svpetry/Mini8086/VGA/amber.bmp

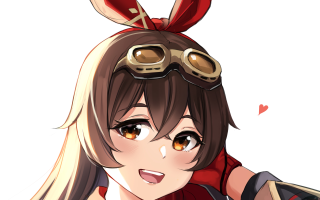
VGA/amber.bmp
