svpetry/Mini8086/VGA/kizuna-ai.bmp

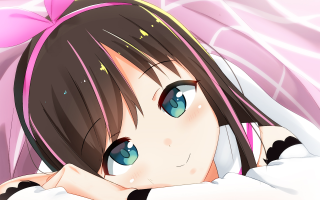
VGA/kizuna-ai.bmp
