svpetry/Mini8086/Documents/special_keys.md

# ASCII codes for special keys

| code | key |
| --- | --- |
| 0x01 | left |
| 0x02 | up |
| 0x03 | right |
| 0x04 | down |
| 0x05 | home |
| 0x06 | end |
| 0x07 | pause/break |
| 0x08 | backspace |
| 0x09 | tab |
| 0x0A | new line |
| 0x0B | page up |
| 0x0C | page down |
| 0x0D | carriage return |
| 0x0E | |
| 0x0F | F1 |
| 0x10 | F2 |
| 0x11 | F3 |
| 0x12 | F4 |
| 0x13 | F5 |
| 0x14 | F6 |
| 0x15 | F7 |
| 0x16 | F8 |
| 0x17 | F9 |
| 0x18 | F10 |
| 0x19 | F11 |
| 0x1A | F12 |
| 0x1B | escape |
| 0x1C | insert |
| 0x1D | |
| 0x1E | |
| 0x1F | |
