svpetry/Mini8086/Documents/I2C.md

| device | address |
| --- | --- |
| BME280 Sensor	| 0x77 |
| DS1307 RTC | 0x68 |
| M24C04 EEprom | 0x50 (1010_A2_A1_A0) |
