svpetry/Mini8086/Documents/memory map.md

# 64K / block

|||
|---|---|
| 00000-0FFFF | RAM (256 KB) |
| 10000-1FFFF | RAM (256 KB) |
| 20000-2FFFF | RAM (256 KB) |
| 30000-3FFFF | RAM (256 KB) |
| 40000-4FFFF | RAM (512 KB) |
| 50000-5FFFF | RAM (512 KB) |
| 60000-6FFFF | RAM (512 KB) |
| 70000-7FFFF | RAM (512 KB) |
| 80000-8FFFF | RAM bank switchable (768+ KB) |
| 90000-9FFFF | RAM bank switchable (768+ KB) |
| A0000-AFFFF | RAM bank switchable (768+ KB) |
| B0000-BFFFF | RAM bank switchable (768+ KB) |
| C0000-CFFFF | Video RAM |
| D0000-DFFFF | Video RAM |
| E0000-EFFFF | ROM |
| F0000-FFFFF | ROM |

---

|||
|---|---|
| 00000-003FF | 8086 interrupt vectors |
| 00400-03FFF | BIOS data area |
| 04000-05000 | BIOS screen buffer |
| 05000-0FFFF | OS kernel code + data |
| 10000-xxxxx | user code |
