svpetry/Mini8086/Documents/other/5160_speaker_circuit.jpg

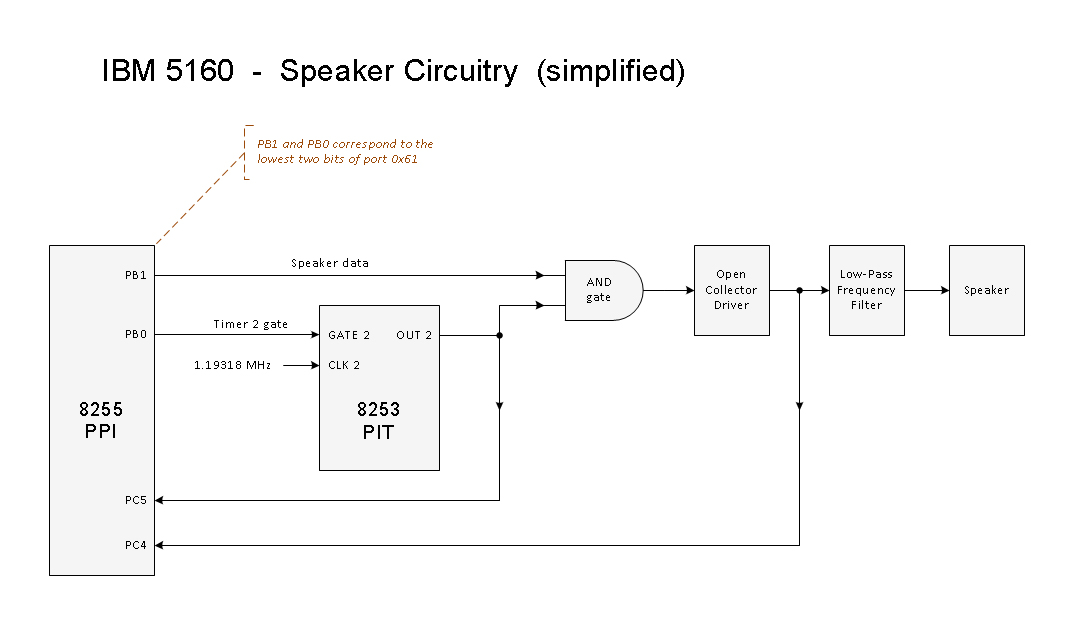
Documents/other/5160_speaker_circuit.jpg
