svpetry/Mini8086/Documents/other/8086sch.gif

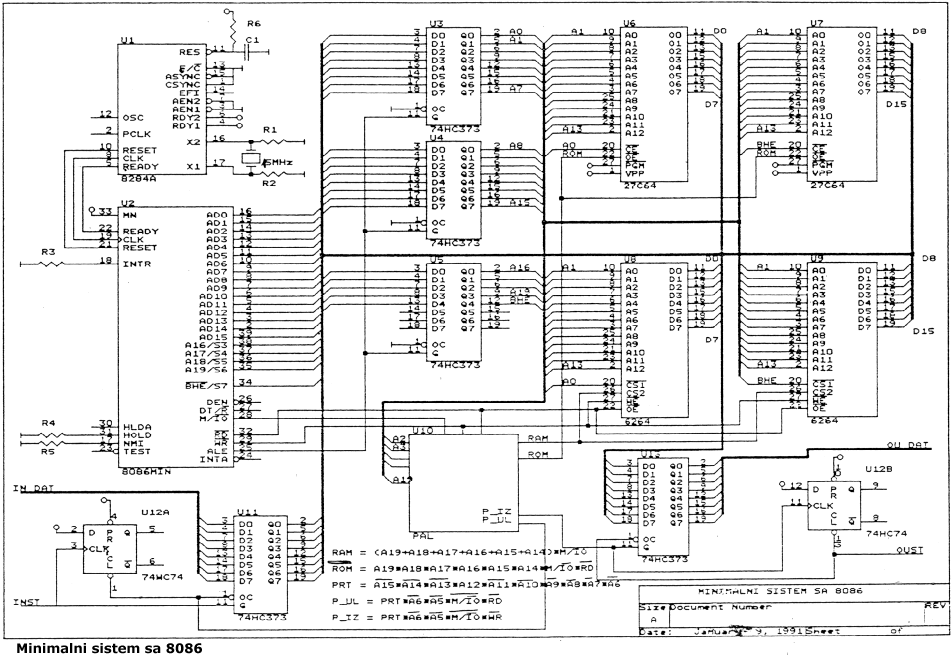
Documents/other/8086sch.gif
