svpetry/Mini8086/Documents/other/blockdiag_pc.png

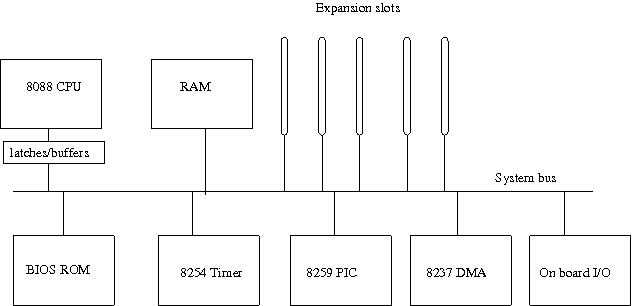
Documents/other/blockdiag_pc.png
