svpetry/Mini8086/Documents/other/EvenOdd.jpg

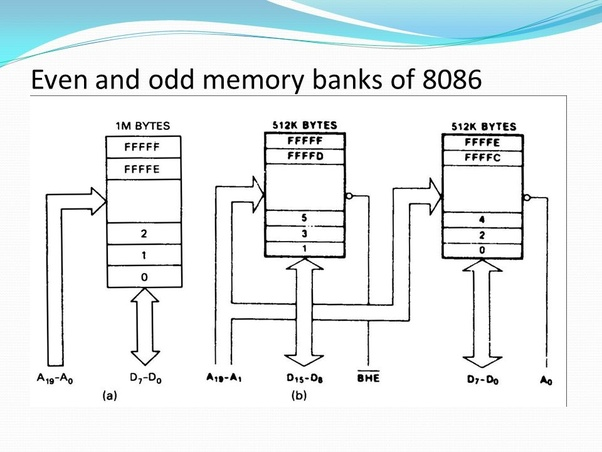
Documents/other/EvenOdd.jpg
