svpetry/Mini8086/Documents/other/freqdoubler.gif

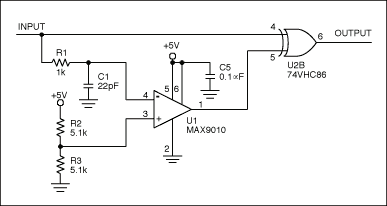
Documents/other/freqdoubler.gif
