svpetry/Mini8086/Documents/other/IBM 5170 - Keyboard interface - levels.png

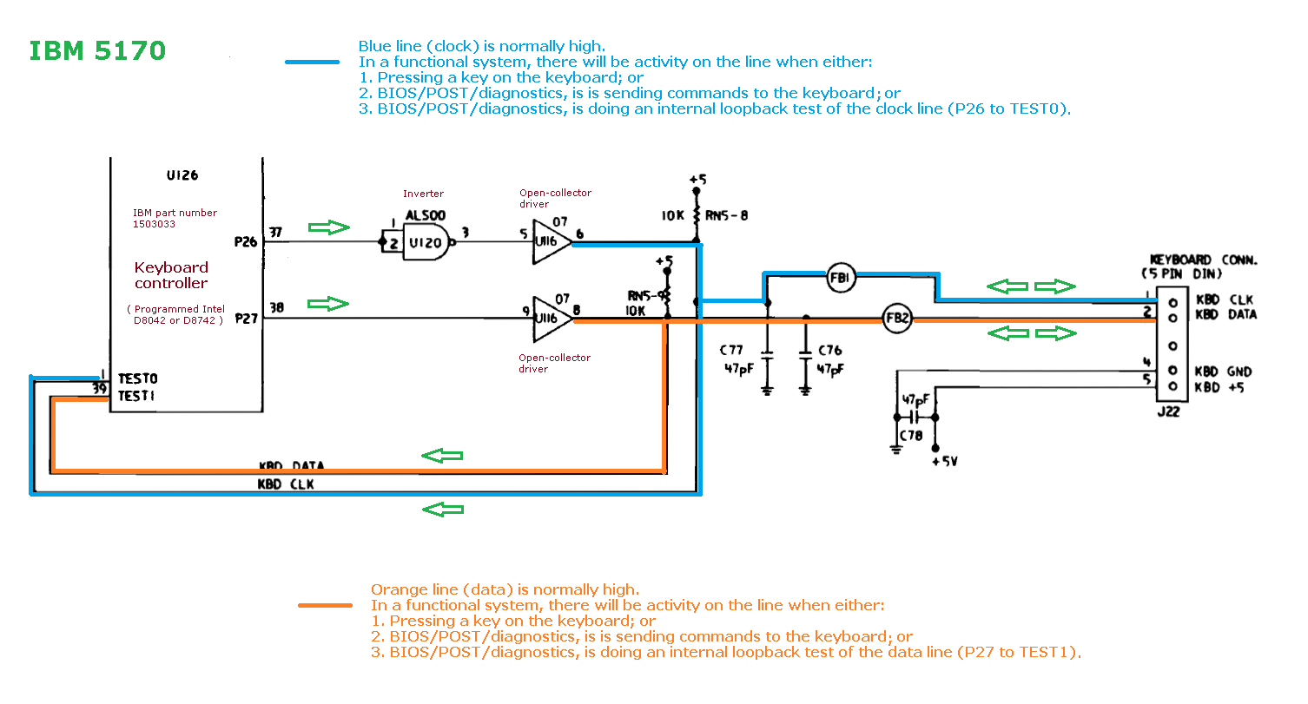
Documents/other/IBM 5170 - Keyboard interface - levels.png
