svpetry/Mini8086/Documents/other/ibm_pc_xt_block_diagram.png

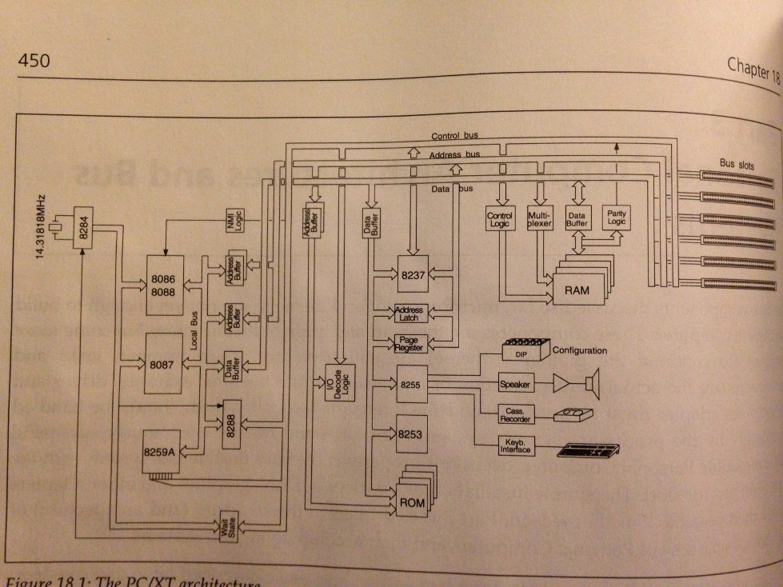
Documents/other/ibm_pc_xt_block_diagram.png
