svpetry/Mini8086/Documents/other/IMG_20171129_232521.jpg

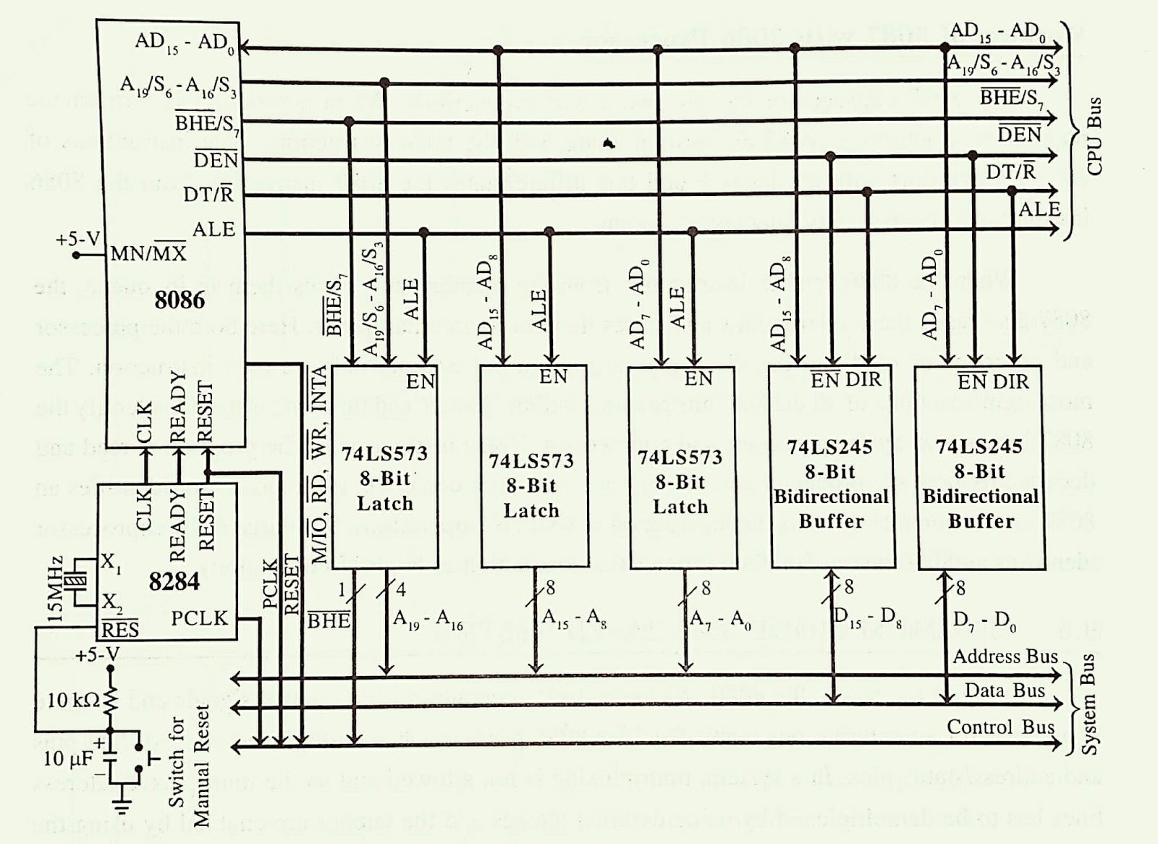
Documents/other/IMG_20171129_232521.jpg
