svpetry/Mini8086/Documents/other/maximum mode 8086 system.jpg

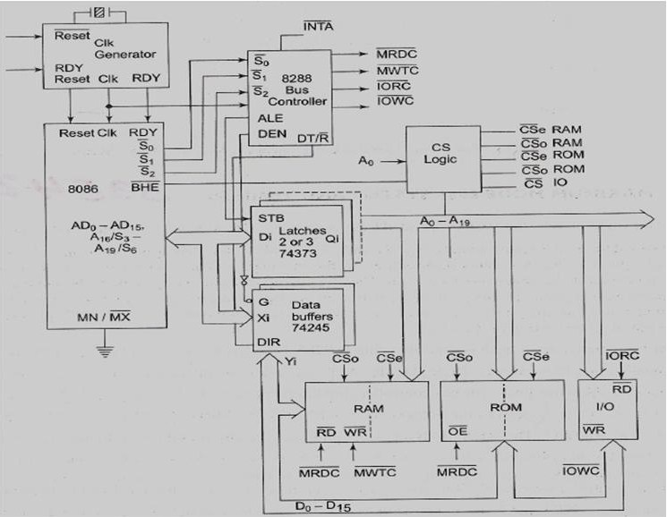
Documents/other/maximum mode 8086 system.jpg
