svpetry/Mini8086/Documents/other/MemoryBanks.jpg

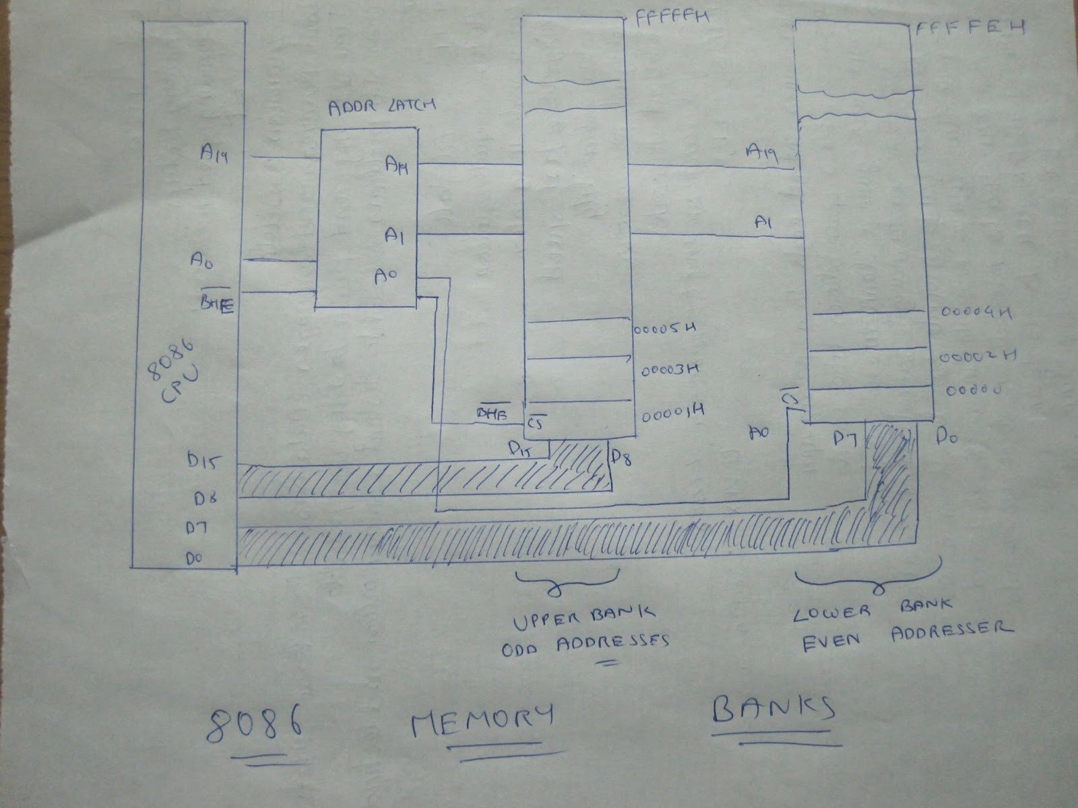
Documents/other/MemoryBanks.jpg
