svpetry/Mini8086/Documents/other/PS2+Keyboard+Scan+Codes.jpg

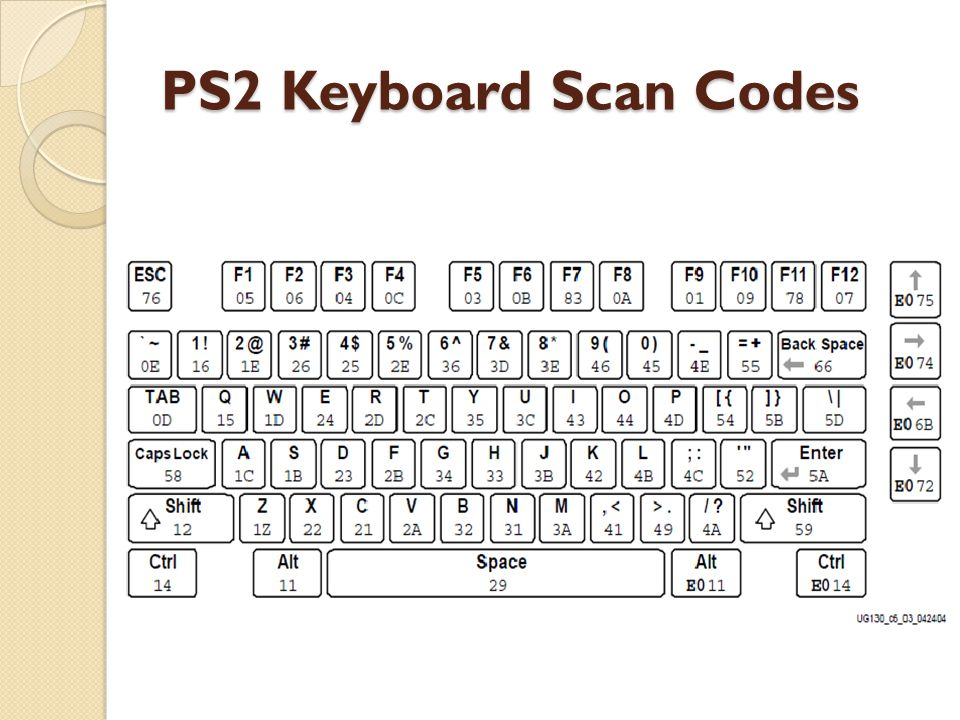
Documents/other/PS2+Keyboard+Scan+Codes.jpg
