svpetry/Mini8086/Documents/other/VGA pinout.jpg

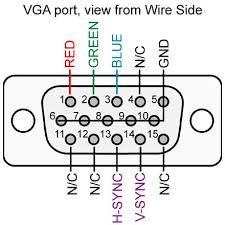
Documents/other/VGA pinout.jpg
