svpetry/Mini8086/VGA/Paimon.bmp

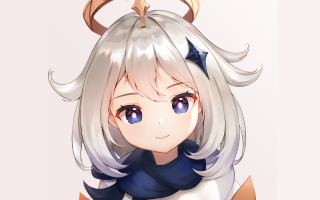
VGA/Paimon.bmp
