svpetry/Mini8086/KiCad/io_board_v2/io_board.kicad_pcb

## KiCad design KiCad/io_board_v2/io_board.kicad_pcb (2023-02-26)

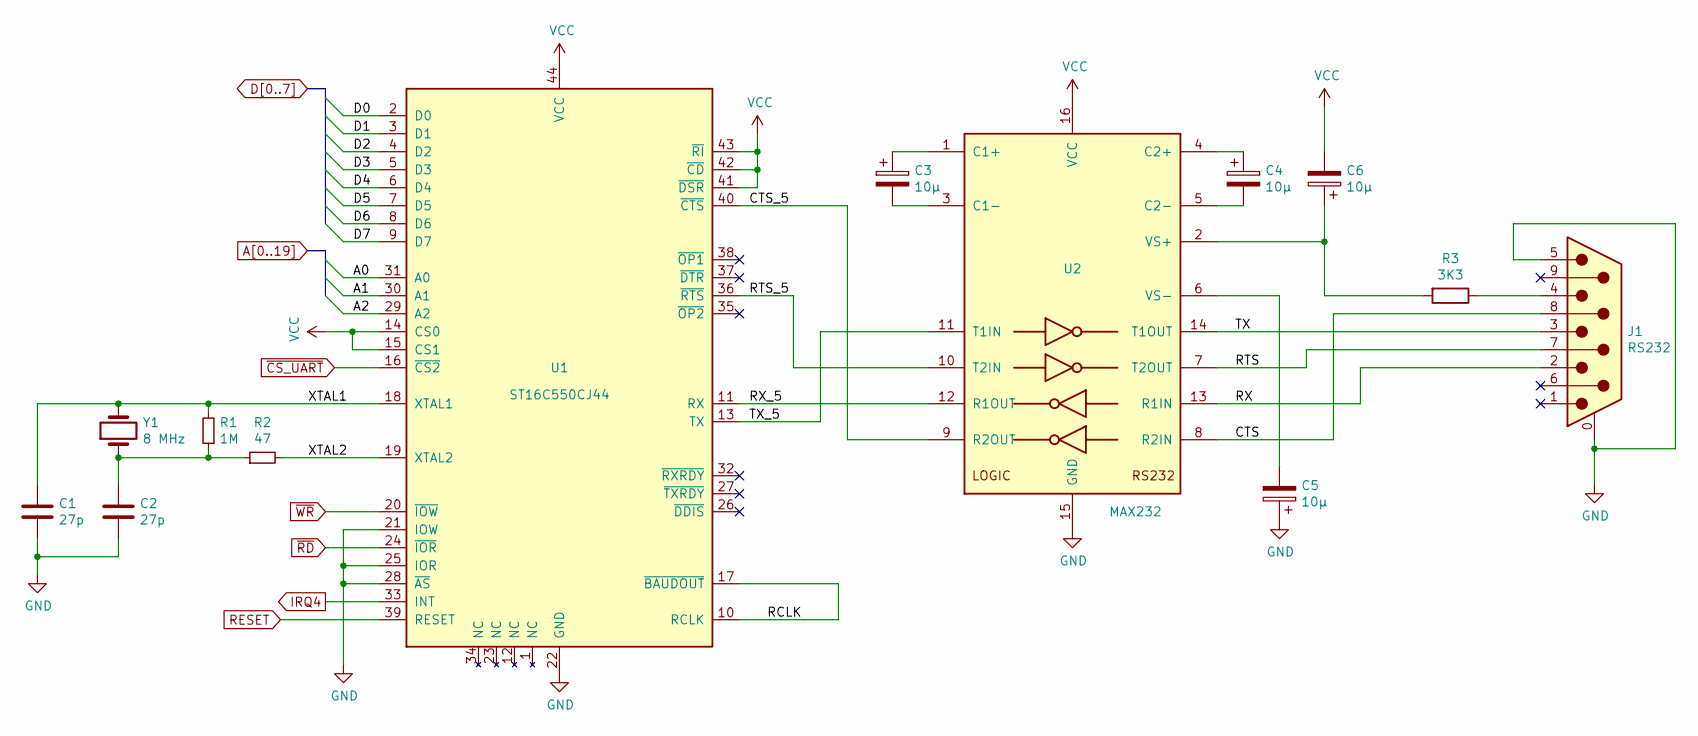
[picture p33: schematic serial.kicad_sch, Mini8086 I/O board]

Parts:
C1, C2: 27p; C_1206_3216Metric
C3, C4, C5, C6: 10µ; CP_Elec_4x3.9
J1: RS232; DSUB-9_Male_Horizontal_P2.77x2.84mm_EdgePinOffset4.94mm_Hou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
R1: 1M; R_1206_3216Metric
R2: 47; R_1206_3216Metric
R3: 3K3; R_1206_3216Metric
U1: ST16C550CJ44; PLCC-44_THT-Socket
U2: MAX232; SOIC-16_3.9x9.9mm_P1.27mm
Y1: 8 MHz; Crystal_HC49-U_Vertical

Connections:
/serial/CTS: J1.8, U2.8 (R2IN)
/serial/CTS_5: U1.40 (~CTS), U2.9 (R2OUT)
/serial/RCLK: U1.10 (RCLK), U1.17 (~BAUDOUT)
/serial/RTS: J1.7, U2.7 (T2OUT)
/serial/RTS_5: U1.36 (~RTS), U2.10 (T2IN)
/serial/RX: J1.2, U2.13 (R1IN)
/serial/RX_5: U1.11 (RX), U2.12 (R1OUT)
/serial/TX: J1.3, U2.14 (T1OUT)
/serial/TX_5: U1.13 (TX), U2.11 (T1IN)
/serial/XTAL1: C1.1, R1.2, U1.18 (XTAL1), Y1.2
/serial/XTAL2: R2.2, U1.19 (XTAL2)
A0: U1.31 (A0); also elsewhere on the board
A1: U1.30 (A1); also elsewhere on the board
A2: U1.29 (A2); also elsewhere on the board
D0: U1.2 (D0); also elsewhere on the board
D1: U1.3 (D1); also elsewhere on the board
D2: U1.4 (D2); also elsewhere on the board
D3: U1.5 (D3); also elsewhere on the board
D4: U1.6 (D4); also elsewhere on the board
D5: U1.7 (D5); also elsewhere on the board
D6: U1.8 (D6); also elsewhere on the board
D7: U1.9 (D7); also elsewhere on the board
GND: C1.2, C2.2, C5.1, J1.0 (PAD), J1.5, U1.21 (IOW), U1.22 (GND), U1.25 (IOR), U1.28 (~AS), U2.15 (GND); also elsewhere on the board
IRQ4: U1.33 (INT); also elsewhere on the board
unnamed: C2.1, R1.1, R2.1, Y1.1
unnamed: J1.4, R3.1
unnamed: C3.1, U2.1 (C1+)
unnamed: C3.2, U2.3 (C1-)
unnamed: C4.1, U2.4 (C2+)
unnamed: C4.2, U2.5 (C2-)
unnamed: C6.1, R3.2, U2.2 (VS+)
unnamed: C5.2, U2.6 (VS-)
RESET: U1.39 (RESET); also elsewhere on the board
VCC: C6.2, U1.14 (CS0), U1.15 (CS1), U1.41 (~DSR), U1.42 (~CD), U1.43 (~RI), U1.44 (VCC), U2.16 (VCC); also elsewhere on the board
~CS_UART: U1.16 (~CS2); also elsewhere on the board
~RD: U1.24 (~IOR); also elsewhere on the board
~WR: U1.20 (~IOW); also elsewhere on the board

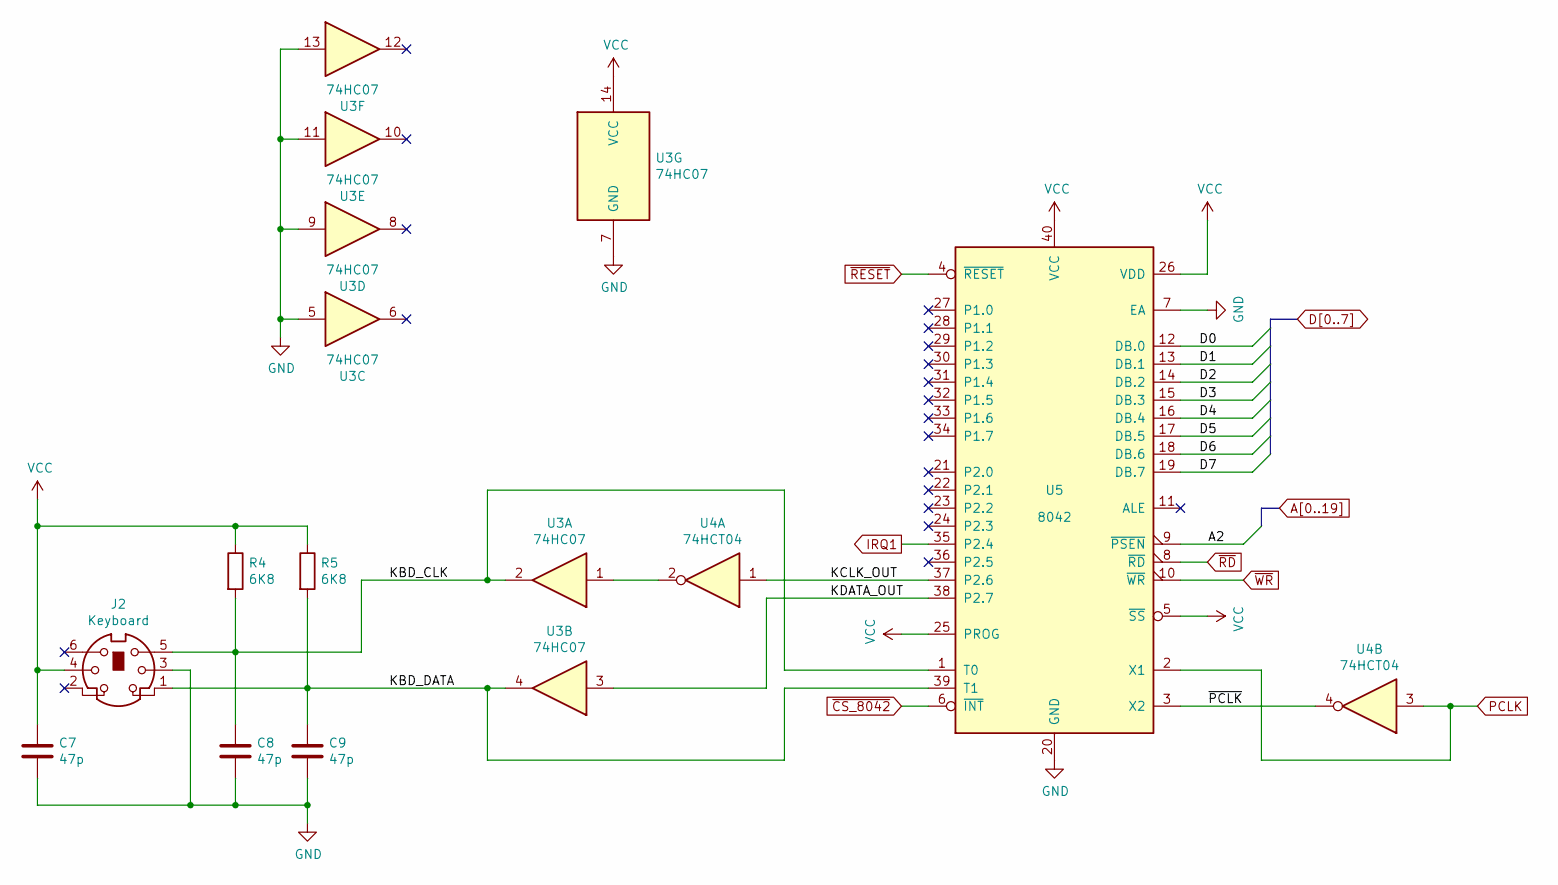
[picture p34: schematic PS2.kicad_sch, Mini8086 I/O board]

Parts:
C7, C8, C9: 47p; C_1206_3216Metric
J2: Keyboard; Mini_din6
R4, R5: 6K8; R_1206_3216Metric
U3: 74HC07; SOIC-14_3.9x8.7mm_P1.27mm
U4: 74HCT04; SOIC-14_3.9x8.7mm_P1.27mm
U5: 8042; DIP-40_W15.24mm_Socket_LongPads

Connections:
/PS2/KBD_CLK: C8.1, J2.5, R4.2, U3.2, U5.1 (T0)
/PS2/KBD_DATA: C9.1, J2.1, R5.2, U3.4, U5.39 (T1)
/PS2/KCLK_OUT: U4.1, U5.37 (P2.6)
/PS2/KDATA_OUT: U3.3, U5.38 (P2.7)
/PS2/~PCLK: U4.4, U5.3 (X2)
A2: U5.9 (~PSEN); also elsewhere on the board
D0: U5.12 (DB.0); also elsewhere on the board
D1: U5.13 (DB.1); also elsewhere on the board
D2: U5.14 (DB.2); also elsewhere on the board
D3: U5.15 (DB.3); also elsewhere on the board
D4: U5.16 (DB.4); also elsewhere on the board
D5: U5.17 (DB.5); also elsewhere on the board
D6: U5.18 (DB.6); also elsewhere on the board
D7: U5.19 (DB.7); also elsewhere on the board
GND: C7.2, C8.2, C9.2, J2.3, U3.5, U3.7 (GND), U3.9, U3.11, U3.13, U5.7 (EA), U5.20 (GND); also elsewhere on the board
IRQ1: U5.35 (P2.4); also elsewhere on the board
unnamed: U3.1, U4.2
PCLK: U4.3, U5.2 (X1); also elsewhere on the board
VCC: C7.1, J2.4, R4.1, R5.1, U3.14 (VCC), U5.5 (~SS), U5.25 (PROG), U5.26 (VDD), U5.40 (VCC); also elsewhere on the board
~CS_8042: U5.6 (~INT); also elsewhere on the board
~RD: U5.8 (~RD); also elsewhere on the board
~RESET: U5.4 (~RESET); also elsewhere on the board
~WR: U5.10 (~WR); also elsewhere on the board

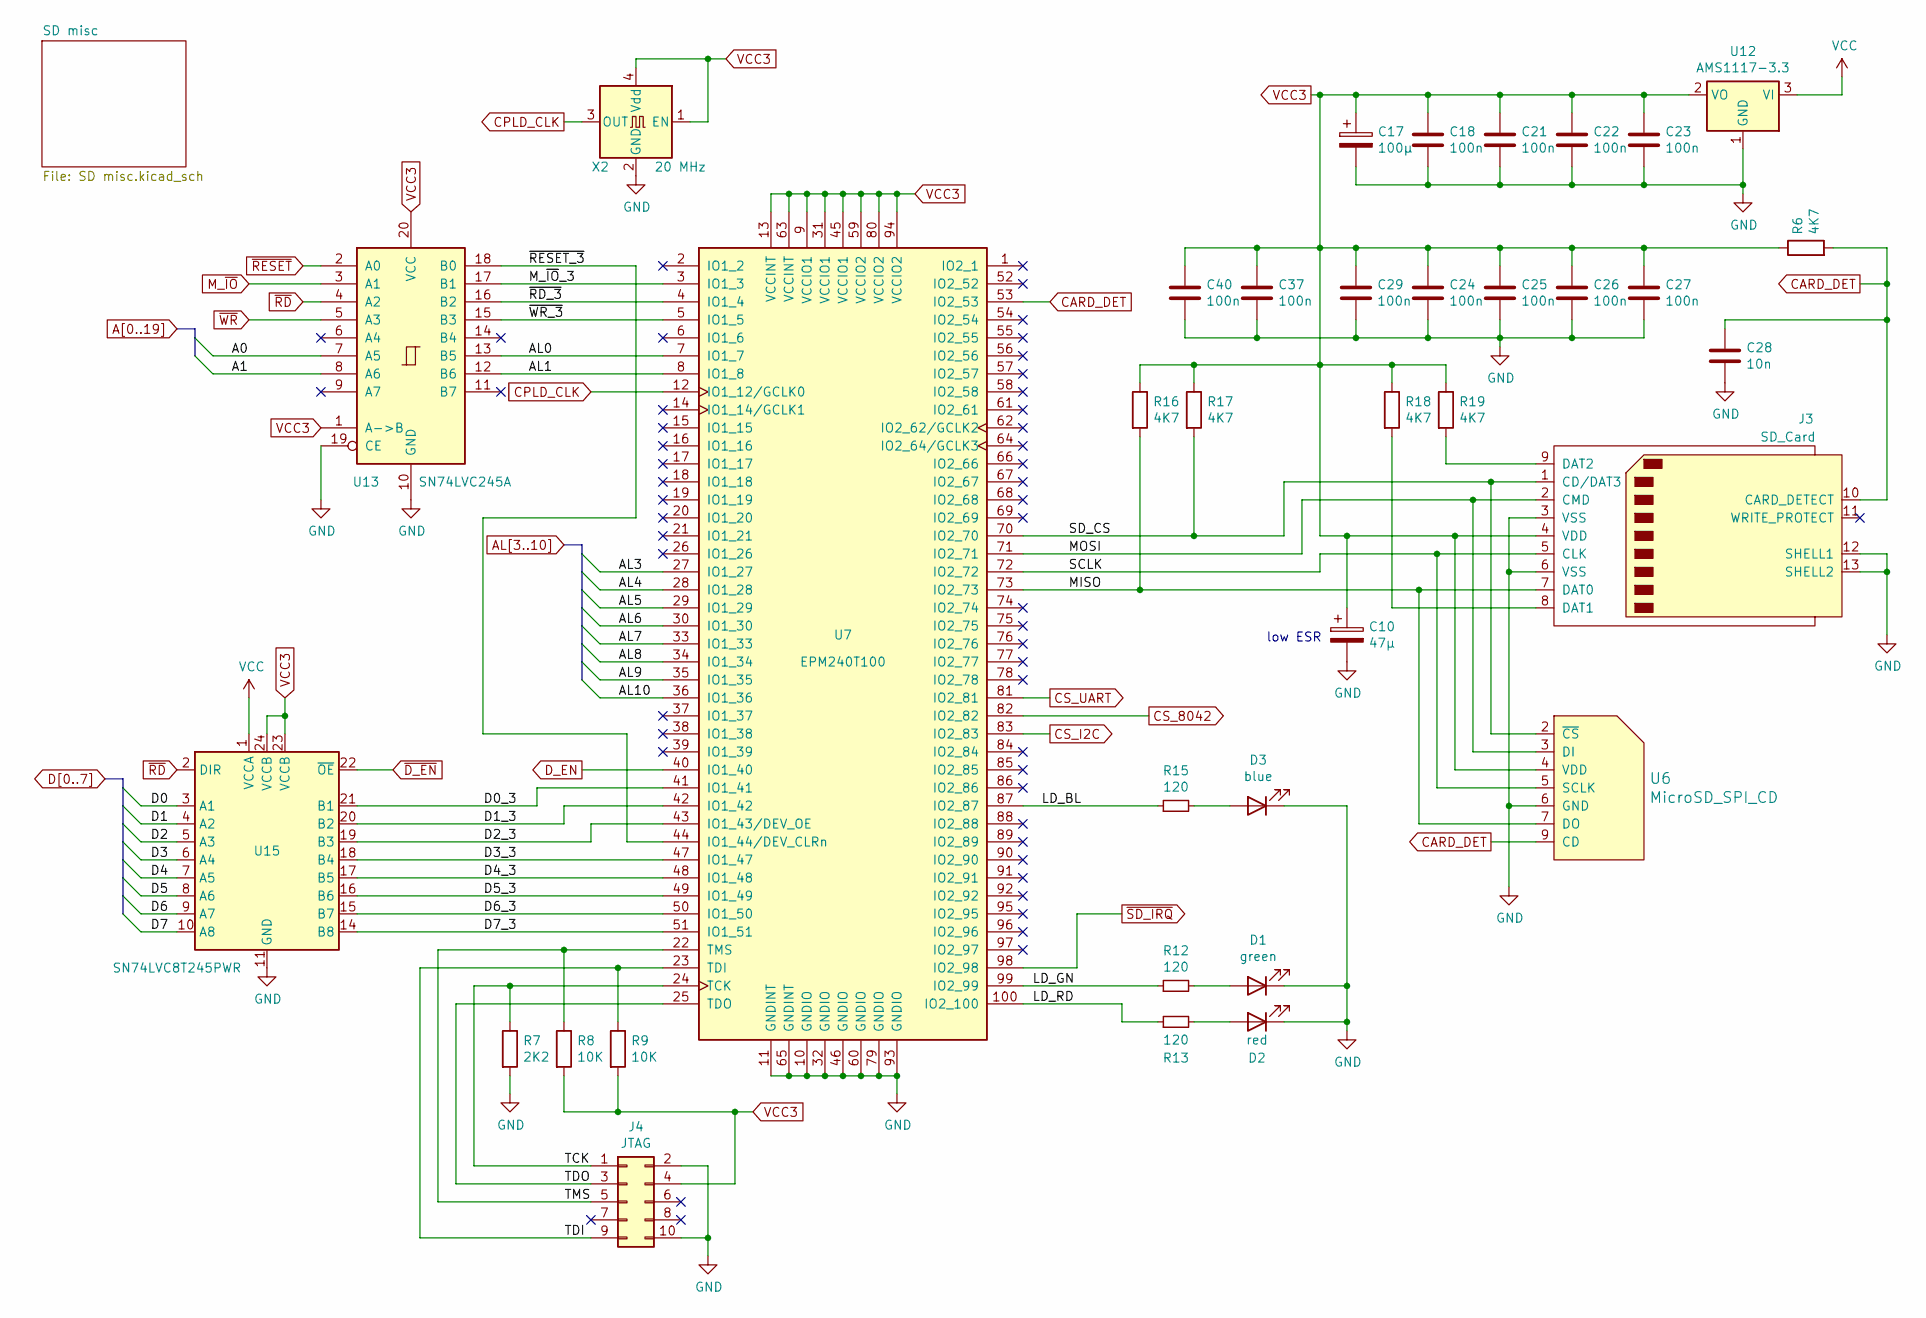
[picture p35: schematic SD drive.kicad_sch, Mini8086 I/O board]

Parts:
C10: 47µ; CP_Elec_5x5.4
C17: 100µ; CP_Elec_5x5.4
C18, C22, C24, C25, C26, C29, C37, C40: 100n; C_1206_3216Metric
C21, C23, C27: 100n; C_0805_2012Metric
C28: 10n; C_1206_3216Metric
D1: green; LED_1206_3216Metric
D2: red; LED_1206_3216Metric
D3: blue; LED_1206_3216Metric
J3: SD_Card; SD_TE_2041021
J4: JTAG; IDC-Header_2x05_P2.54mm_Vertical
R6, R16, R17, R18, R19: 4K7; R_1206_3216Metric
R7: 2K2; R_1206_3216Metric
R8, R9: 10K; R_1206_3216Metric
R12, R13, R15: 120; R_1206_3216Metric
U6: MicroSD_SPI_CD; GCT-MEM2055-00-190-01-A
U7: EPM240T100; LQFP-100_14x14mm_P0.5mm
U12: AMS1117-3.3; SOT-223-3_TabPin2
U13: SN74LVC245A; TSSOP-20_4.4x6.5mm_P0.65mm
U15: SN74LVC8T245PWR; TSSOP-24_4.4x7.8mm_P0.65mm
X2: 20 MHz; Oscillator_SMD_Abracon_ASV-4Pin_7.0x5.1mm

Connections:
/SD drive/AL0: U7.7 (IO1_7), U13.13 (B5)
/SD drive/AL1: U7.8 (IO1_8), U13.12 (B6)
/SD drive/D0_3: U7.41 (IO1_41), U15.21 (B1)
/SD drive/D1_3: U7.42 (IO1_42), U15.20 (B2)
/SD drive/D2_3: U7.43 (IO1_43/DEV_OE), U15.19 (B3)
/SD drive/D3_3: U7.47 (IO1_47), U15.18 (B4)
/SD drive/D4_3: U7.48 (IO1_48), U15.17 (B5)
/SD drive/D5_3: U7.49 (IO1_49), U15.16 (B6)
/SD drive/D6_3: U7.50 (IO1_50), U15.15 (B7)
/SD drive/D7_3: U7.51 (IO1_51), U15.14 (B8)
/SD drive/LD_BL: R15.1, U7.87 (IO2_87)
/SD drive/LD_GN: R12.1, U7.99 (IO2_99)
/SD drive/LD_RD: R13.1, U7.100 (IO2_100)
/SD drive/MISO: J3.7 (DAT0), R16.2, U6.7 (DO), U7.73 (IO2_73)
/SD drive/MOSI: J3.2 (CMD), U6.3 (DI), U7.71 (IO2_71)
/SD drive/M_~IO_3: U7.3 (IO1_3), U13.17 (B1)
/SD drive/SCLK: J3.5 (CLK), U6.5 (SCLK), U7.72 (IO2_72)
/SD drive/SD_CS: J3.1 (CD/DAT3), R17.2, U6.2 (~CS), U7.70 (IO2_70)
/SD drive/TCK: J4.1, R7.1, U7.24 (TCK)
/SD drive/TDI: J4.9, R9.1, U7.23 (TDI)
/SD drive/TDO: J4.3, U7.25 (TDO)
/SD drive/TMS: J4.5, R8.1, U7.22 (TMS)
/SD drive/~RD_3: U7.4 (IO1_4), U13.16 (B2)
/SD drive/~RESET_3: U7.44 (IO1_44/DEV_CLRn), U13.18 (B0)
/SD drive/~WR_3: U7.5 (IO1_5), U13.15 (B3)
A0: U13.7 (A5); also elsewhere on the board
A1: U13.8 (A6); also elsewhere on the board
AL3: U7.27 (IO1_27); also elsewhere on the board
AL4: U7.28 (IO1_28); also elsewhere on the board
AL5: U7.29 (IO1_29); also elsewhere on the board
AL6: U7.30 (IO1_30); also elsewhere on the board
AL7: U7.33 (IO1_33); also elsewhere on the board
AL8: U7.34 (IO1_34); also elsewhere on the board
AL9: U7.35 (IO1_35); also elsewhere on the board
AL10: U7.36 (IO1_36); also elsewhere on the board
CARD_DET: C28.1, J3.10 (CARD_DETECT), R6.2, U6.9 (CD), U7.53 (IO2_53)
CPLD_CLK: U7.12 (IO1_12/GCLK0), X2.3 (OUT)
CS_8042: U7.82 (IO2_82); also elsewhere on the board
CS_I2C: U7.83 (IO2_83); also elsewhere on the board
CS_UART: U7.81 (IO2_81); also elsewhere on the board
D0: U15.3 (A1); also elsewhere on the board
D1: U15.4 (A2); also elsewhere on the board
D2: U15.5 (A3); also elsewhere on the board
D3: U15.6 (A4); also elsewhere on the board
D4: U15.7 (A5); also elsewhere on the board
D5: U15.8 (A6); also elsewhere on the board
D6: U15.9 (A7); also elsewhere on the board
D7: U15.10 (A8); also elsewhere on the board
D_EN: U7.40 (IO1_40); also elsewhere on the board
GND: C10.2, C17.2, C18.2, C21.2, C22.2, C23.2, C24.2, C25.2, C26.2, C27.2, C28.2, C29.2, C37.2, C40.2, D1.1 (K), D2.1 (K), D3.1 (K), J3.3 (VSS), J3.6 (VSS), J3.12 (SHELL1), J3.13 (SHELL2), J4.2, J4.10, R7.2, U6.6 (GND), U7.10 (GNDIO), U7.11 (GNDINT), U7.32 (GNDIO), U7.46 (GNDIO), U7.60 (GNDIO), U7.65 (GNDINT), U7.79 (GNDIO), U7.93 (GNDIO), U12.1 (GND), U13.10 (GND), U13.19 (CE), U15.11 (GND), U15.12 (GND), U15.13 (GND), X2.2 (GND); also elsewhere on the board
M_~IO: U13.3 (A1); also elsewhere on the board
unnamed: D1.2 (A), R12.2
unnamed: D2.2 (A), R13.2
unnamed: D3.2 (A), R15.2
unnamed: J3.8 (DAT1), R18.2
unnamed: J3.9 (DAT2), R19.2
VCC: U12.3 (VI), U15.1 (VCCA); also elsewhere on the board
VCC3: C10.1, C17.1, C18.1, C21.1, C22.1, C23.1, C24.1, C25.1, C26.1, C27.1, C29.1, C37.1, C40.1, J3.4 (VDD), J4.4, R6.1, R8.2, R9.2, R16.1, R17.1, R18.1, R19.1, U6.4 (VDD), U7.9 (VCCIO1), U7.13 (VCCINT), U7.31 (VCCIO1), U7.45 (VCCIO1), U7.59 (VCCIO2), U7.63 (VCCINT), U7.80 (VCCIO2), U7.94 (VCCIO2), U12.2 (VO), U13.1 (A->B), U13.20 (VCC), U15.23 (VCCB), U15.24 (VCCB), X2.1 (EN), X2.4 (Vdd); also elsewhere on the board
~D_EN: U15.22 (~OE); also elsewhere on the board
~RD: U13.4 (A2), U15.2 (DIR); also elsewhere on the board
~RESET: U13.2 (A0); also elsewhere on the board
~SD_IRQ: U7.98 (IO2_98); also elsewhere on the board
~WR: U13.5 (A3); also elsewhere on the board

Notes on the sheet:
low ESR

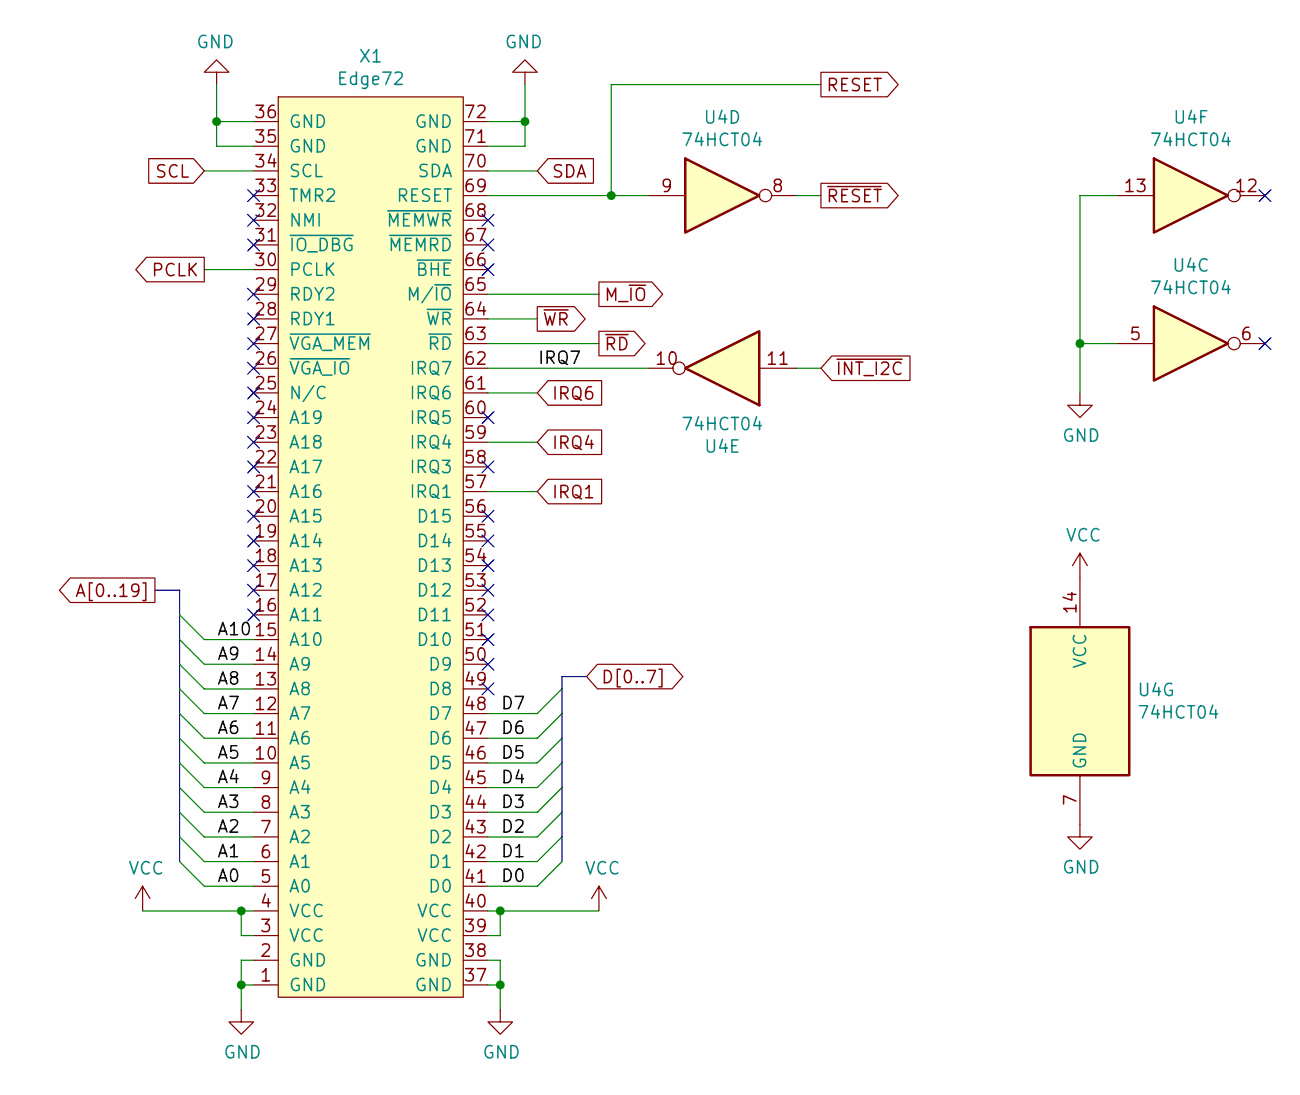
[picture p36: schematic connector.kicad_sch, Mini8086 I/O board]

Parts:
U4: 74HCT04; SOIC-14_3.9x8.7mm_P1.27mm
X1: Edge72; BUS_72

Connections:
/connector/IRQ7: U4.10, X1.62 (IRQ7)
A0: X1.5 (A0); also elsewhere on the board
A1: X1.6 (A1); also elsewhere on the board
A2: X1.7 (A2); also elsewhere on the board
A3: X1.8 (A3); also elsewhere on the board
A4: X1.9 (A4); also elsewhere on the board
A5: X1.10 (A5); also elsewhere on the board
A6: X1.11 (A6); also elsewhere on the board
A7: X1.12 (A7); also elsewhere on the board
A8: X1.13 (A8); also elsewhere on the board
A9: X1.14 (A9); also elsewhere on the board
A10: X1.15 (A10); also elsewhere on the board
D0: X1.41 (D0); also elsewhere on the board
D1: X1.42 (D1); also elsewhere on the board
D2: X1.43 (D2); also elsewhere on the board
D3: X1.44 (D3); also elsewhere on the board
D4: X1.45 (D4); also elsewhere on the board
D5: X1.46 (D5); also elsewhere on the board
D6: X1.47 (D6); also elsewhere on the board
D7: X1.48 (D7); also elsewhere on the board
GND: U4.5, U4.7 (GND), U4.13, X1.1 (GND), X1.2 (GND), X1.35 (GND), X1.36 (GND), X1.37 (GND), X1.38 (GND), X1.71 (GND), X1.72 (GND); also elsewhere on the board
IRQ1: X1.57 (IRQ1); also elsewhere on the board
IRQ4: X1.59 (IRQ4); also elsewhere on the board
IRQ6: X1.61 (IRQ6); also elsewhere on the board
M_~IO: X1.65 (M/~IO); also elsewhere on the board
PCLK: X1.30 (PCLK); also elsewhere on the board
RESET: U4.9, X1.69 (RESET); also elsewhere on the board
SCL: X1.34 (SCL); also elsewhere on the board
SDA: X1.70 (SDA); also elsewhere on the board
VCC: U4.14 (VCC), X1.3 (VCC), X1.4 (VCC), X1.39 (VCC), X1.40 (VCC); also elsewhere on the board
~INT_I2C: U4.11; also elsewhere on the board
~RD: X1.63 (~RD); also elsewhere on the board
~RESET: U4.8; also elsewhere on the board
~WR: X1.64 (~WR); also elsewhere on the board

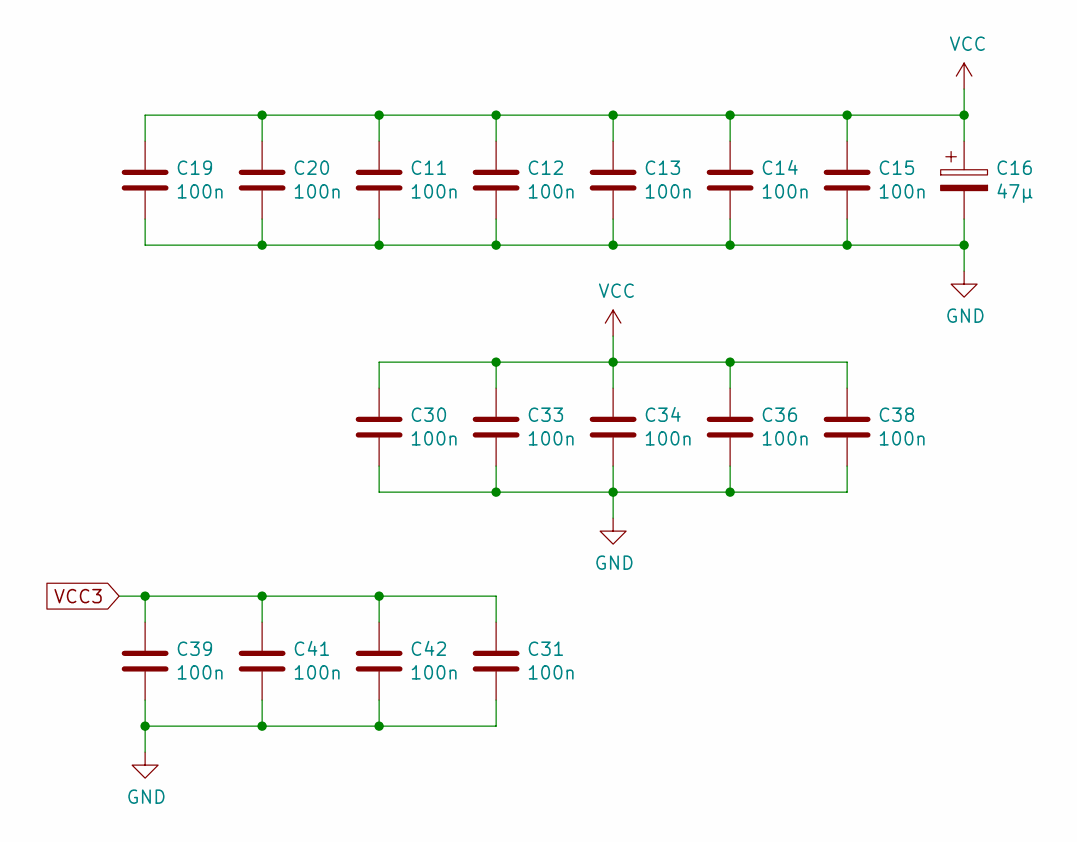
[picture p37: schematic misc.kicad_sch, Mini8086 I/O board]

Parts:
C11, C12, C13, C14, C15, C19, C20, C30, C33, C34, C36, C38, C39, C41, C42: 100n; C_1206_3216Metric
C16: 47µ; CP_Radial_D5.0mm_P2.00mm
C31: 100n; C_0805_2012Metric

Connections:
GND: C11.2, C12.2, C13.2, C14.2, C15.2, C16.2, C19.2, C20.2, C30.2, C31.2, C33.2, C34.2, C36.2, C38.2, C39.2, C41.2, C42.2; also elsewhere on the board
VCC: C11.1, C12.1, C13.1, C14.1, C15.1, C16.1, C19.1, C20.1, C30.1, C33.1, C34.1, C36.1, C38.1; also elsewhere on the board
VCC3: C31.1, C39.1, C41.1, C42.1; also elsewhere on the board

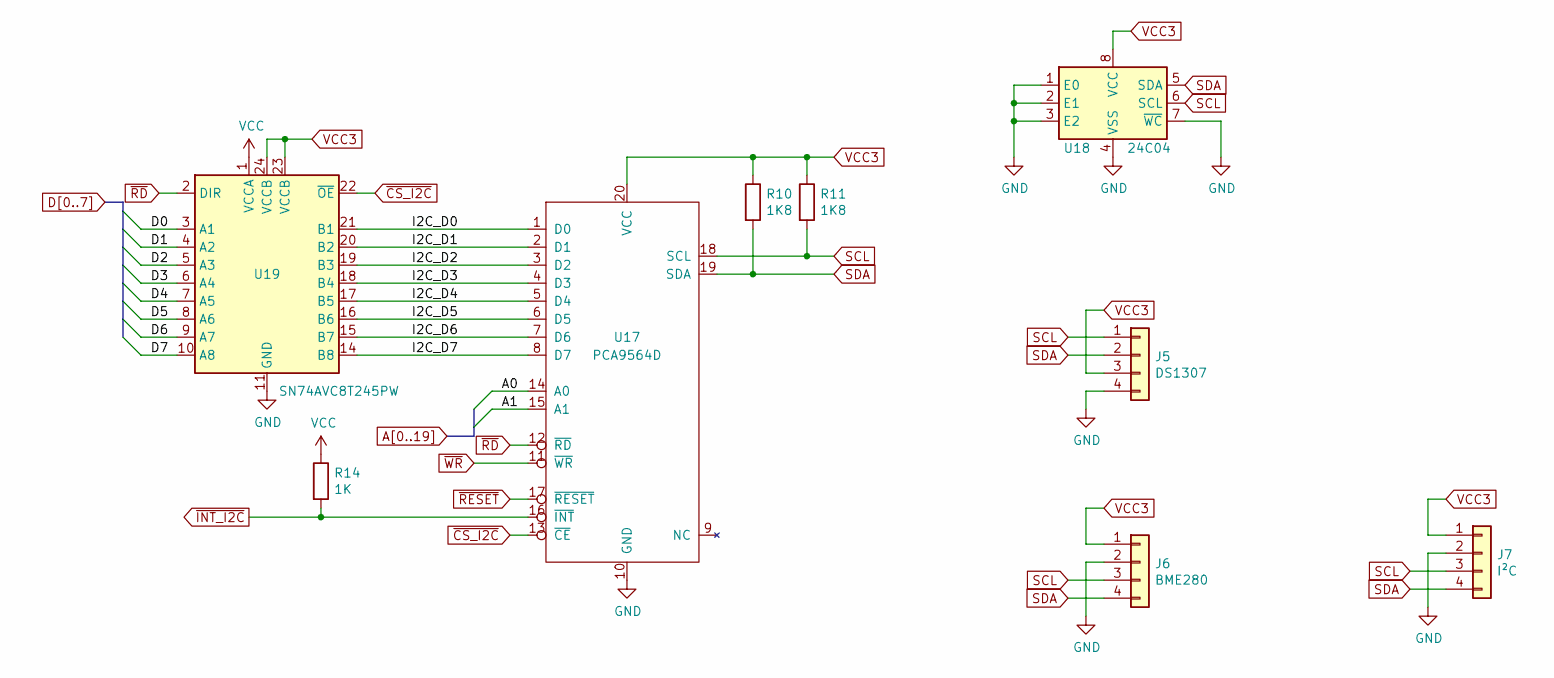
[picture p38: schematic I2C.kicad_sch, Mini8086 I/O board]

Parts:
J5: DS1307; PinHeader_1x04_P2.54mm_Vertical
J6: BME280; PinHeader_1x04_P2.54mm_Vertical
J7: I²C; PinHeader_1x04_P2.54mm_Vertical
R10, R11: 1K8; R_1206_3216Metric
R14: 1K; R_1206_3216Metric
U17: PCA9564D; SOIC-20W_7.5x12.8mm_P1.27mm
U18: 24C04; SOIC-8_3.9x4.9mm_P1.27mm
U19: SN74AVC8T245PW; TSSOP-24_4.4x7.8mm_P0.65mm

Connections:
/I2C/I2C_D0: U17.1 (D0), U19.21 (B1)
/I2C/I2C_D1: U17.2 (D1), U19.20 (B2)
/I2C/I2C_D2: U17.3 (D2), U19.19 (B3)
/I2C/I2C_D3: U17.4 (D3), U19.18 (B4)
/I2C/I2C_D4: U17.5 (D4), U19.17 (B5)
/I2C/I2C_D5: U17.6 (D5), U19.16 (B6)
/I2C/I2C_D6: U17.7 (D6), U19.15 (B7)
/I2C/I2C_D7: U17.8 (D7), U19.14 (B8)
A0: U17.14 (A0); also elsewhere on the board
A1: U17.15 (A1); also elsewhere on the board
D0: U19.3 (A1); also elsewhere on the board
D1: U19.4 (A2); also elsewhere on the board
D2: U19.5 (A3); also elsewhere on the board
D3: U19.6 (A4); also elsewhere on the board
D4: U19.7 (A5); also elsewhere on the board
D5: U19.8 (A6); also elsewhere on the board
D6: U19.9 (A7); also elsewhere on the board
D7: U19.10 (A8); also elsewhere on the board
GND: J5.4, J6.2, J7.2, U17.10 (GND), U18.1 (E0), U18.2 (E1), U18.3 (E2), U18.4 (VSS), U18.7 (~WC), U19.11 (GND), U19.12 (GND), U19.13 (GND); also elsewhere on the board
SCL: J5.1, J6.3, J7.3, R11.2, U17.18 (SCL), U18.6 (SCL); also elsewhere on the board
SDA: J5.2, J6.4, J7.4, R10.2, U17.19 (SDA), U18.5 (SDA); also elsewhere on the board
VCC: R14.1, U19.1 (VCCA); also elsewhere on the board
VCC3: J5.3, J6.1, J7.1, R10.1, R11.1, U17.20 (VCC), U18.8 (VCC), U19.23 (VCCB), U19.24 (VCCB); also elsewhere on the board
~CS_I2C: U17.13 (~CE), U19.22 (~OE); also elsewhere on the board
~INT_I2C: R14.2, U17.16 (~INT); also elsewhere on the board
~RD: U17.12 (~RD), U19.2 (DIR); also elsewhere on the board
~RESET: U17.17 (~RESET); also elsewhere on the board
~WR: U17.11 (~WR); also elsewhere on the board

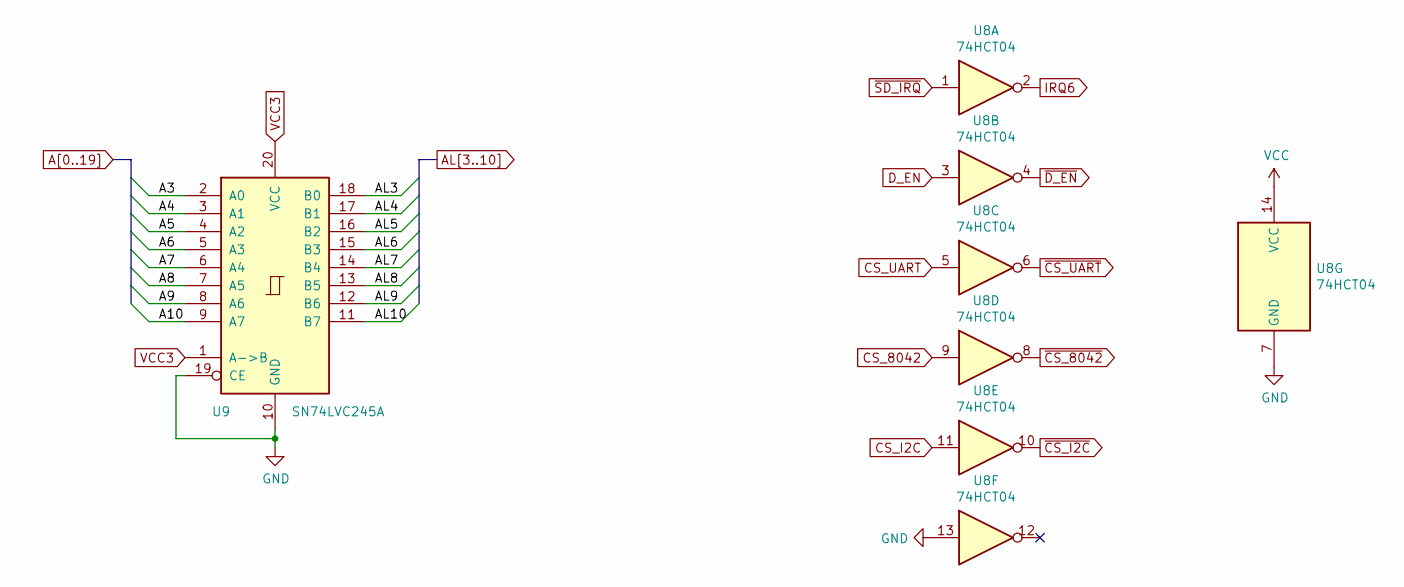
[picture p39: schematic SD misc.kicad_sch, Mini8086 I/O board]

Parts:
U8: 74HCT04; SOIC-14_3.9x8.7mm_P1.27mm
U9: SN74LVC245A; TSSOP-20_4.4x6.5mm_P0.65mm

Connections:
A3: U9.2 (A0); also elsewhere on the board
A4: U9.3 (A1); also elsewhere on the board
A5: U9.4 (A2); also elsewhere on the board
A6: U9.5 (A3); also elsewhere on the board
A7: U9.6 (A4); also elsewhere on the board
A8: U9.7 (A5); also elsewhere on the board
A9: U9.8 (A6); also elsewhere on the board
A10: U9.9 (A7); also elsewhere on the board
AL3: U9.18 (B0); also elsewhere on the board
AL4: U9.17 (B1); also elsewhere on the board
AL5: U9.16 (B2); also elsewhere on the board
AL6: U9.15 (B3); also elsewhere on the board
AL7: U9.14 (B4); also elsewhere on the board
AL8: U9.13 (B5); also elsewhere on the board
AL9: U9.12 (B6); also elsewhere on the board
AL10: U9.11 (B7); also elsewhere on the board
CS_8042: U8.9; also elsewhere on the board
CS_I2C: U8.11; also elsewhere on the board
CS_UART: U8.5; also elsewhere on the board
D_EN: U8.3; also elsewhere on the board
GND: U8.7 (GND), U8.13, U9.10 (GND), U9.19 (CE); also elsewhere on the board
IRQ6: U8.2; also elsewhere on the board
VCC: U8.14 (VCC); also elsewhere on the board
VCC3: U9.1 (A->B), U9.20 (VCC); also elsewhere on the board
~CS_8042: U8.8; also elsewhere on the board
~CS_I2C: U8.10; also elsewhere on the board
~CS_UART: U8.6; also elsewhere on the board
~D_EN: U8.4; also elsewhere on the board
~SD_IRQ: U8.1; also elsewhere on the board

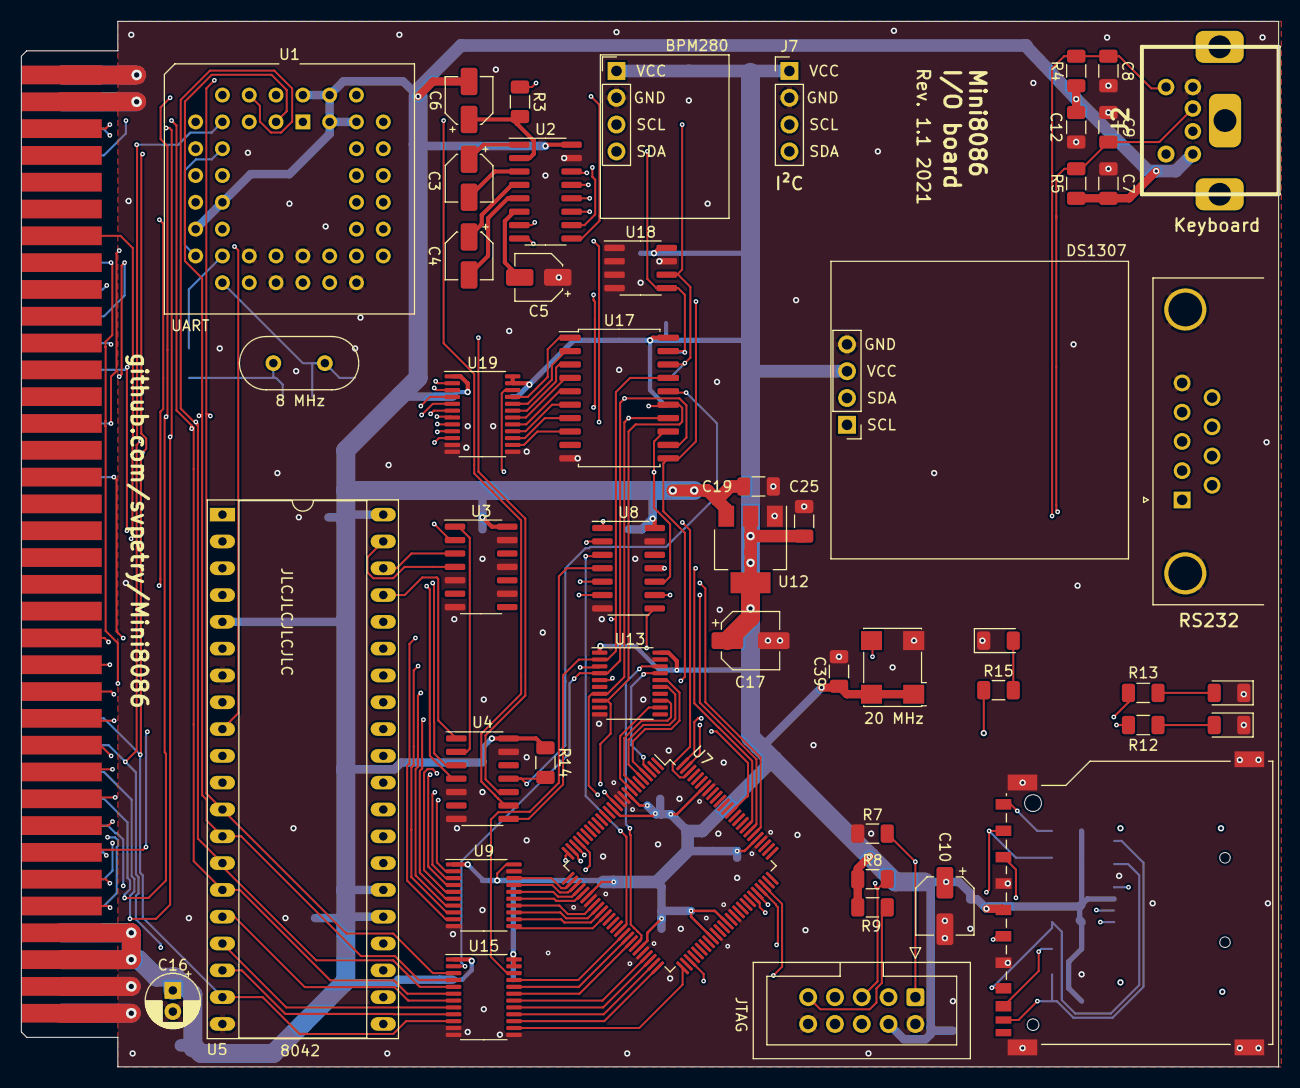
[picture p40: board io_board.kicad_pcb from above]

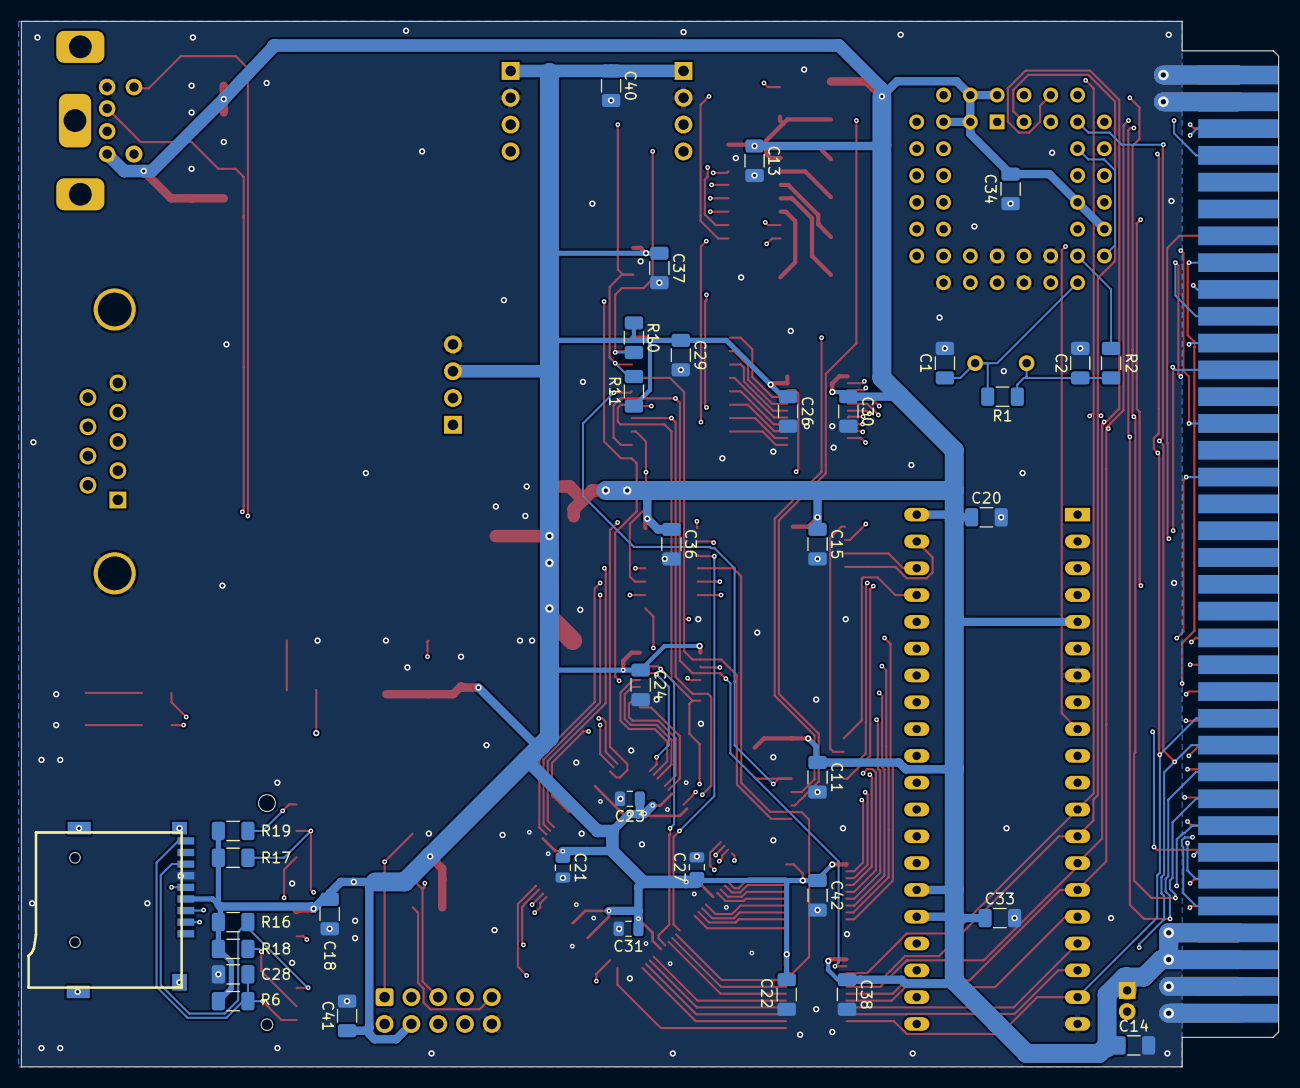
[picture p41: board io_board.kicad_pcb from below]

Board: 4 copper layers, 119.1 x 99.1 mm, 87 parts (36 on the bottom side), 117 nets.
