svpetry/Mini8086/KiCad/led_board/led_board.kicad_pcb

## KiCad design KiCad/led_board/led_board.kicad_pcb (2023-02-26)

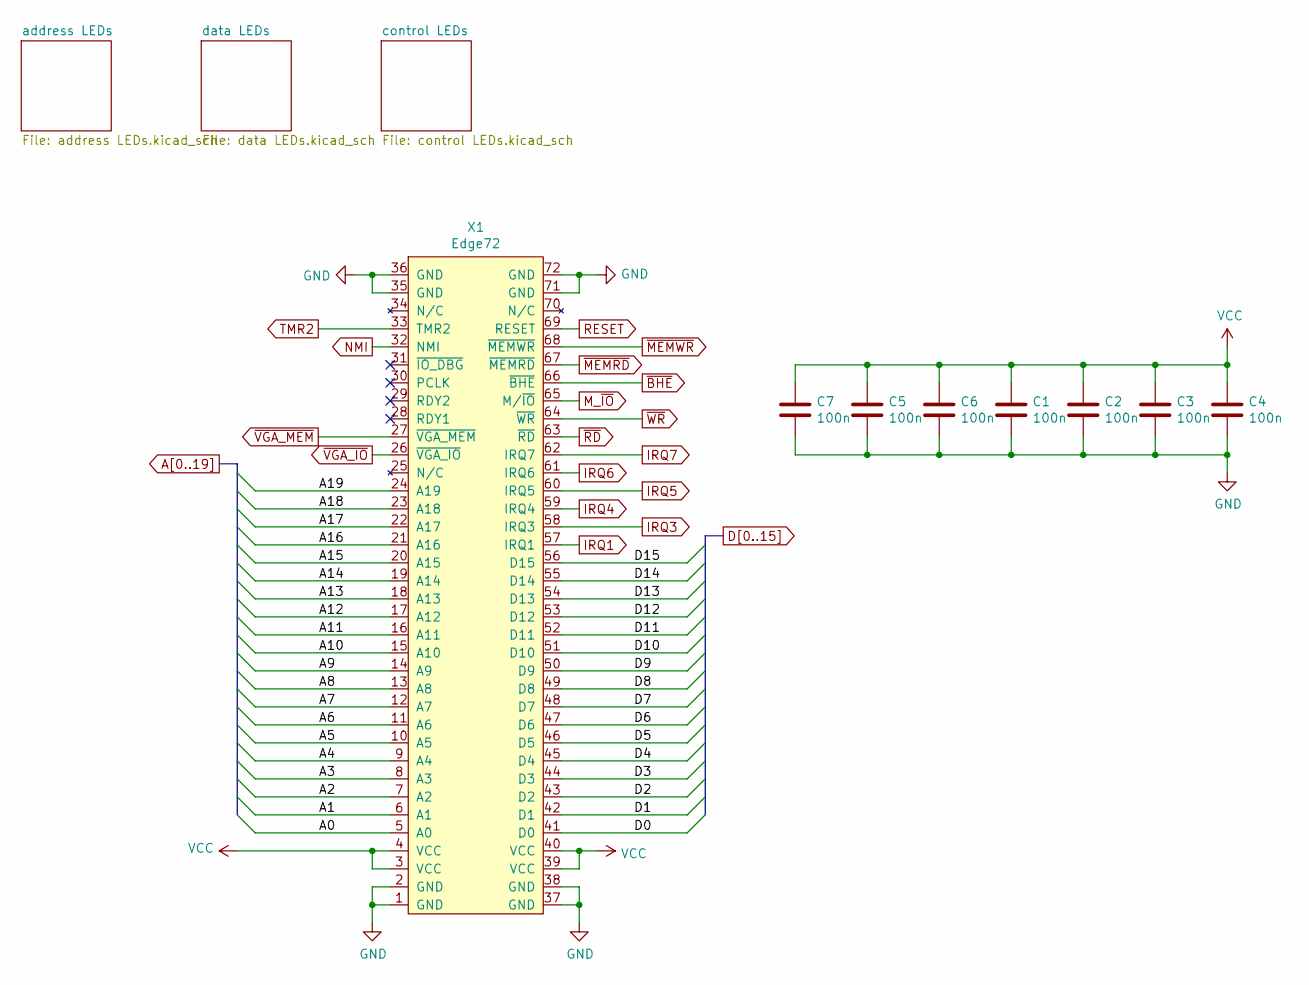
[picture p42: schematic led_board.kicad_sch, Mini8086 LED board]

Parts:
C1, C2, C3, C4, C5, C6, C7: 100n; C_1206_3216Metric; LCSC C24497
X1: Edge72; BUS_72

Connections:
A0: X1.5 (A0); also elsewhere on the board
A1: X1.6 (A1); also elsewhere on the board
A2: X1.7 (A2); also elsewhere on the board
A3: X1.8 (A3); also elsewhere on the board
A4: X1.9 (A4); also elsewhere on the board
A5: X1.10 (A5); also elsewhere on the board
A6: X1.11 (A6); also elsewhere on the board
A7: X1.12 (A7); also elsewhere on the board
A8: X1.13 (A8); also elsewhere on the board
A9: X1.14 (A9); also elsewhere on the board
A10: X1.15 (A10); also elsewhere on the board
A11: X1.16 (A11); also elsewhere on the board
A12: X1.17 (A12); also elsewhere on the board
A13: X1.18 (A13); also elsewhere on the board
A14: X1.19 (A14); also elsewhere on the board
A15: X1.20 (A15); also elsewhere on the board
A16: X1.21 (A16); also elsewhere on the board
A17: X1.22 (A17); also elsewhere on the board
A18: X1.23 (A18); also elsewhere on the board
A19: X1.24 (A19); also elsewhere on the board
D0: X1.41 (D0); also elsewhere on the board
D1: X1.42 (D1); also elsewhere on the board
D2: X1.43 (D2); also elsewhere on the board
D3: X1.44 (D3); also elsewhere on the board
D4: X1.45 (D4); also elsewhere on the board
D5: X1.46 (D5); also elsewhere on the board
D6: X1.47 (D6); also elsewhere on the board
D7: X1.48 (D7); also elsewhere on the board
D8: X1.49 (D8); also elsewhere on the board
D9: X1.50 (D9); also elsewhere on the board
D10: X1.51 (D10); also elsewhere on the board
D11: X1.52 (D11); also elsewhere on the board
D12: X1.53 (D12); also elsewhere on the board
D13: X1.54 (D13); also elsewhere on the board
D14: X1.55 (D14); also elsewhere on the board
D15: X1.56 (D15); also elsewhere on the board
GND: C1.2, C2.2, C3.2, C4.2, C5.2, C6.2, C7.2, X1.1 (GND), X1.2 (GND), X1.35 (GND), X1.36 (GND), X1.37 (GND), X1.38 (GND), X1.71 (GND), X1.72 (GND); also elsewhere on the board
IRQ1: X1.57 (IRQ1); also elsewhere on the board
IRQ3: X1.58 (IRQ3); also elsewhere on the board
IRQ4: X1.59 (IRQ4); also elsewhere on the board
IRQ5: X1.60 (IRQ5); also elsewhere on the board
IRQ6: X1.61 (IRQ6); also elsewhere on the board
IRQ7: X1.62 (IRQ7); also elsewhere on the board
M_~IO: X1.65 (M/~IO); also elsewhere on the board
NMI: X1.32 (NMI); also elsewhere on the board
RESET: X1.69 (RESET); also elsewhere on the board
TMR2: X1.33 (TMR2); also elsewhere on the board
VCC: C1.1, C2.1, C3.1, C4.1, C5.1, C6.1, C7.1, X1.3 (VCC), X1.4 (VCC), X1.39 (VCC), X1.40 (VCC); also elsewhere on the board
~BHE: X1.66 (~BHE); also elsewhere on the board
~MEMRD: X1.67 (~MEMRD); also elsewhere on the board
~MEMWR: X1.68 (~MEMWR); also elsewhere on the board
~RD: X1.63 (~RD); also elsewhere on the board
~VGA_IO: X1.26 (~VGA_IO); also elsewhere on the board
~VGA_MEM: X1.27 (~VGA_MEM); also elsewhere on the board
~WR: X1.64 (~WR); also elsewhere on the board

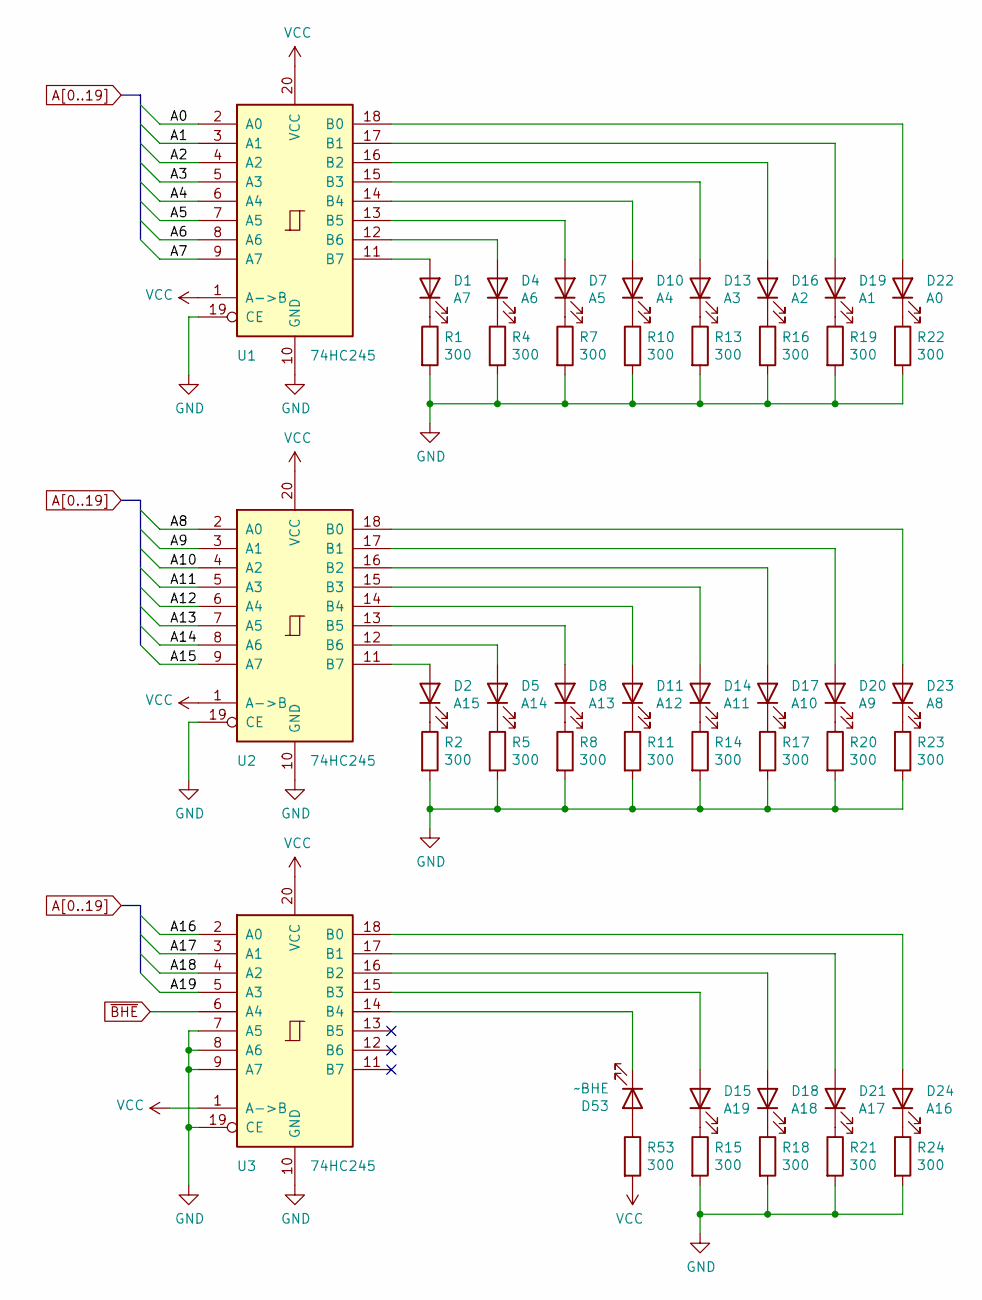
[picture p43: schematic address LEDs.kicad_sch, Mini8086 LED board]

Parts:
D1: A7; LED_0603_1608Metric
D2: A15; LED_0603_1608Metric
D4: A6; LED_0603_1608Metric
D5: A14; LED_0603_1608Metric
D7: A5; LED_0603_1608Metric
D8: A13; LED_0603_1608Metric
D10: A4; LED_0603_1608Metric
D11: A12; LED_0603_1608Metric
D13: A3; LED_0603_1608Metric
D14: A11; LED_0603_1608Metric
D15: A19; LED_0603_1608Metric
D16: A2; LED_0603_1608Metric
D17: A10; LED_0603_1608Metric
D18: A18; LED_0603_1608Metric
D19: A1; LED_0603_1608Metric
D20: A9; LED_0603_1608Metric
D21: A17; LED_0603_1608Metric
D22: A0; LED_0603_1608Metric
D23: A8; LED_0603_1608Metric
D24: A16; LED_0603_1608Metric
D53: ~BHE; LED_0603_1608Metric
R1, R2, R4, R5, R7, R8, R10, R11, R13, R14, R15, R16, R17, R18, R19, R20, R21, R22, R23, R24, R53: 300; R_1206_3216Metric
U1, U2, U3: 74HC245; SO-20_12.8x7.5mm_P1.27mm; LCSC C5625

Connections:
A0: U1.2 (A0); also elsewhere on the board
A1: U1.3 (A1); also elsewhere on the board
A2: U1.4 (A2); also elsewhere on the board
A3: U1.5 (A3); also elsewhere on the board
A4: U1.6 (A4); also elsewhere on the board
A5: U1.7 (A5); also elsewhere on the board
A6: U1.8 (A6); also elsewhere on the board
A7: U1.9 (A7); also elsewhere on the board
A8: U2.2 (A0); also elsewhere on the board
A9: U2.3 (A1); also elsewhere on the board
A10: U2.4 (A2); also elsewhere on the board
A11: U2.5 (A3); also elsewhere on the board
A12: U2.6 (A4); also elsewhere on the board
A13: U2.7 (A5); also elsewhere on the board
A14: U2.8 (A6); also elsewhere on the board
A15: U2.9 (A7); also elsewhere on the board
A16: U3.2 (A0); also elsewhere on the board
A17: U3.3 (A1); also elsewhere on the board
A18: U3.4 (A2); also elsewhere on the board
A19: U3.5 (A3); also elsewhere on the board
GND: R1.2, R2.2, R4.2, R5.2, R7.2, R8.2, R10.2, R11.2, R13.2, R14.2, R15.2, R16.2, R17.2, R18.2, R19.2, R20.2, R21.2, R22.2, R23.2, R24.2, U1.10 (GND), U1.19 (CE), U2.10 (GND), U2.19 (CE), U3.7 (A5), U3.8 (A6), U3.9 (A7), U3.10 (GND), U3.19 (CE); also elsewhere on the board
unnamed: D1.2 (A), U1.11 (B7)
unnamed: D1.1 (K), R1.1
unnamed: D2.2 (A), U2.11 (B7)
unnamed: D2.1 (K), R2.1
unnamed: D4.2 (A), U1.12 (B6)
unnamed: D4.1 (K), R4.1
unnamed: D5.2 (A), U2.12 (B6)
unnamed: D5.1 (K), R5.1
unnamed: D7.2 (A), U1.13 (B5)
unnamed: D7.1 (K), R7.1
unnamed: D8.2 (A), U2.13 (B5)
unnamed: D8.1 (K), R8.1
unnamed: D10.2 (A), U1.14 (B4)
unnamed: D10.1 (K), R10.1
unnamed: D11.2 (A), U2.14 (B4)
unnamed: D11.1 (K), R11.1
unnamed: D13.2 (A), U1.15 (B3)
unnamed: D13.1 (K), R13.1
unnamed: D14.2 (A), U2.15 (B3)
unnamed: D14.1 (K), R14.1
unnamed: D15.2 (A), U3.15 (B3)
unnamed: D15.1 (K), R15.1
unnamed: D16.2 (A), U1.16 (B2)
unnamed: D16.1 (K), R16.1
unnamed: D17.2 (A), U2.16 (B2)
unnamed: D17.1 (K), R17.1
unnamed: D18.2 (A), U3.16 (B2)
unnamed: D18.1 (K), R18.1
unnamed: D19.2 (A), U1.17 (B1)
unnamed: D19.1 (K), R19.1
unnamed: D20.2 (A), U2.17 (B1)
unnamed: D20.1 (K), R20.1
unnamed: D21.2 (A), U3.17 (B1)
unnamed: D21.1 (K), R21.1
unnamed: D22.2 (A), U1.18 (B0)
unnamed: D22.1 (K), R22.1
unnamed: D23.2 (A), U2.18 (B0)
unnamed: D23.1 (K), R23.1
unnamed: D24.2 (A), U3.18 (B0)
unnamed: D24.1 (K), R24.1
unnamed: D53.2 (A), R53.1
unnamed: D53.1 (K), U3.14 (B4)
VCC: R53.2, U1.1 (A->B), U1.20 (VCC), U2.1 (A->B), U2.20 (VCC), U3.1 (A->B), U3.20 (VCC); also elsewhere on the board
~BHE: U3.6 (A4); also elsewhere on the board

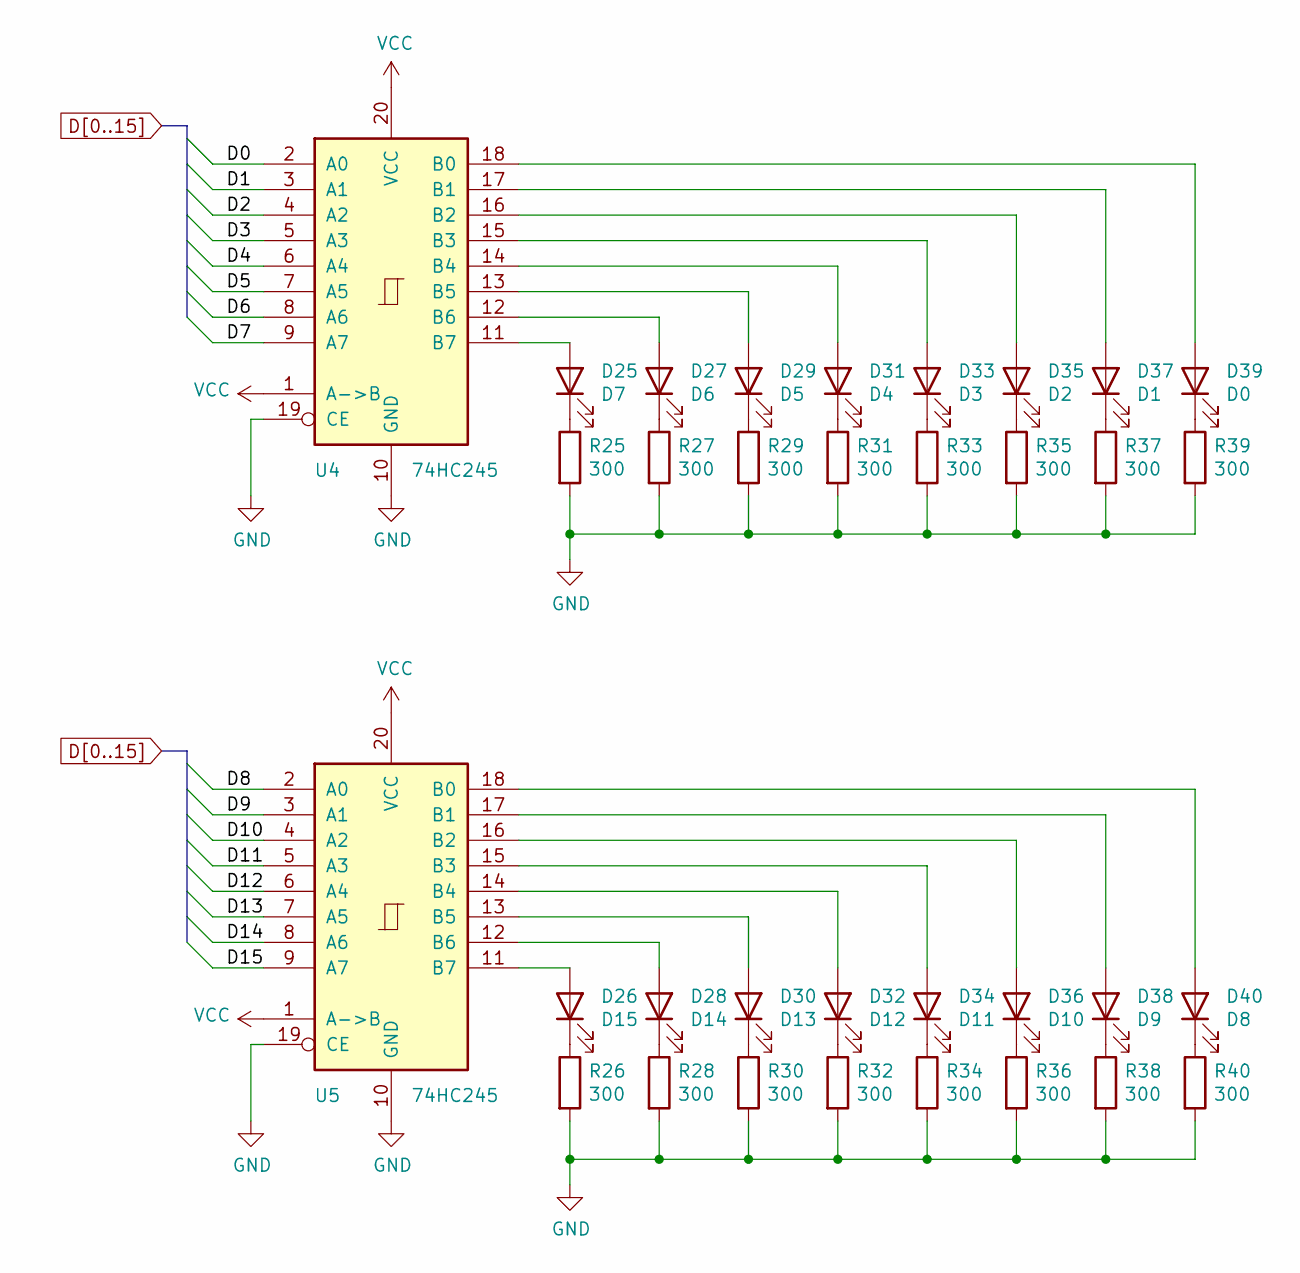
[picture p44: schematic data LEDs.kicad_sch, Mini8086 LED board]

Parts:
D25: D7; LED_0603_1608Metric
D26: D15; LED_0603_1608Metric
D27: D6; LED_0603_1608Metric
D28: D14; LED_0603_1608Metric
D29: D5; LED_0603_1608Metric
D30: D13; LED_0603_1608Metric
D31: D4; LED_0603_1608Metric
D32: D12; LED_0603_1608Metric
D33: D3; LED_0603_1608Metric
D34: D11; LED_0603_1608Metric
D35: D2; LED_0603_1608Metric
D36: D10; LED_0603_1608Metric
D37: D1; LED_0603_1608Metric
D38: D9; LED_0603_1608Metric
D39: D0; LED_0603_1608Metric
D40: D8; LED_0603_1608Metric
R25, R26, R27, R28, R29, R30, R31, R32, R33, R34, R35, R36, R37, R38, R39, R40: 300; R_1206_3216Metric
U4, U5: 74HC245; SO-20_12.8x7.5mm_P1.27mm; LCSC C5625

Connections:
D0: U4.2 (A0); also elsewhere on the board
D1: U4.3 (A1); also elsewhere on the board
D2: U4.4 (A2); also elsewhere on the board
D3: U4.5 (A3); also elsewhere on the board
D4: U4.6 (A4); also elsewhere on the board
D5: U4.7 (A5); also elsewhere on the board
D6: U4.8 (A6); also elsewhere on the board
D7: U4.9 (A7); also elsewhere on the board
D8: U5.2 (A0); also elsewhere on the board
D9: U5.3 (A1); also elsewhere on the board
D10: U5.4 (A2); also elsewhere on the board
D11: U5.5 (A3); also elsewhere on the board
D12: U5.6 (A4); also elsewhere on the board
D13: U5.7 (A5); also elsewhere on the board
D14: U5.8 (A6); also elsewhere on the board
D15: U5.9 (A7); also elsewhere on the board
GND: R25.2, R26.2, R27.2, R28.2, R29.2, R30.2, R31.2, R32.2, R33.2, R34.2, R35.2, R36.2, R37.2, R38.2, R39.2, R40.2, U4.10 (GND), U4.19 (CE), U5.10 (GND), U5.19 (CE); also elsewhere on the board
unnamed: D25.2 (A), U4.11 (B7)
unnamed: D25.1 (K), R25.1
unnamed: D26.2 (A), U5.11 (B7)
unnamed: D26.1 (K), R26.1
unnamed: D27.2 (A), U4.12 (B6)
unnamed: D27.1 (K), R27.1
unnamed: D28.2 (A), U5.12 (B6)
unnamed: D28.1 (K), R28.1
unnamed: D29.2 (A), U4.13 (B5)
unnamed: D29.1 (K), R29.1
unnamed: D30.2 (A), U5.13 (B5)
unnamed: D30.1 (K), R30.1
unnamed: D31.2 (A), U4.14 (B4)
unnamed: D31.1 (K), R31.1
unnamed: D32.2 (A), U5.14 (B4)
unnamed: D32.1 (K), R32.1
unnamed: D33.2 (A), U4.15 (B3)
unnamed: D33.1 (K), R33.1
unnamed: D34.2 (A), U5.15 (B3)
unnamed: D34.1 (K), R34.1
unnamed: D35.2 (A), U4.16 (B2)
unnamed: D35.1 (K), R35.1
unnamed: D36.2 (A), U5.16 (B2)
unnamed: D36.1 (K), R36.1
unnamed: D37.2 (A), U4.17 (B1)
unnamed: D37.1 (K), R37.1
unnamed: D38.2 (A), U5.17 (B1)
unnamed: D38.1 (K), R38.1
unnamed: D39.2 (A), U4.18 (B0)
unnamed: D39.1 (K), R39.1
unnamed: D40.2 (A), U5.18 (B0)
unnamed: D40.1 (K), R40.1
VCC: U4.1 (A->B), U4.20 (VCC), U5.1 (A->B), U5.20 (VCC); also elsewhere on the board

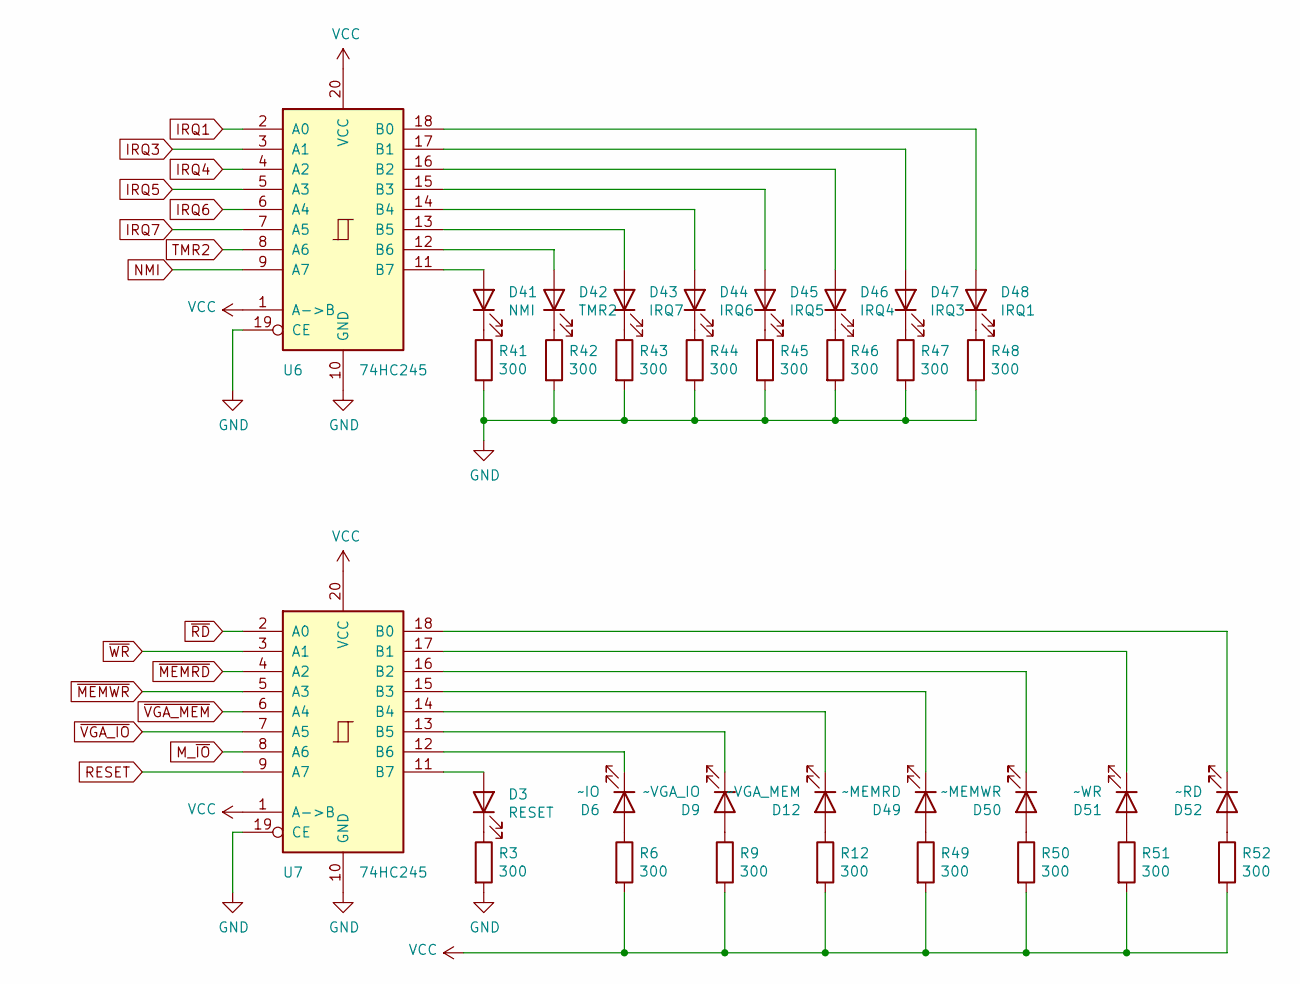
[picture p45: schematic control LEDs.kicad_sch, Mini8086 LED board]

Parts:
D3: RESET; LED_0603_1608Metric
D6: ~IO; LED_0603_1608Metric
D9: ~VGA_IO; LED_0603_1608Metric
D12: ~VGA_MEM; LED_0603_1608Metric
D41: NMI; LED_0603_1608Metric
D42: TMR2; LED_0603_1608Metric
D43: IRQ7; LED_0603_1608Metric
D44: IRQ6; LED_0603_1608Metric
D45: IRQ5; LED_0603_1608Metric
D46: IRQ4; LED_0603_1608Metric
D47: IRQ3; LED_0603_1608Metric
D48: IRQ1; LED_0603_1608Metric
D49: ~MEMRD; LED_0603_1608Metric
D50: ~MEMWR; LED_0603_1608Metric
D51: ~WR; LED_0603_1608Metric
D52: ~RD; LED_0603_1608Metric
R3, R6, R9, R12, R41, R42, R43, R44, R45, R46, R47, R48, R49, R50, R51, R52: 300; R_1206_3216Metric; LCSC C17887
U6, U7: 74HC245; SO-20_12.8x7.5mm_P1.27mm; LCSC C5625

Connections:
GND: R3.2, R41.2, R42.2, R43.2, R44.2, R45.2, R46.2, R47.2, R48.2, U6.10 (GND), U6.19 (CE), U7.10 (GND), U7.19 (CE); also elsewhere on the board
IRQ1: U6.2 (A0); also elsewhere on the board
IRQ3: U6.3 (A1); also elsewhere on the board
IRQ4: U6.4 (A2); also elsewhere on the board
IRQ5: U6.5 (A3); also elsewhere on the board
IRQ6: U6.6 (A4); also elsewhere on the board
IRQ7: U6.7 (A5); also elsewhere on the board
M_~IO: U7.8 (A6); also elsewhere on the board
NMI: U6.9 (A7); also elsewhere on the board
unnamed: D3.2 (A), U7.11 (B7)
unnamed: D3.1 (K), R3.1
unnamed: D6.2 (A), R6.1
unnamed: D6.1 (K), U7.12 (B6)
unnamed: D9.2 (A), R9.1
unnamed: D9.1 (K), U7.13 (B5)
unnamed: D12.2 (A), R12.1
unnamed: D12.1 (K), U7.14 (B4)
unnamed: D41.2 (A), U6.11 (B7)
unnamed: D41.1 (K), R41.1
unnamed: D42.2 (A), U6.12 (B6)
unnamed: D42.1 (K), R42.1
unnamed: D43.2 (A), U6.13 (B5)
unnamed: D43.1 (K), R43.1
unnamed: D44.2 (A), U6.14 (B4)
unnamed: D44.1 (K), R44.1
unnamed: D45.2 (A), U6.15 (B3)
unnamed: D45.1 (K), R45.1
unnamed: D46.2 (A), U6.16 (B2)
unnamed: D46.1 (K), R46.1
unnamed: D47.2 (A), U6.17 (B1)
unnamed: D47.1 (K), R47.1
unnamed: D48.2 (A), U6.18 (B0)
unnamed: D48.1 (K), R48.1
unnamed: D49.2 (A), R49.1
unnamed: D49.1 (K), U7.15 (B3)
unnamed: D50.2 (A), R50.1
unnamed: D50.1 (K), U7.16 (B2)
unnamed: D51.2 (A), R51.1
unnamed: D51.1 (K), U7.17 (B1)
unnamed: D52.2 (A), R52.1
unnamed: D52.1 (K), U7.18 (B0)
RESET: U7.9 (A7); also elsewhere on the board
TMR2: U6.8 (A6); also elsewhere on the board
VCC: R6.2, R9.2, R12.2, R49.2, R50.2, R51.2, R52.2, U6.1 (A->B), U6.20 (VCC), U7.1 (A->B), U7.20 (VCC); also elsewhere on the board
~MEMRD: U7.4 (A2); also elsewhere on the board
~MEMWR: U7.5 (A3); also elsewhere on the board
~RD: U7.2 (A0); also elsewhere on the board
~VGA_IO: U7.7 (A5); also elsewhere on the board
~VGA_MEM: U7.6 (A4); also elsewhere on the board
~WR: U7.3 (A1); also elsewhere on the board

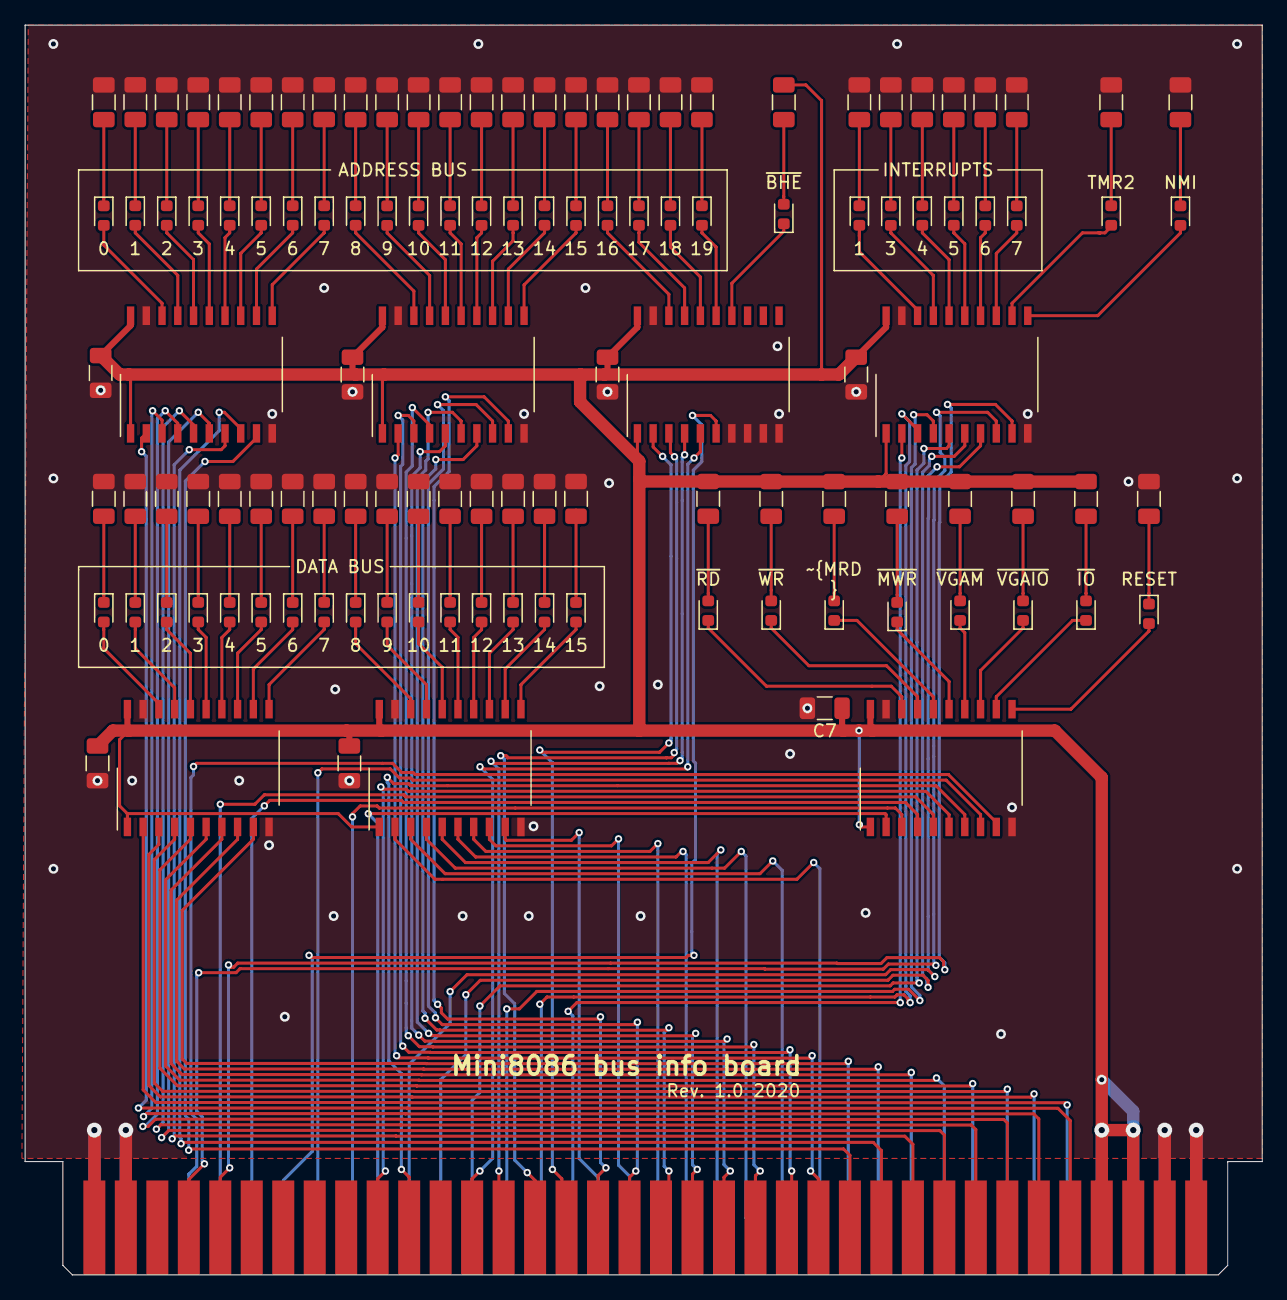
[picture p46: board led_board.kicad_pcb from above]

Board: 2 copper layers, 99.8 x 100.8 mm, 121 parts (0 on the bottom side), 161 nets.
