svpetry/Mini8086/KiCad/info_board/info_board.kicad_pcb

## KiCad design KiCad/info_board/info_board.kicad_pcb (2023-02-26)

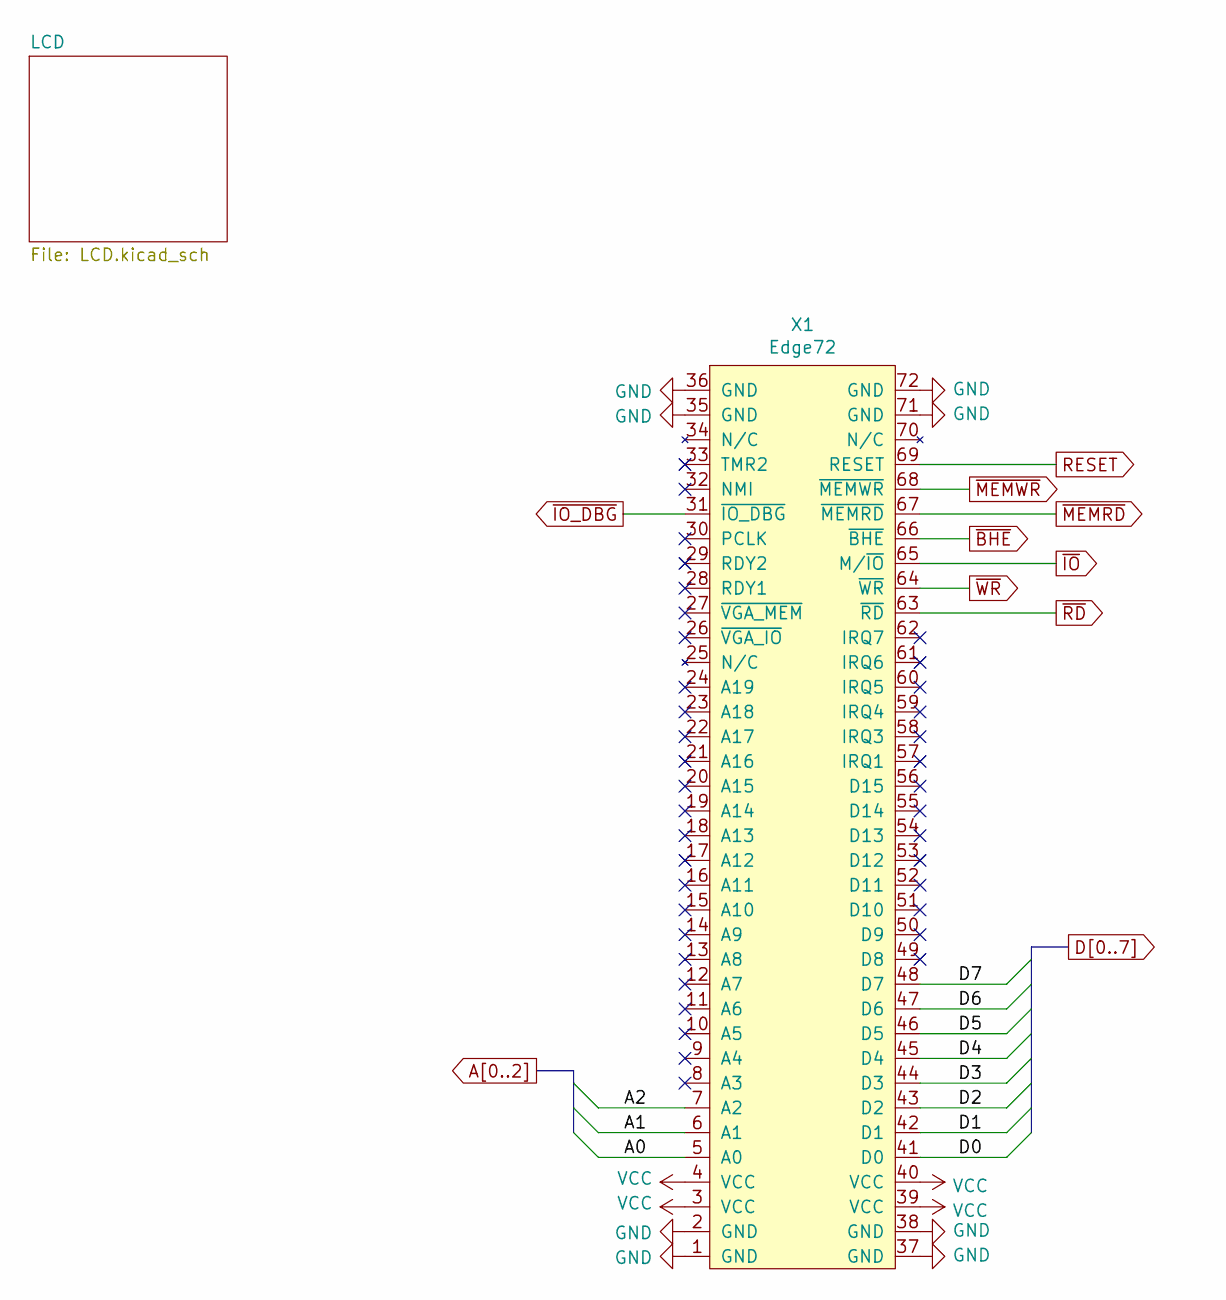
[picture p47: schematic info_board.kicad_sch, Mini8086 info board]

Parts:
X1: Edge72; BUS_72

Connections:
A0: X1.5 (A0); also elsewhere on the board
A1: X1.6 (A1); also elsewhere on the board
A2: X1.7 (A2); also elsewhere on the board
D0: X1.41 (D0); also elsewhere on the board
D1: X1.42 (D1); also elsewhere on the board
D2: X1.43 (D2); also elsewhere on the board
D3: X1.44 (D3); also elsewhere on the board
D4: X1.45 (D4); also elsewhere on the board
D5: X1.46 (D5); also elsewhere on the board
D6: X1.47 (D6); also elsewhere on the board
D7: X1.48 (D7); also elsewhere on the board
GND: X1.1 (GND), X1.2 (GND), X1.35 (GND), X1.36 (GND), X1.37 (GND), X1.38 (GND), X1.71 (GND), X1.72 (GND); also elsewhere on the board
RESET: X1.69 (RESET); also elsewhere on the board
VCC: X1.3 (VCC), X1.4 (VCC), X1.39 (VCC), X1.40 (VCC); also elsewhere on the board
~BHE: X1.66 (~BHE); also elsewhere on the board
~IO_DBG: X1.31 (~IO_DBG); also elsewhere on the board
~IO: X1.65 (M/~IO); also elsewhere on the board
~MEMRD: X1.67 (~MEMRD); also elsewhere on the board
~MEMWR: X1.68 (~MEMWR); also elsewhere on the board
~RD: X1.63 (~RD); also elsewhere on the board
~WR: X1.64 (~WR); also elsewhere on the board

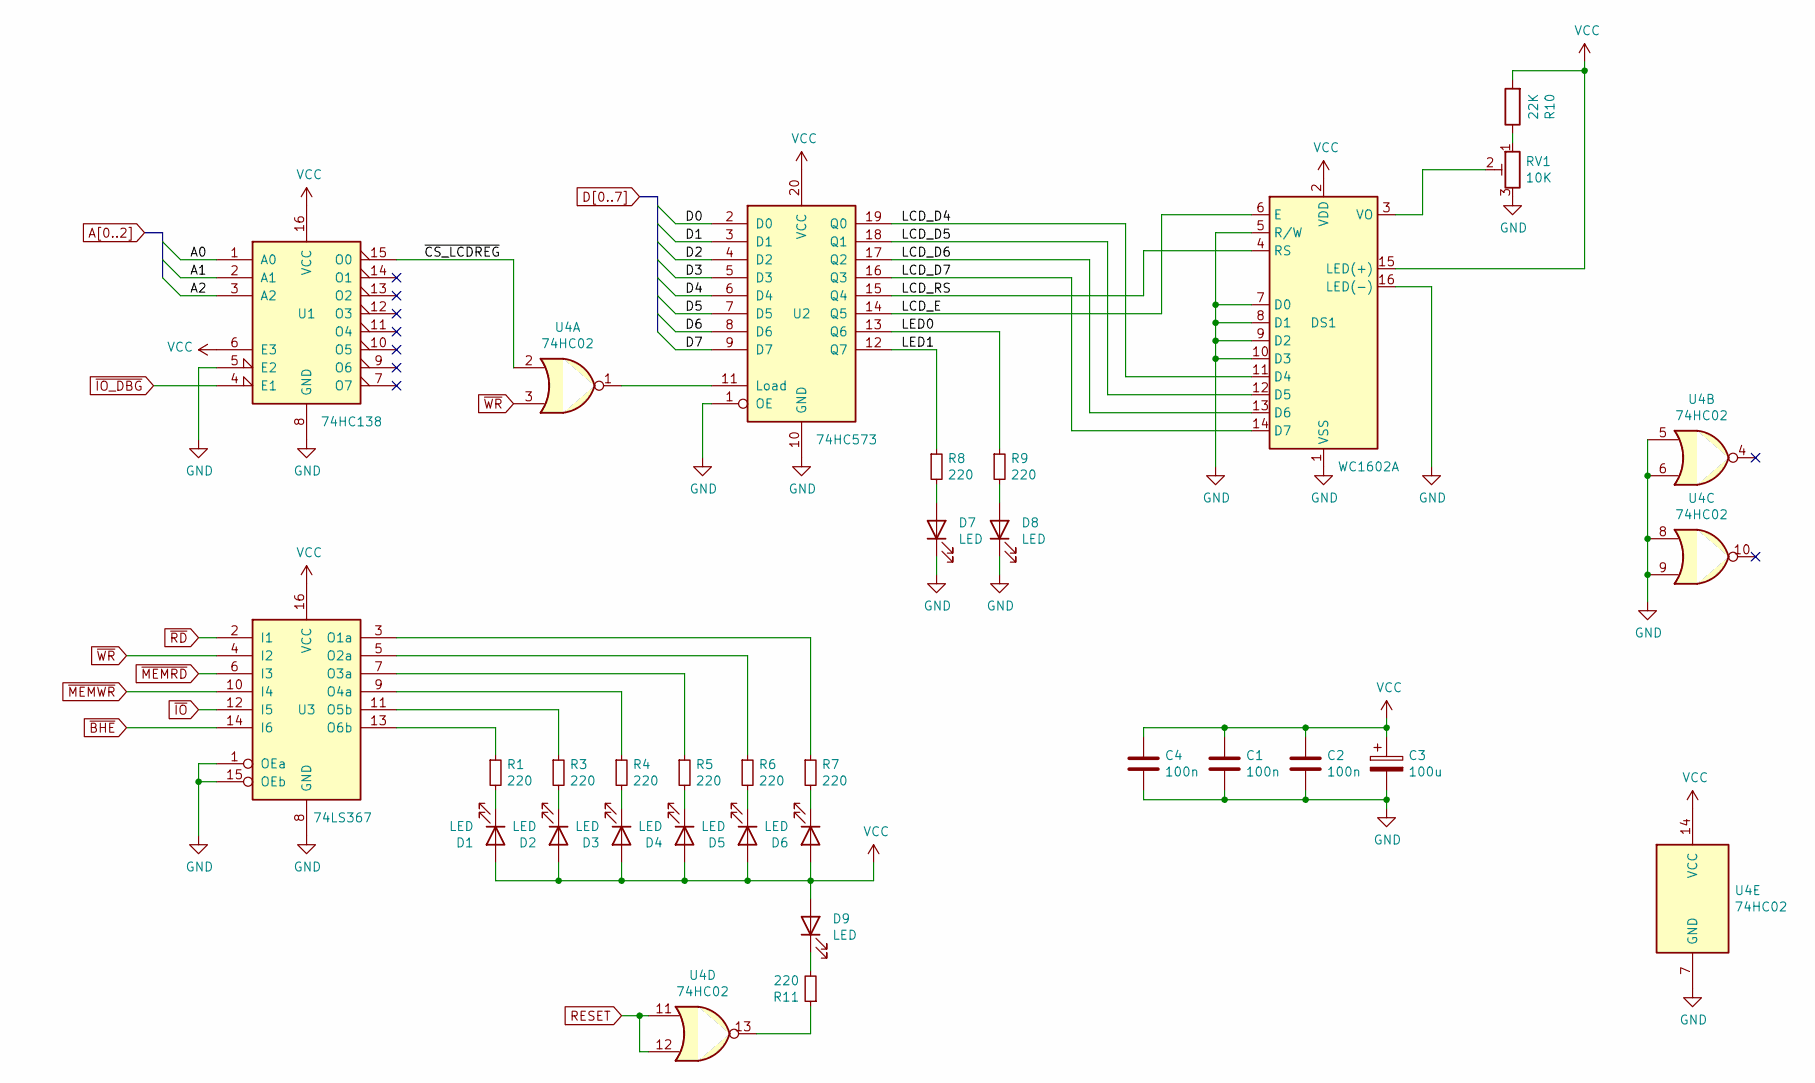
[picture p48: schematic LCD.kicad_sch, Mini8086 info board]

Parts:
C1, C2, C4: 100n; C_Disc_D4.3mm_W1.9mm_P5.00mm
C3: 100u; CP_Radial_D5.0mm_P2.50mm
D1, D2, D3, D4, D5, D6, D7, D8, D9: LED; LED_D5.0mm
DS1: WC1602A
R1, R3, R4, R5, R6, R7, R8, R9, R11: 220; R_Axial_DIN0207_L6.3mm_D2.5mm_P7.62mm_Horizontal
R10: 22K; R_Axial_DIN0207_L6.3mm_D2.5mm_P7.62mm_Horizontal
RV1: 10K; Potentiometer_Piher_PT-10-V05_Vertical
U1: 74HC138; DIP-16_W7.62mm_LongPads
U2: 74HC573; DIP-20_W7.62mm_LongPads
U3: 74LS367; DIP-16_W7.62mm_LongPads
U4: 74HC02; DIP-14_W7.62mm_LongPads

Connections:
/LCD/LCD_D4: DS1.11 (D4), U2.19 (Q0)
/LCD/LCD_D5: DS1.12 (D5), U2.18 (Q1)
/LCD/LCD_D6: DS1.13 (D6), U2.17 (Q2)
/LCD/LCD_D7: DS1.14 (D7), U2.16 (Q3)
/LCD/LCD_E: DS1.6 (E), U2.14 (Q5)
/LCD/LCD_RS: DS1.4 (RS), U2.15 (Q4)
/LCD/LED0: R9.1, U2.13 (Q6)
/LCD/LED1: R8.1, U2.12 (Q7)
/LCD/~CS_LCDREG: U1.15 (O0), U4.2
A0: U1.1 (A0); also elsewhere on the board
A1: U1.2 (A1); also elsewhere on the board
A2: U1.3 (A2); also elsewhere on the board
D0: U2.2 (D0); also elsewhere on the board
D1: U2.3 (D1); also elsewhere on the board
D2: U2.4 (D2); also elsewhere on the board
D3: U2.5 (D3); also elsewhere on the board
D4: U2.6 (D4); also elsewhere on the board
D5: U2.7 (D5); also elsewhere on the board
D6: U2.8 (D6); also elsewhere on the board
D7: U2.9 (D7); also elsewhere on the board
GND: C1.2, C2.2, C3.2, C4.2, D7.1 (K), D8.1 (K), DS1.1 (VSS), DS1.5 (R/W), DS1.7 (D0), DS1.8 (D1), DS1.9 (D2), DS1.10 (D3), DS1.16 (LED(-)), RV1.3, U1.5 (E2), U1.8 (GND), U2.1 (OE), U2.10 (GND), U3.1 (OEa), U3.8 (GND), U3.15 (OEb), U4.5, U4.6, U4.7 (GND), U4.8, U4.9; also elsewhere on the board
unnamed: D1.1 (K), R1.2
unnamed: D2.1 (K), R3.2
unnamed: D3.1 (K), R4.2
unnamed: D4.1 (K), R5.2
unnamed: D5.1 (K), R6.2
unnamed: D6.1 (K), R7.2
unnamed: D7.2 (A), R8.2
unnamed: D8.2 (A), R9.2
unnamed: D9.1 (K), R11.2
unnamed: DS1.3 (VO), RV1.2
unnamed: R10.1, RV1.1
unnamed: R11.1, U4.13
unnamed: U2.11 (Load), U4.1
unnamed: R7.1, U3.3 (O1a)
unnamed: R6.1, U3.5 (O2a)
unnamed: R5.1, U3.7 (O3a)
unnamed: R4.1, U3.9 (O4a)
unnamed: R3.1, U3.11 (O5b)
unnamed: R1.1, U3.13 (O6b)
RESET: U4.11, U4.12; also elsewhere on the board
VCC: C1.1, C2.1, C3.1, C4.1, D1.2 (A), D2.2 (A), D3.2 (A), D4.2 (A), D5.2 (A), D6.2 (A), D9.2 (A), DS1.2 (VDD), DS1.15 (LED(+)), R10.2, U1.6 (E3), U1.16 (VCC), U2.20 (VCC), U3.16 (VCC), U4.14 (VCC); also elsewhere on the board
~BHE: U3.14 (I6); also elsewhere on the board
~IO_DBG: U1.4 (E1); also elsewhere on the board
~IO: U3.12 (I5); also elsewhere on the board
~MEMRD: U3.6 (I3); also elsewhere on the board
~MEMWR: U3.10 (I4); also elsewhere on the board
~RD: U3.2 (I1); also elsewhere on the board
~WR: U3.4 (I2), U4.3; also elsewhere on the board

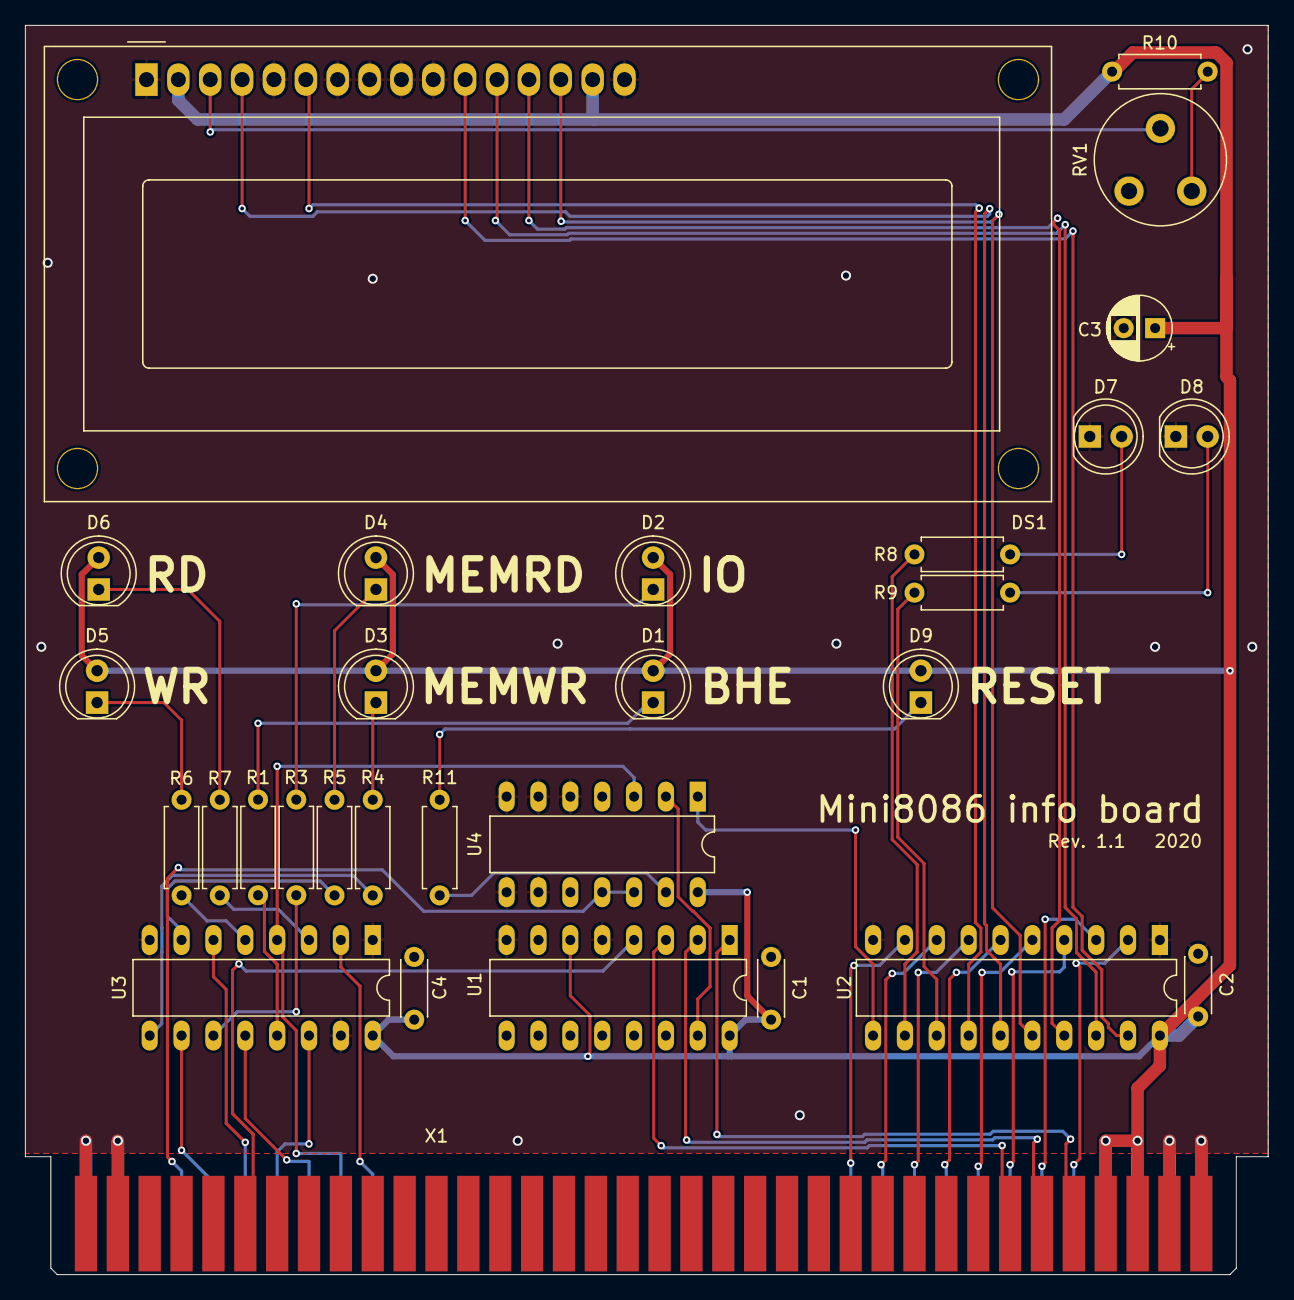
[picture p49: board info_board.kicad_pcb from above]

Board: 2 copper layers, 99.1 x 99.6 mm, 30 parts (0 on the bottom side), 49 nets.
