svpetry/Mini8086/KiCad/backplane/backplane.kicad_pcb

## KiCad design KiCad/backplane/backplane.kicad_pcb (2023-02-26)

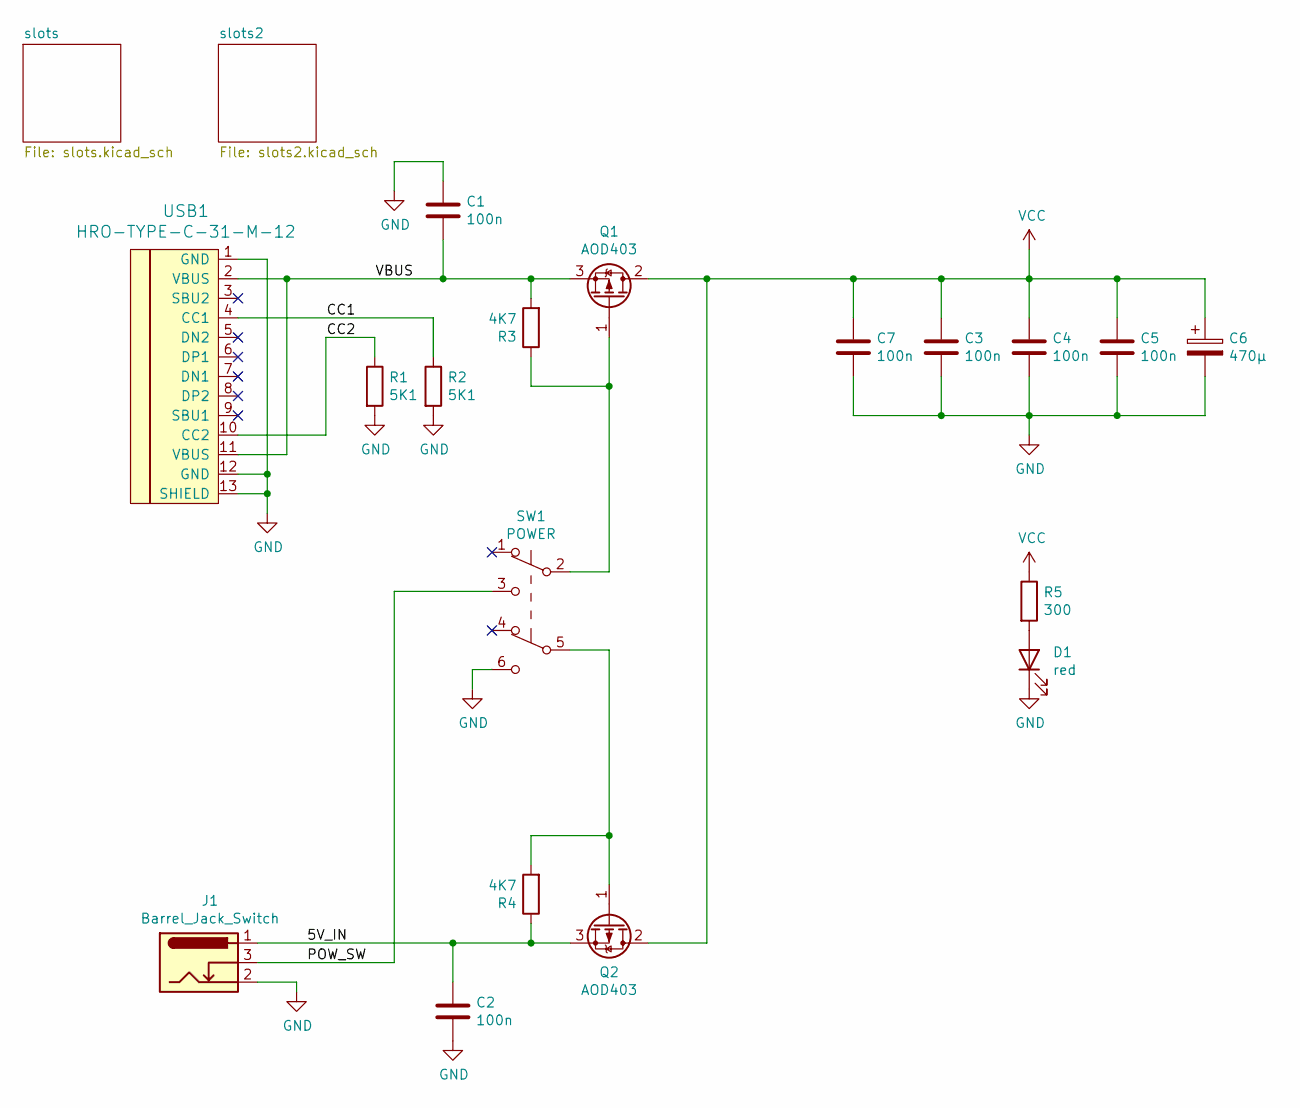
[picture p50: schematic backplane.kicad_sch, Mini8086 backplane]

Parts:
C1, C2: 100n; C_1206_3216Metric
C3, C4, C5, C7: 100n; C_Disc_D5.0mm_W2.5mm_P5.00mm
C6: 470µ; CP_Radial_D8.0mm_P3.80mm
D1: red; LED_1206_3216Metric_Castellated
J1: Barrel_Jack_Switch; BarrelJack_Horizontal
Q1, Q2: AOD403; TO-252-2
R1, R2: 5K1; R_1206_3216Metric
R3, R4: 4K7; R_1206_3216Metric
R5: 300; R_1206_3216Metric
SW1: POWER; Button
USB1: HRO-TYPE-C-31-M-12

Connections:
/5V_IN: C2.1, J1.1, Q2.3 (S), R4.1
/CC1: R2.1, USB1.4 (CC1)
/CC2: R1.1, USB1.10 (CC2)
/POW_SW: J1.3, SW1.3 (C)
/VBUS: C1.2, Q1.3 (S), R3.2, USB1.2 (VBUS), USB1.11 (VBUS)
GND: C1.1, C2.2, C3.2, C4.2, C5.2, C6.2, C7.2, D1.1 (K), J1.2, R1.2, R2.2, SW1.6 (C), USB1.1 (GND), USB1.12 (GND), USB1.13 (SHIELD); also elsewhere on the board
unnamed: D1.2 (A), R5.2
unnamed: Q1.1 (G), R3.1, SW1.2 (B)
unnamed: Q2.1 (G), R4.2, SW1.5 (B)
VCC: C3.1, C4.1, C5.1, C6.1, C7.1, Q1.2 (D), Q2.2 (D), R5.1; also elsewhere on the board

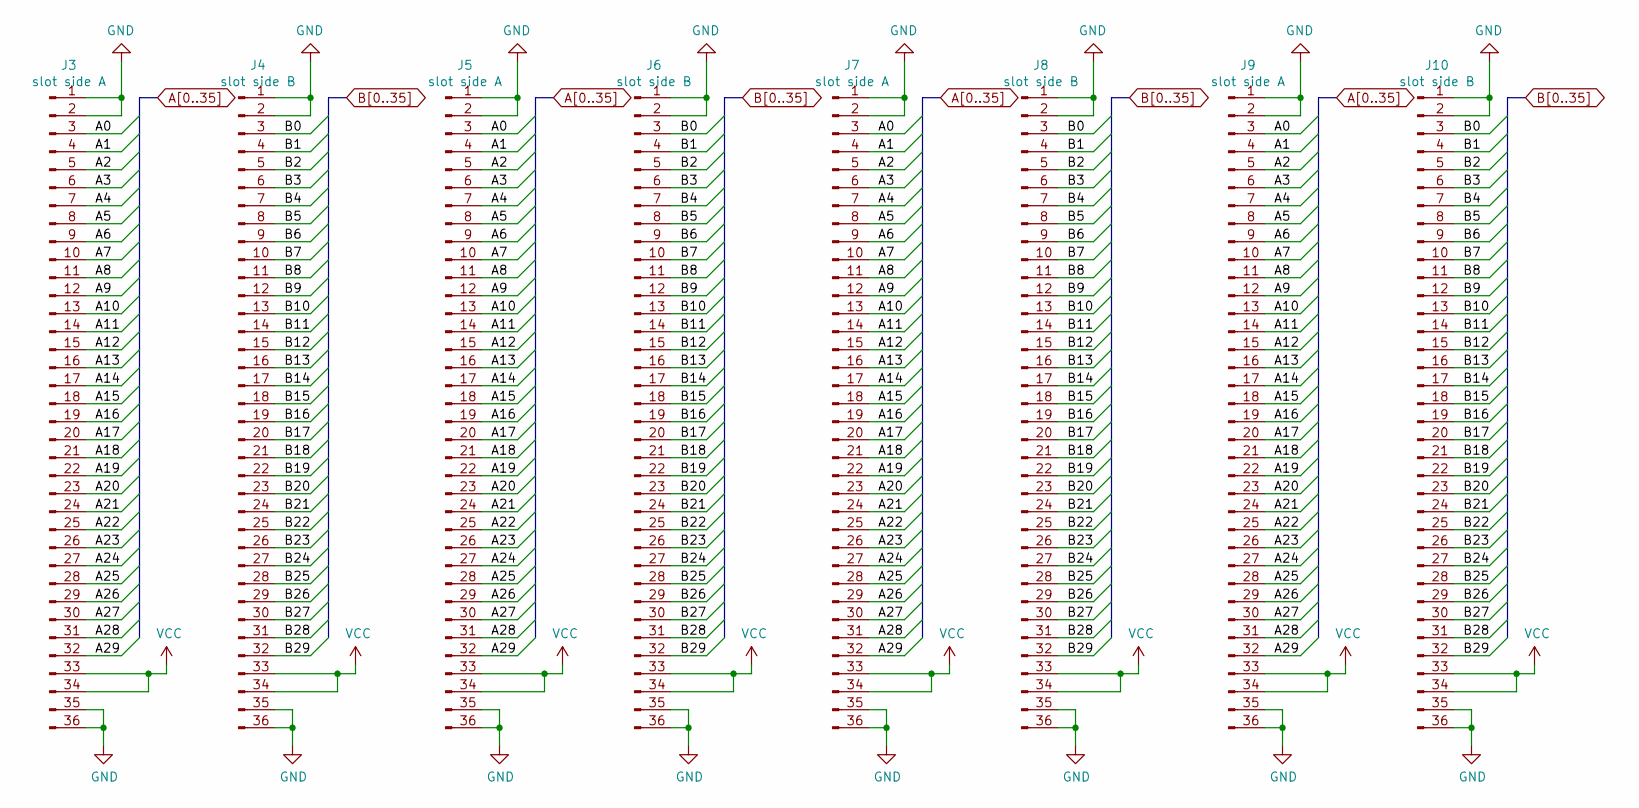
[picture p51: schematic slots.kicad_sch, Mini8086 backplane]

Parts:
J3, J5, J7, J9: slot side A; PinHeader_1x36_P2.54mm_Vertical
J4, J6, J8, J10: slot side B; PinHeader_1x36_P2.54mm_Vertical

Connections:
A0: J3.3, J5.3, J7.3, J9.3; also elsewhere on the board
A1: J3.4, J5.4, J7.4, J9.4; also elsewhere on the board
A2: J3.5, J5.5, J7.5, J9.5; also elsewhere on the board
A3: J3.6, J5.6, J7.6, J9.6; also elsewhere on the board
A4: J3.7, J5.7, J7.7, J9.7; also elsewhere on the board
A5: J3.8, J5.8, J7.8, J9.8; also elsewhere on the board
A6: J3.9, J5.9, J7.9, J9.9; also elsewhere on the board
A7: J3.10, J5.10, J7.10, J9.10; also elsewhere on the board
A8: J3.11, J5.11, J7.11, J9.11; also elsewhere on the board
A9: J3.12, J5.12, J7.12, J9.12; also elsewhere on the board
A10: J3.13, J5.13, J7.13, J9.13; also elsewhere on the board
A11: J3.14, J5.14, J7.14, J9.14; also elsewhere on the board
A12: J3.15, J5.15, J7.15, J9.15; also elsewhere on the board
A13: J3.16, J5.16, J7.16, J9.16; also elsewhere on the board
A14: J3.17, J5.17, J7.17, J9.17; also elsewhere on the board
A15: J3.18, J5.18, J7.18, J9.18; also elsewhere on the board
A16: J3.19, J5.19, J7.19, J9.19; also elsewhere on the board
A17: J3.20, J5.20, J7.20, J9.20; also elsewhere on the board
A18: J3.21, J5.21, J7.21, J9.21; also elsewhere on the board
A19: J3.22, J5.22, J7.22, J9.22; also elsewhere on the board
A20: J3.23, J5.23, J7.23, J9.23; also elsewhere on the board
A21: J3.24, J5.24, J7.24, J9.24; also elsewhere on the board
A22: J3.25, J5.25, J7.25, J9.25; also elsewhere on the board
A23: J3.26, J5.26, J7.26, J9.26; also elsewhere on the board
A24: J3.27, J5.27, J7.27, J9.27; also elsewhere on the board
A25: J3.28, J5.28, J7.28, J9.28; also elsewhere on the board
A26: J3.29, J5.29, J7.29, J9.29; also elsewhere on the board
A27: J3.30, J5.30, J7.30, J9.30; also elsewhere on the board
A28: J3.31, J5.31, J7.31, J9.31; also elsewhere on the board
A29: J3.32, J5.32, J7.32, J9.32; also elsewhere on the board
B0: J4.3, J6.3, J8.3, J10.3; also elsewhere on the board
B1: J4.4, J6.4, J8.4, J10.4; also elsewhere on the board
B2: J4.5, J6.5, J8.5, J10.5; also elsewhere on the board
B3: J4.6, J6.6, J8.6, J10.6; also elsewhere on the board
B4: J4.7, J6.7, J8.7, J10.7; also elsewhere on the board
B5: J4.8, J6.8, J8.8, J10.8; also elsewhere on the board
B6: J4.9, J6.9, J8.9, J10.9; also elsewhere on the board
B7: J4.10, J6.10, J8.10, J10.10; also elsewhere on the board
B8: J4.11, J6.11, J8.11, J10.11; also elsewhere on the board
B9: J4.12, J6.12, J8.12, J10.12; also elsewhere on the board
B10: J4.13, J6.13, J8.13, J10.13; also elsewhere on the board
B11: J4.14, J6.14, J8.14, J10.14; also elsewhere on the board
B12: J4.15, J6.15, J8.15, J10.15; also elsewhere on the board
B13: J4.16, J6.16, J8.16, J10.16; also elsewhere on the board
B14: J4.17, J6.17, J8.17, J10.17; also elsewhere on the board
B15: J4.18, J6.18, J8.18, J10.18; also elsewhere on the board
B16: J4.19, J6.19, J8.19, J10.19; also elsewhere on the board
B17: J4.20, J6.20, J8.20, J10.20; also elsewhere on the board
B18: J4.21, J6.21, J8.21, J10.21; also elsewhere on the board
B19: J4.22, J6.22, J8.22, J10.22; also elsewhere on the board
B20: J4.23, J6.23, J8.23, J10.23; also elsewhere on the board
B21: J4.24, J6.24, J8.24, J10.24; also elsewhere on the board
B22: J4.25, J6.25, J8.25, J10.25; also elsewhere on the board
B23: J4.26, J6.26, J8.26, J10.26; also elsewhere on the board
B24: J4.27, J6.27, J8.27, J10.27; also elsewhere on the board
B25: J4.28, J6.28, J8.28, J10.28; also elsewhere on the board
B26: J4.29, J6.29, J8.29, J10.29; also elsewhere on the board
B27: J4.30, J6.30, J8.30, J10.30; also elsewhere on the board
B28: J4.31, J6.31, J8.31, J10.31; also elsewhere on the board
B29: J4.32, J6.32, J8.32, J10.32; also elsewhere on the board
GND: J3.1, J3.2, J3.35, J3.36, J4.1, J4.2, J4.35, J4.36, J5.1, J5.2, J5.35, J5.36, J6.1, J6.2, J6.35, J6.36, J7.1, J7.2, J7.35, J7.36, J8.1, J8.2, J8.35, J8.36, J9.1, J9.2, J9.35, J9.36, J10.1, J10.2, J10.35, J10.36; also elsewhere on the board
VCC: J3.33, J3.34, J4.33, J4.34, J5.33, J5.34, J6.33, J6.34, J7.33, J7.34, J8.33, J8.34, J9.33, J9.34, J10.33, J10.34; also elsewhere on the board

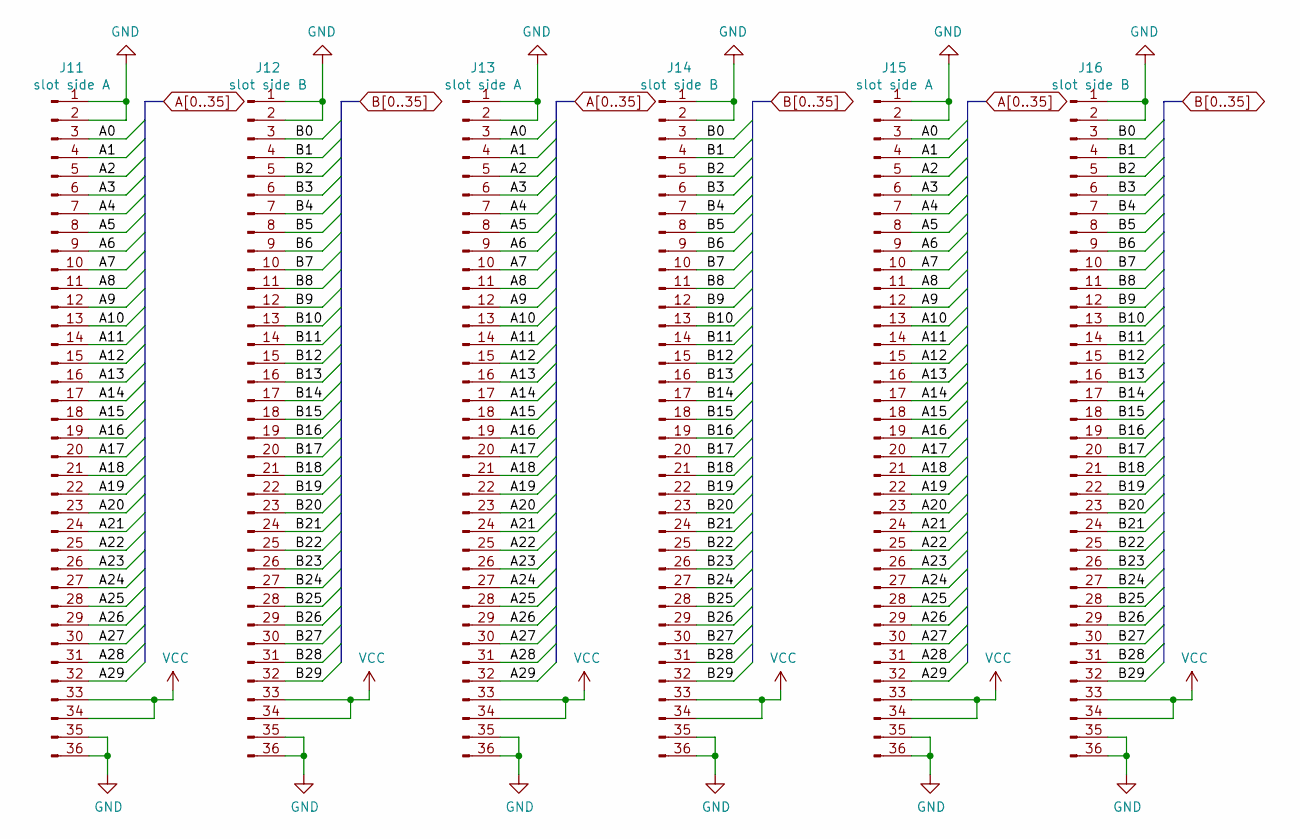
[picture p52: schematic slots2.kicad_sch, Mini8086 backplane]

Parts:
J11, J13, J15: slot side A; PinHeader_1x36_P2.54mm_Vertical
J12, J14, J16: slot side B; PinHeader_1x36_P2.54mm_Vertical

Connections:
A0: J11.3, J13.3, J15.3; also elsewhere on the board
A1: J11.4, J13.4, J15.4; also elsewhere on the board
A2: J11.5, J13.5, J15.5; also elsewhere on the board
A3: J11.6, J13.6, J15.6; also elsewhere on the board
A4: J11.7, J13.7, J15.7; also elsewhere on the board
A5: J11.8, J13.8, J15.8; also elsewhere on the board
A6: J11.9, J13.9, J15.9; also elsewhere on the board
A7: J11.10, J13.10, J15.10; also elsewhere on the board
A8: J11.11, J13.11, J15.11; also elsewhere on the board
A9: J11.12, J13.12, J15.12; also elsewhere on the board
A10: J11.13, J13.13, J15.13; also elsewhere on the board
A11: J11.14, J13.14, J15.14; also elsewhere on the board
A12: J11.15, J13.15, J15.15; also elsewhere on the board
A13: J11.16, J13.16, J15.16; also elsewhere on the board
A14: J11.17, J13.17, J15.17; also elsewhere on the board
A15: J11.18, J13.18, J15.18; also elsewhere on the board
A16: J11.19, J13.19, J15.19; also elsewhere on the board
A17: J11.20, J13.20, J15.20; also elsewhere on the board
A18: J11.21, J13.21, J15.21; also elsewhere on the board
A19: J11.22, J13.22, J15.22; also elsewhere on the board
A20: J11.23, J13.23, J15.23; also elsewhere on the board
A21: J11.24, J13.24, J15.24; also elsewhere on the board
A22: J11.25, J13.25, J15.25; also elsewhere on the board
A23: J11.26, J13.26, J15.26; also elsewhere on the board
A24: J11.27, J13.27, J15.27; also elsewhere on the board
A25: J11.28, J13.28, J15.28; also elsewhere on the board
A26: J11.29, J13.29, J15.29; also elsewhere on the board
A27: J11.30, J13.30, J15.30; also elsewhere on the board
A28: J11.31, J13.31, J15.31; also elsewhere on the board
A29: J11.32, J13.32, J15.32; also elsewhere on the board
B0: J12.3, J14.3, J16.3; also elsewhere on the board
B1: J12.4, J14.4, J16.4; also elsewhere on the board
B2: J12.5, J14.5, J16.5; also elsewhere on the board
B3: J12.6, J14.6, J16.6; also elsewhere on the board
B4: J12.7, J14.7, J16.7; also elsewhere on the board
B5: J12.8, J14.8, J16.8; also elsewhere on the board
B6: J12.9, J14.9, J16.9; also elsewhere on the board
B7: J12.10, J14.10, J16.10; also elsewhere on the board
B8: J12.11, J14.11, J16.11; also elsewhere on the board
B9: J12.12, J14.12, J16.12; also elsewhere on the board
B10: J12.13, J14.13, J16.13; also elsewhere on the board
B11: J12.14, J14.14, J16.14; also elsewhere on the board
B12: J12.15, J14.15, J16.15; also elsewhere on the board
B13: J12.16, J14.16, J16.16; also elsewhere on the board
B14: J12.17, J14.17, J16.17; also elsewhere on the board
B15: J12.18, J14.18, J16.18; also elsewhere on the board
B16: J12.19, J14.19, J16.19; also elsewhere on the board
B17: J12.20, J14.20, J16.20; also elsewhere on the board
B18: J12.21, J14.21, J16.21; also elsewhere on the board
B19: J12.22, J14.22, J16.22; also elsewhere on the board
B20: J12.23, J14.23, J16.23; also elsewhere on the board
B21: J12.24, J14.24, J16.24; also elsewhere on the board
B22: J12.25, J14.25, J16.25; also elsewhere on the board
B23: J12.26, J14.26, J16.26; also elsewhere on the board
B24: J12.27, J14.27, J16.27; also elsewhere on the board
B25: J12.28, J14.28, J16.28; also elsewhere on the board
B26: J12.29, J14.29, J16.29; also elsewhere on the board
B27: J12.30, J14.30, J16.30; also elsewhere on the board
B28: J12.31, J14.31, J16.31; also elsewhere on the board
B29: J12.32, J14.32, J16.32; also elsewhere on the board
GND: J11.1, J11.2, J11.35, J11.36, J12.1, J12.2, J12.35, J12.36, J13.1, J13.2, J13.35, J13.36, J14.1, J14.2, J14.35, J14.36, J15.1, J15.2, J15.35, J15.36, J16.1, J16.2, J16.35, J16.36; also elsewhere on the board
VCC: J11.33, J11.34, J12.33, J12.34, J13.33, J13.34, J14.33, J14.34, J15.33, J15.34, J16.33, J16.34; also elsewhere on the board

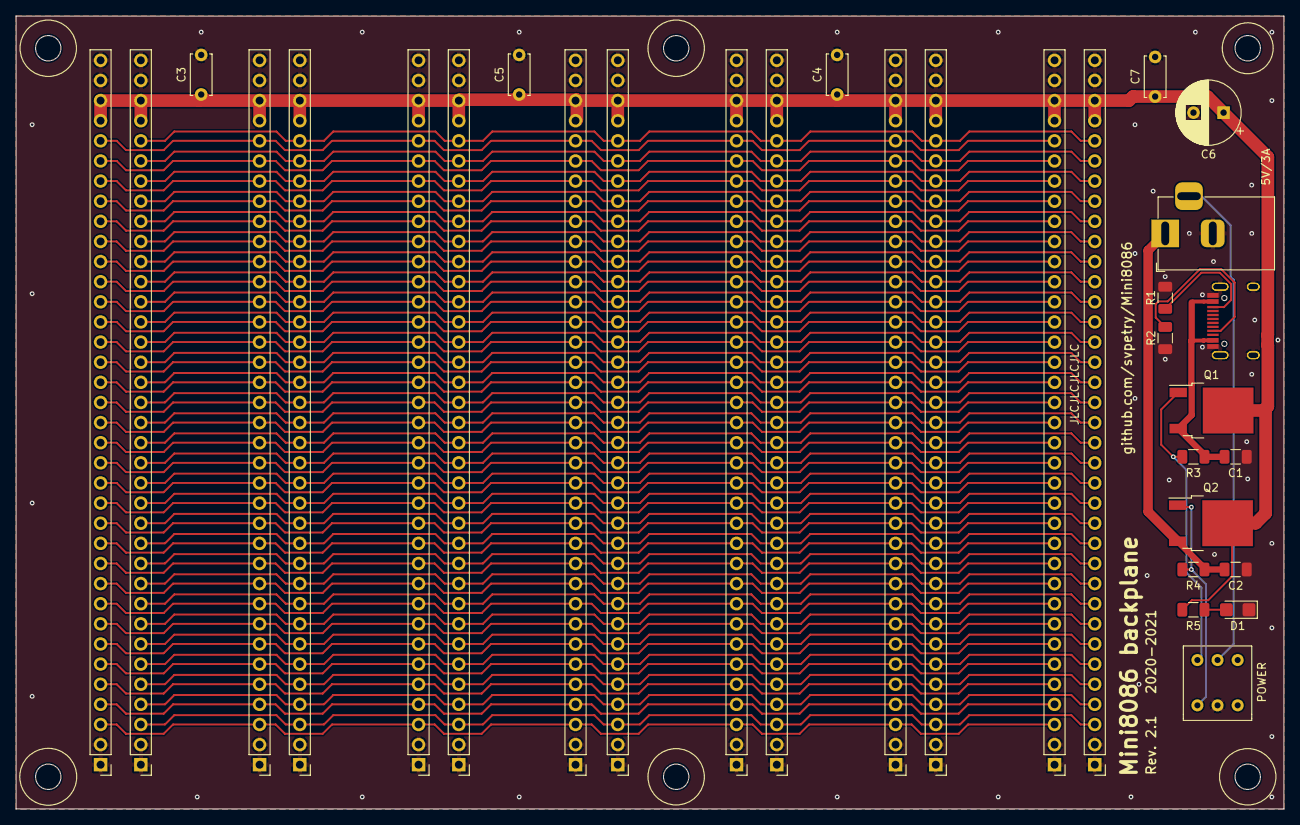
[picture p53: board backplane.kicad_pcb from above]

Board: 2 copper layers, 160.0 x 100.1 mm, 32 parts (0 on the bottom side), 70 nets.
