svpetry/Mini8086/KiCad/vga/vga.kicad_pcb

## KiCad design KiCad/vga/vga.kicad_pcb (2021-03-30)

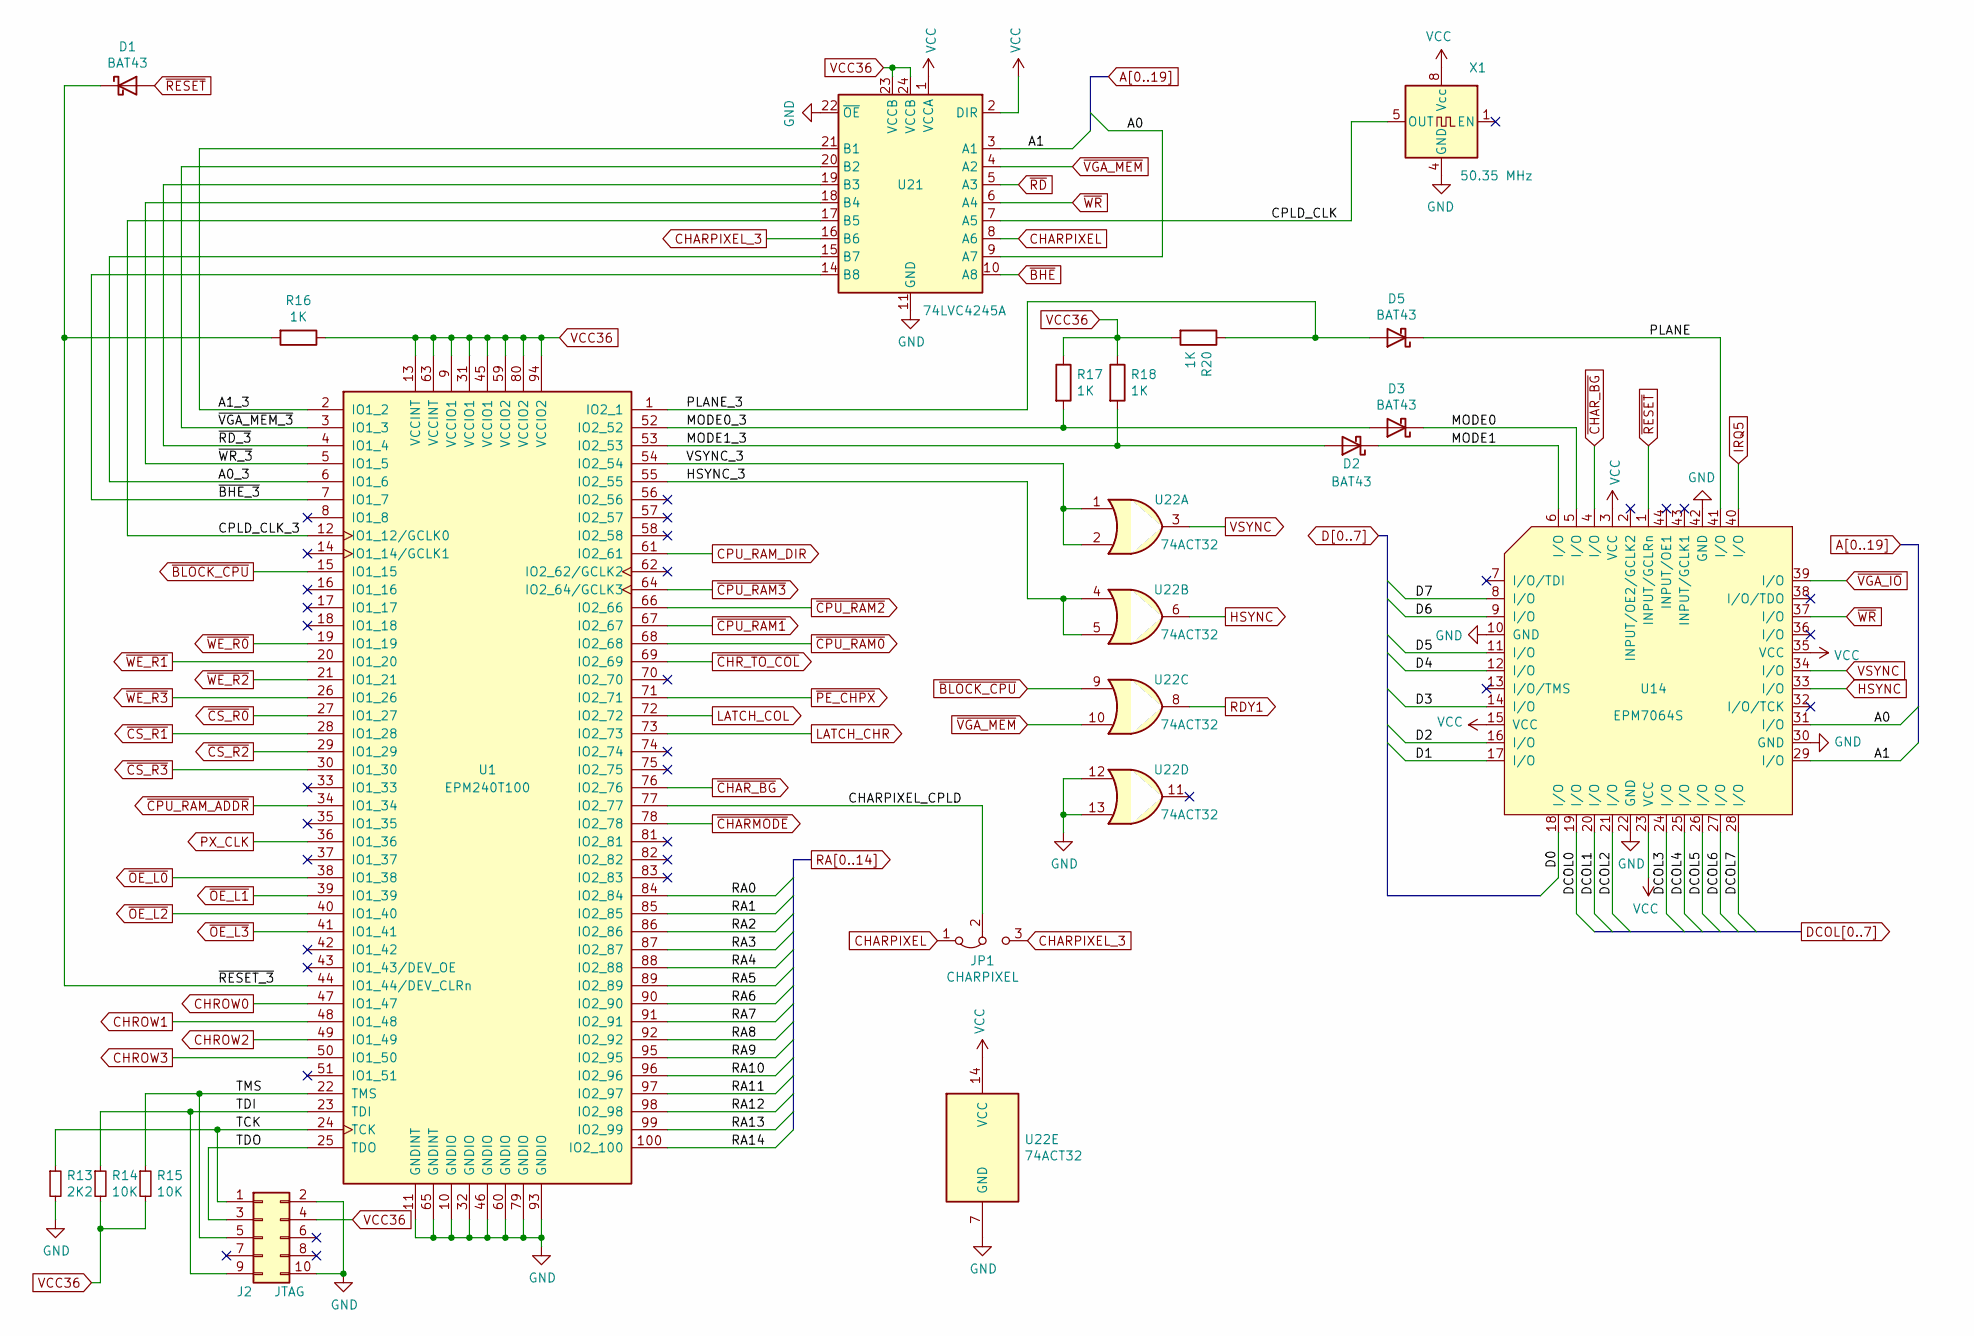
[picture p54: schematic CPLD.kicad_sch, Mini8086 VGA board]

Parts:
D1, D2, D3, D5: BAT43; D_DO-34_SOD68_P2.54mm_Vertical_KathodeUp
J2: JTAG; IDC-Header_2x05_P2.54mm_Vertical
JP1: CHARPIXEL; SolderJumper-3_P1.3mm_Open_RoundedPad1.0x1.5mm_NumberLabels
R13: 2K2; R_Axial_DIN0207_L6.3mm_D2.5mm_P2.54mm_Vertical
R14, R15: 10K; R_Axial_DIN0207_L6.3mm_D2.5mm_P2.54mm_Vertical
R16, R17, R18, R20: 1K; R_Axial_DIN0207_L6.3mm_D2.5mm_P2.54mm_Vertical
U1: EPM240T100; LQFP-100_14x14mm_P0.5mm
U14: EPM7064S; PLCC-44_THT-Socket
U21: 74LVC4245A; TSSOP-24_4.4x7.8mm_P0.65mm
U22: 74ACT32; SOIC-14_3.9x8.7mm_P1.27mm
X1: 50.35 MHz; Oscillator_DIP-8

Connections:
/CPLD/A0_3: U1.6 (IO1_6), U21.15 (B7)
/CPLD/A1_3: U1.2 (IO1_2), U21.21 (B1)
/CPLD/CHARPIXEL_CPLD: JP1.2 (C), U1.77 (IO2_77)
/CPLD/CPLD_CLK: U21.7 (A5), X1.5 (OUT)
/CPLD/CPLD_CLK_3: U1.12 (IO1_12/GCLK0), U21.17 (B5)
/CPLD/HSYNC_3: U1.55 (IO2_55), U22.4, U22.5
/CPLD/MODE0: D3.1 (K), U14.5 (I/O)
/CPLD/MODE0_3: D3.2 (A), R17.2, U1.52 (IO2_52)
/CPLD/MODE1: D2.1 (K), U14.6 (I/O)
/CPLD/MODE1_3: D2.2 (A), R18.2, U1.53 (IO2_53)
/CPLD/PLANE: D5.1 (K), U14.41 (I/O)
/CPLD/PLANE_3: D5.2 (A), R20.1, U1.1 (IO2_1)
/CPLD/TCK: J2.1, R13.1, U1.24 (TCK)
/CPLD/TDI: J2.9, R14.1, U1.23 (TDI)
/CPLD/TDO: J2.3, U1.25 (TDO)
/CPLD/TMS: J2.5, R15.1, U1.22 (TMS)
/CPLD/VSYNC_3: U1.54 (IO2_54), U22.1, U22.2
/CPLD/~BHE_3: U1.7 (IO1_7), U21.14 (B8)
/CPLD/~RD_3: U1.4 (IO1_4), U21.19 (B3)
/CPLD/~RESET_3: D1.1 (K), R16.2, U1.44 (IO1_44/DEV_CLRn)
/CPLD/~VGA_MEM_3: U1.3 (IO1_3), U21.20 (B2)
/CPLD/~WR_3: U1.5 (IO1_5), U21.18 (B4)
A0: U14.31 (I/O), U21.9 (A7); also elsewhere on the board
A1: U14.29 (I/O), U21.3 (A1); also elsewhere on the board
CHARPIXEL: JP1.1 (A), U21.8 (A6); also elsewhere on the board
CHARPIXEL_3: JP1.3 (B), U21.16 (B6)
CHROW0: U1.47 (IO1_47); also elsewhere on the board
CHROW1: U1.48 (IO1_48); also elsewhere on the board
CHROW2: U1.49 (IO1_49); also elsewhere on the board
CHROW3: U1.50 (IO1_50); also elsewhere on the board
CPU_RAM_DIR: U1.61 (IO2_61); also elsewhere on the board
D0: U14.18 (I/O); also elsewhere on the board
D1: U14.17 (I/O); also elsewhere on the board
D2: U14.16 (I/O); also elsewhere on the board
D3: U14.14 (I/O); also elsewhere on the board
D4: U14.12 (I/O); also elsewhere on the board
D5: U14.11 (I/O); also elsewhere on the board
D6: U14.9 (I/O); also elsewhere on the board
D7: U14.8 (I/O); also elsewhere on the board
DCOL0: U14.19 (I/O); also elsewhere on the board
DCOL1: U14.20 (I/O); also elsewhere on the board
DCOL2: U14.21 (I/O); also elsewhere on the board
DCOL3: U14.24 (I/O); also elsewhere on the board
DCOL4: U14.25 (I/O); also elsewhere on the board
DCOL5: U14.26 (I/O); also elsewhere on the board
DCOL6: U14.27 (I/O); also elsewhere on the board
DCOL7: U14.28 (I/O); also elsewhere on the board
GND: J2.2, J2.10, R13.2, U1.10 (GNDIO), U1.11 (GNDINT), U1.32 (GNDIO), U1.46 (GNDIO), U1.60 (GNDIO), U1.65 (GNDINT), U1.79 (GNDIO), U1.93 (GNDIO), U14.10 (GND), U14.22 (GND), U14.30 (GND), U14.42 (GND), U21.11 (GND), U21.12 (GND), U21.13 (GND), U21.22 (~OE), U22.7 (GND), U22.12, U22.13, X1.4 (GND); also elsewhere on the board
HSYNC: U14.33 (I/O), U22.6; also elsewhere on the board
IRQ5: U14.40 (I/O); also elsewhere on the board
LATCH_CHR: U1.73 (IO2_73); also elsewhere on the board
LATCH_COL: U1.72 (IO2_72); also elsewhere on the board
PX_CLK: U1.36 (IO1_36); also elsewhere on the board
RA0: U1.84 (IO2_84); also elsewhere on the board
RA1: U1.85 (IO2_85); also elsewhere on the board
RA2: U1.86 (IO2_86); also elsewhere on the board
RA3: U1.87 (IO2_87); also elsewhere on the board
RA4: U1.88 (IO2_88); also elsewhere on the board
RA5: U1.89 (IO2_89); also elsewhere on the board
RA6: U1.90 (IO2_90); also elsewhere on the board
RA7: U1.91 (IO2_91); also elsewhere on the board
RA8: U1.92 (IO2_92); also elsewhere on the board
RA9: U1.95 (IO2_95); also elsewhere on the board
RA10: U1.96 (IO2_96); also elsewhere on the board
RA11: U1.97 (IO2_97); also elsewhere on the board
RA12: U1.98 (IO2_98); also elsewhere on the board
RA13: U1.99 (IO2_99); also elsewhere on the board
RA14: U1.100 (IO2_100); also elsewhere on the board
RDY1: U22.8; also elsewhere on the board
VCC: U14.3 (VCC), U14.15 (VCC), U14.23 (VCC), U14.35 (VCC), U21.1 (VCCA), U21.2 (DIR), U22.14 (VCC), X1.8 (Vcc); also elsewhere on the board
VCC36: J2.4, R14.2, R15.2, R16.1, R17.1, R18.1, R20.2, U1.9 (VCCIO1), U1.13 (VCCINT), U1.31 (VCCIO1), U1.45 (VCCIO1), U1.59 (VCCIO2), U1.63 (VCCINT), U1.80 (VCCIO2), U1.94 (VCCIO2), U21.23 (VCCB), U21.24 (VCCB); also elsewhere on the board
VSYNC: U14.34 (I/O), U22.3; also elsewhere on the board
~BHE: U21.10 (A8); also elsewhere on the board
~BLOCK_CPU: U1.15 (IO1_15), U22.9
~CHARMODE: U1.78 (IO2_78); also elsewhere on the board
~CHAR_BG: U1.76 (IO2_76), U14.4 (I/O)
~CHR_TO_COL: U1.69 (IO2_69); also elsewhere on the board
~CPU_RAM0: U1.68 (IO2_68); also elsewhere on the board
~CPU_RAM1: U1.67 (IO2_67); also elsewhere on the board
~CPU_RAM2: U1.66 (IO2_66); also elsewhere on the board
~CPU_RAM3: U1.64 (IO2_64/GCLK3); also elsewhere on the board
~CPU_RAM_ADDR: U1.34 (IO1_34); also elsewhere on the board
~CS_R0: U1.27 (IO1_27); also elsewhere on the board
~CS_R1: U1.28 (IO1_28); also elsewhere on the board
~CS_R2: U1.29 (IO1_29); also elsewhere on the board
~CS_R3: U1.30 (IO1_30); also elsewhere on the board
~OE_L0: U1.38 (IO1_38); also elsewhere on the board
~OE_L1: U1.39 (IO1_39); also elsewhere on the board
~OE_L2: U1.40 (IO1_40); also elsewhere on the board
~OE_L3: U1.41 (IO1_41); also elsewhere on the board
~PE_CHPX: U1.71 (IO2_71); also elsewhere on the board
~RD: U21.5 (A3); also elsewhere on the board
~RESET: D1.2 (A), U14.1 (INPUT/GCLRn); also elsewhere on the board
~VGA_IO: U14.39 (I/O); also elsewhere on the board
~VGA_MEM: U21.4 (A2), U22.10; also elsewhere on the board
~WE_R0: U1.19 (IO1_19); also elsewhere on the board
~WE_R1: U1.20 (IO1_20); also elsewhere on the board
~WE_R2: U1.21 (IO1_21); also elsewhere on the board
~WE_R3: U1.26 (IO1_26); also elsewhere on the board
~WR: U14.37 (I/O), U21.6 (A4); also elsewhere on the board

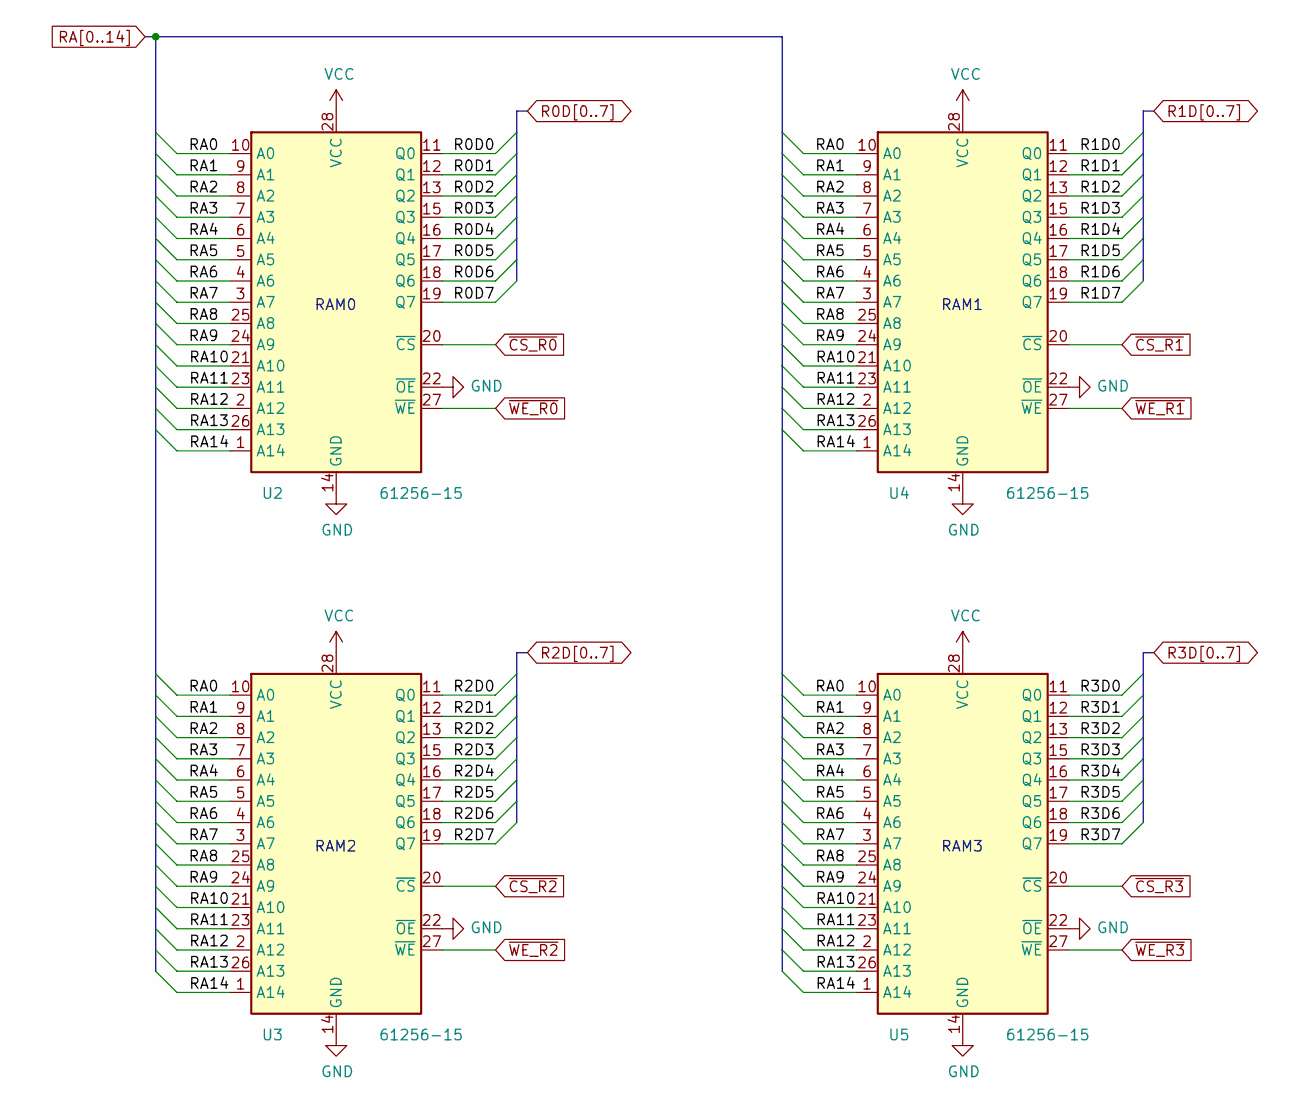
[picture p55: schematic ram.kicad_sch, Mini8086 VGA board]

Parts:
U2, U3, U4, U5: 61256-15; DIP-28_W7.62mm_Socket_LongPads

Connections:
GND: U2.14 (GND), U2.22 (~OE), U3.14 (GND), U3.22 (~OE), U4.14 (GND), U4.22 (~OE), U5.14 (GND), U5.22 (~OE); also elsewhere on the board
R0D0: U2.11 (Q0); also elsewhere on the board
R0D1: U2.12 (Q1); also elsewhere on the board
R0D2: U2.13 (Q2); also elsewhere on the board
R0D3: U2.15 (Q3); also elsewhere on the board
R0D4: U2.16 (Q4); also elsewhere on the board
R0D5: U2.17 (Q5); also elsewhere on the board
R0D6: U2.18 (Q6); also elsewhere on the board
R0D7: U2.19 (Q7); also elsewhere on the board
R1D0: U4.11 (Q0); also elsewhere on the board
R1D1: U4.12 (Q1); also elsewhere on the board
R1D2: U4.13 (Q2); also elsewhere on the board
R1D3: U4.15 (Q3); also elsewhere on the board
R1D4: U4.16 (Q4); also elsewhere on the board
R1D5: U4.17 (Q5); also elsewhere on the board
R1D6: U4.18 (Q6); also elsewhere on the board
R1D7: U4.19 (Q7); also elsewhere on the board
R2D0: U3.11 (Q0); also elsewhere on the board
R2D1: U3.12 (Q1); also elsewhere on the board
R2D2: U3.13 (Q2); also elsewhere on the board
R2D3: U3.15 (Q3); also elsewhere on the board
R2D4: U3.16 (Q4); also elsewhere on the board
R2D5: U3.17 (Q5); also elsewhere on the board
R2D6: U3.18 (Q6); also elsewhere on the board
R2D7: U3.19 (Q7); also elsewhere on the board
R3D0: U5.11 (Q0); also elsewhere on the board
R3D1: U5.12 (Q1); also elsewhere on the board
R3D2: U5.13 (Q2); also elsewhere on the board
R3D3: U5.15 (Q3); also elsewhere on the board
R3D4: U5.16 (Q4); also elsewhere on the board
R3D5: U5.17 (Q5); also elsewhere on the board
R3D6: U5.18 (Q6); also elsewhere on the board
R3D7: U5.19 (Q7); also elsewhere on the board
RA0: U2.10 (A0), U3.10 (A0), U4.10 (A0), U5.10 (A0); also elsewhere on the board
RA1: U2.9 (A1), U3.9 (A1), U4.9 (A1), U5.9 (A1); also elsewhere on the board
RA2: U2.8 (A2), U3.8 (A2), U4.8 (A2), U5.8 (A2); also elsewhere on the board
RA3: U2.7 (A3), U3.7 (A3), U4.7 (A3), U5.7 (A3); also elsewhere on the board
RA4: U2.6 (A4), U3.6 (A4), U4.6 (A4), U5.6 (A4); also elsewhere on the board
RA5: U2.5 (A5), U3.5 (A5), U4.5 (A5), U5.5 (A5); also elsewhere on the board
RA6: U2.4 (A6), U3.4 (A6), U4.4 (A6), U5.4 (A6); also elsewhere on the board
RA7: U2.3 (A7), U3.3 (A7), U4.3 (A7), U5.3 (A7); also elsewhere on the board
RA8: U2.25 (A8), U3.25 (A8), U4.25 (A8), U5.25 (A8); also elsewhere on the board
RA9: U2.24 (A9), U3.24 (A9), U4.24 (A9), U5.24 (A9); also elsewhere on the board
RA10: U2.21 (A10), U3.21 (A10), U4.21 (A10), U5.21 (A10); also elsewhere on the board
RA11: U2.23 (A11), U3.23 (A11), U4.23 (A11), U5.23 (A11); also elsewhere on the board
RA12: U2.2 (A12), U3.2 (A12), U4.2 (A12), U5.2 (A12); also elsewhere on the board
RA13: U2.26 (A13), U3.26 (A13), U4.26 (A13), U5.26 (A13); also elsewhere on the board
RA14: U2.1 (A14), U3.1 (A14), U4.1 (A14), U5.1 (A14); also elsewhere on the board
VCC: U2.28 (VCC), U3.28 (VCC), U4.28 (VCC), U5.28 (VCC); also elsewhere on the board
~CS_R0: U2.20 (~CS); also elsewhere on the board
~CS_R1: U4.20 (~CS); also elsewhere on the board
~CS_R2: U3.20 (~CS); also elsewhere on the board
~CS_R3: U5.20 (~CS); also elsewhere on the board
~WE_R0: U2.27 (~WE); also elsewhere on the board
~WE_R1: U4.27 (~WE); also elsewhere on the board
~WE_R2: U3.27 (~WE); also elsewhere on the board
~WE_R3: U5.27 (~WE); also elsewhere on the board

Notes on the sheet:
RAM2
RAM3
RAM1
RAM0
