svpetry/Mini8086/KiCad/vga/vga.kicad_pcb

## KiCad design KiCad/vga/vga.kicad_pcb (continued)

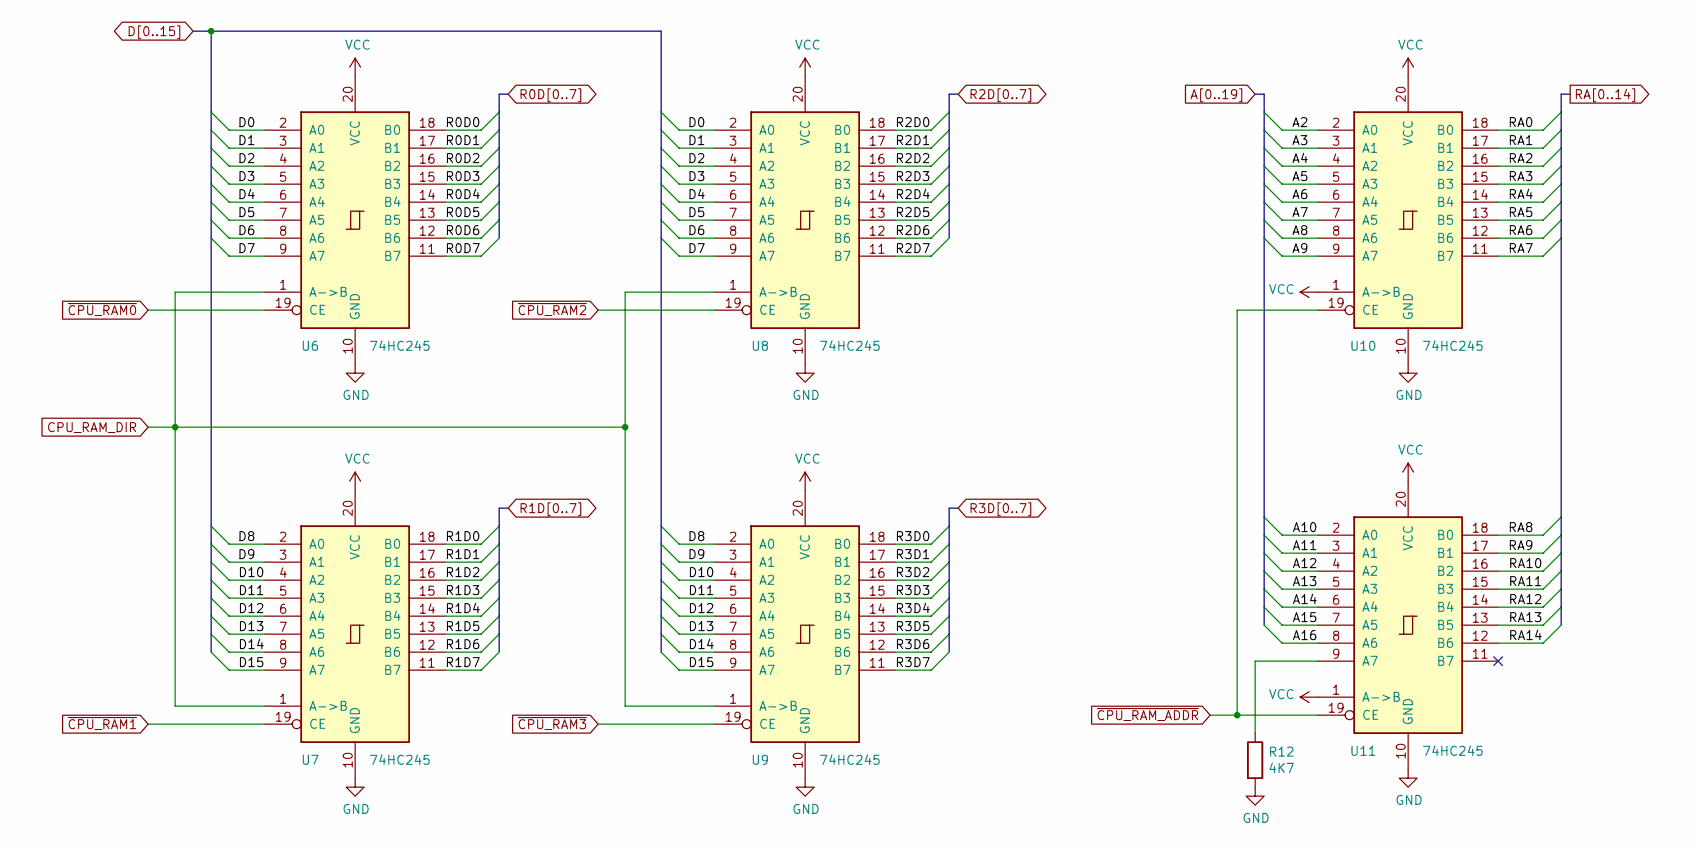
[picture p56: schematic glue logic.kicad_sch, Mini8086 VGA board]

Parts:
R12: 4K7; R_Axial_DIN0207_L6.3mm_D2.5mm_P2.54mm_Vertical
U6, U7, U8, U9, U10, U11: 74HC245; DIP-20_W7.62mm_LongPads

Connections:
A2: U10.2 (A0); also elsewhere on the board
A3: U10.3 (A1); also elsewhere on the board
A4: U10.4 (A2); also elsewhere on the board
A5: U10.5 (A3); also elsewhere on the board
A6: U10.6 (A4); also elsewhere on the board
A7: U10.7 (A5); also elsewhere on the board
A8: U10.8 (A6); also elsewhere on the board
A9: U10.9 (A7); also elsewhere on the board
A10: U11.2 (A0); also elsewhere on the board
A11: U11.3 (A1); also elsewhere on the board
A12: U11.4 (A2); also elsewhere on the board
A13: U11.5 (A3); also elsewhere on the board
A14: U11.6 (A4); also elsewhere on the board
A15: U11.7 (A5); also elsewhere on the board
A16: U11.8 (A6); also elsewhere on the board
CPU_RAM_DIR: U6.1 (A->B), U7.1 (A->B), U8.1 (A->B), U9.1 (A->B); also elsewhere on the board
D0: U6.2 (A0), U8.2 (A0); also elsewhere on the board
D1: U6.3 (A1), U8.3 (A1); also elsewhere on the board
D2: U6.4 (A2), U8.4 (A2); also elsewhere on the board
D3: U6.5 (A3), U8.5 (A3); also elsewhere on the board
D4: U6.6 (A4), U8.6 (A4); also elsewhere on the board
D5: U6.7 (A5), U8.7 (A5); also elsewhere on the board
D6: U6.8 (A6), U8.8 (A6); also elsewhere on the board
D7: U6.9 (A7), U8.9 (A7); also elsewhere on the board
D8: U7.2 (A0), U9.2 (A0); also elsewhere on the board
D9: U7.3 (A1), U9.3 (A1); also elsewhere on the board
D10: U7.4 (A2), U9.4 (A2); also elsewhere on the board
D11: U7.5 (A3), U9.5 (A3); also elsewhere on the board
D12: U7.6 (A4), U9.6 (A4); also elsewhere on the board
D13: U7.7 (A5), U9.7 (A5); also elsewhere on the board
D14: U7.8 (A6), U9.8 (A6); also elsewhere on the board
D15: U7.9 (A7), U9.9 (A7); also elsewhere on the board
GND: R12.2, U6.10 (GND), U7.10 (GND), U8.10 (GND), U9.10 (GND), U10.10 (GND), U11.10 (GND); also elsewhere on the board
unnamed: R12.1, U11.9 (A7)
R0D0: U6.18 (B0); also elsewhere on the board
R0D1: U6.17 (B1); also elsewhere on the board
R0D2: U6.16 (B2); also elsewhere on the board
R0D3: U6.15 (B3); also elsewhere on the board
R0D4: U6.14 (B4); also elsewhere on the board
R0D5: U6.13 (B5); also elsewhere on the board
R0D6: U6.12 (B6); also elsewhere on the board
R0D7: U6.11 (B7); also elsewhere on the board
R1D0: U7.18 (B0); also elsewhere on the board
R1D1: U7.17 (B1); also elsewhere on the board
R1D2: U7.16 (B2); also elsewhere on the board
R1D3: U7.15 (B3); also elsewhere on the board
R1D4: U7.14 (B4); also elsewhere on the board
R1D5: U7.13 (B5); also elsewhere on the board
R1D6: U7.12 (B6); also elsewhere on the board
R1D7: U7.11 (B7); also elsewhere on the board
R2D0: U8.18 (B0); also elsewhere on the board
R2D1: U8.17 (B1); also elsewhere on the board
R2D2: U8.16 (B2); also elsewhere on the board
R2D3: U8.15 (B3); also elsewhere on the board
R2D4: U8.14 (B4); also elsewhere on the board
R2D5: U8.13 (B5); also elsewhere on the board
R2D6: U8.12 (B6); also elsewhere on the board
R2D7: U8.11 (B7); also elsewhere on the board
R3D0: U9.18 (B0); also elsewhere on the board
R3D1: U9.17 (B1); also elsewhere on the board
R3D2: U9.16 (B2); also elsewhere on the board
R3D3: U9.15 (B3); also elsewhere on the board
R3D4: U9.14 (B4); also elsewhere on the board
R3D5: U9.13 (B5); also elsewhere on the board
R3D6: U9.12 (B6); also elsewhere on the board
R3D7: U9.11 (B7); also elsewhere on the board
RA0: U10.18 (B0); also elsewhere on the board
RA1: U10.17 (B1); also elsewhere on the board
RA2: U10.16 (B2); also elsewhere on the board
RA3: U10.15 (B3); also elsewhere on the board
RA4: U10.14 (B4); also elsewhere on the board
RA5: U10.13 (B5); also elsewhere on the board
RA6: U10.12 (B6); also elsewhere on the board
RA7: U10.11 (B7); also elsewhere on the board
RA8: U11.18 (B0); also elsewhere on the board
RA9: U11.17 (B1); also elsewhere on the board
RA10: U11.16 (B2); also elsewhere on the board
RA11: U11.15 (B3); also elsewhere on the board
RA12: U11.14 (B4); also elsewhere on the board
RA13: U11.13 (B5); also elsewhere on the board
RA14: U11.12 (B6); also elsewhere on the board
VCC: U6.20 (VCC), U7.20 (VCC), U8.20 (VCC), U9.20 (VCC), U10.1 (A->B), U10.20 (VCC), U11.1 (A->B), U11.20 (VCC); also elsewhere on the board
~CPU_RAM0: U6.19 (CE); also elsewhere on the board
~CPU_RAM1: U7.19 (CE); also elsewhere on the board
~CPU_RAM2: U8.19 (CE); also elsewhere on the board
~CPU_RAM3: U9.19 (CE); also elsewhere on the board
~CPU_RAM_ADDR: U10.19 (CE), U11.19 (CE); also elsewhere on the board

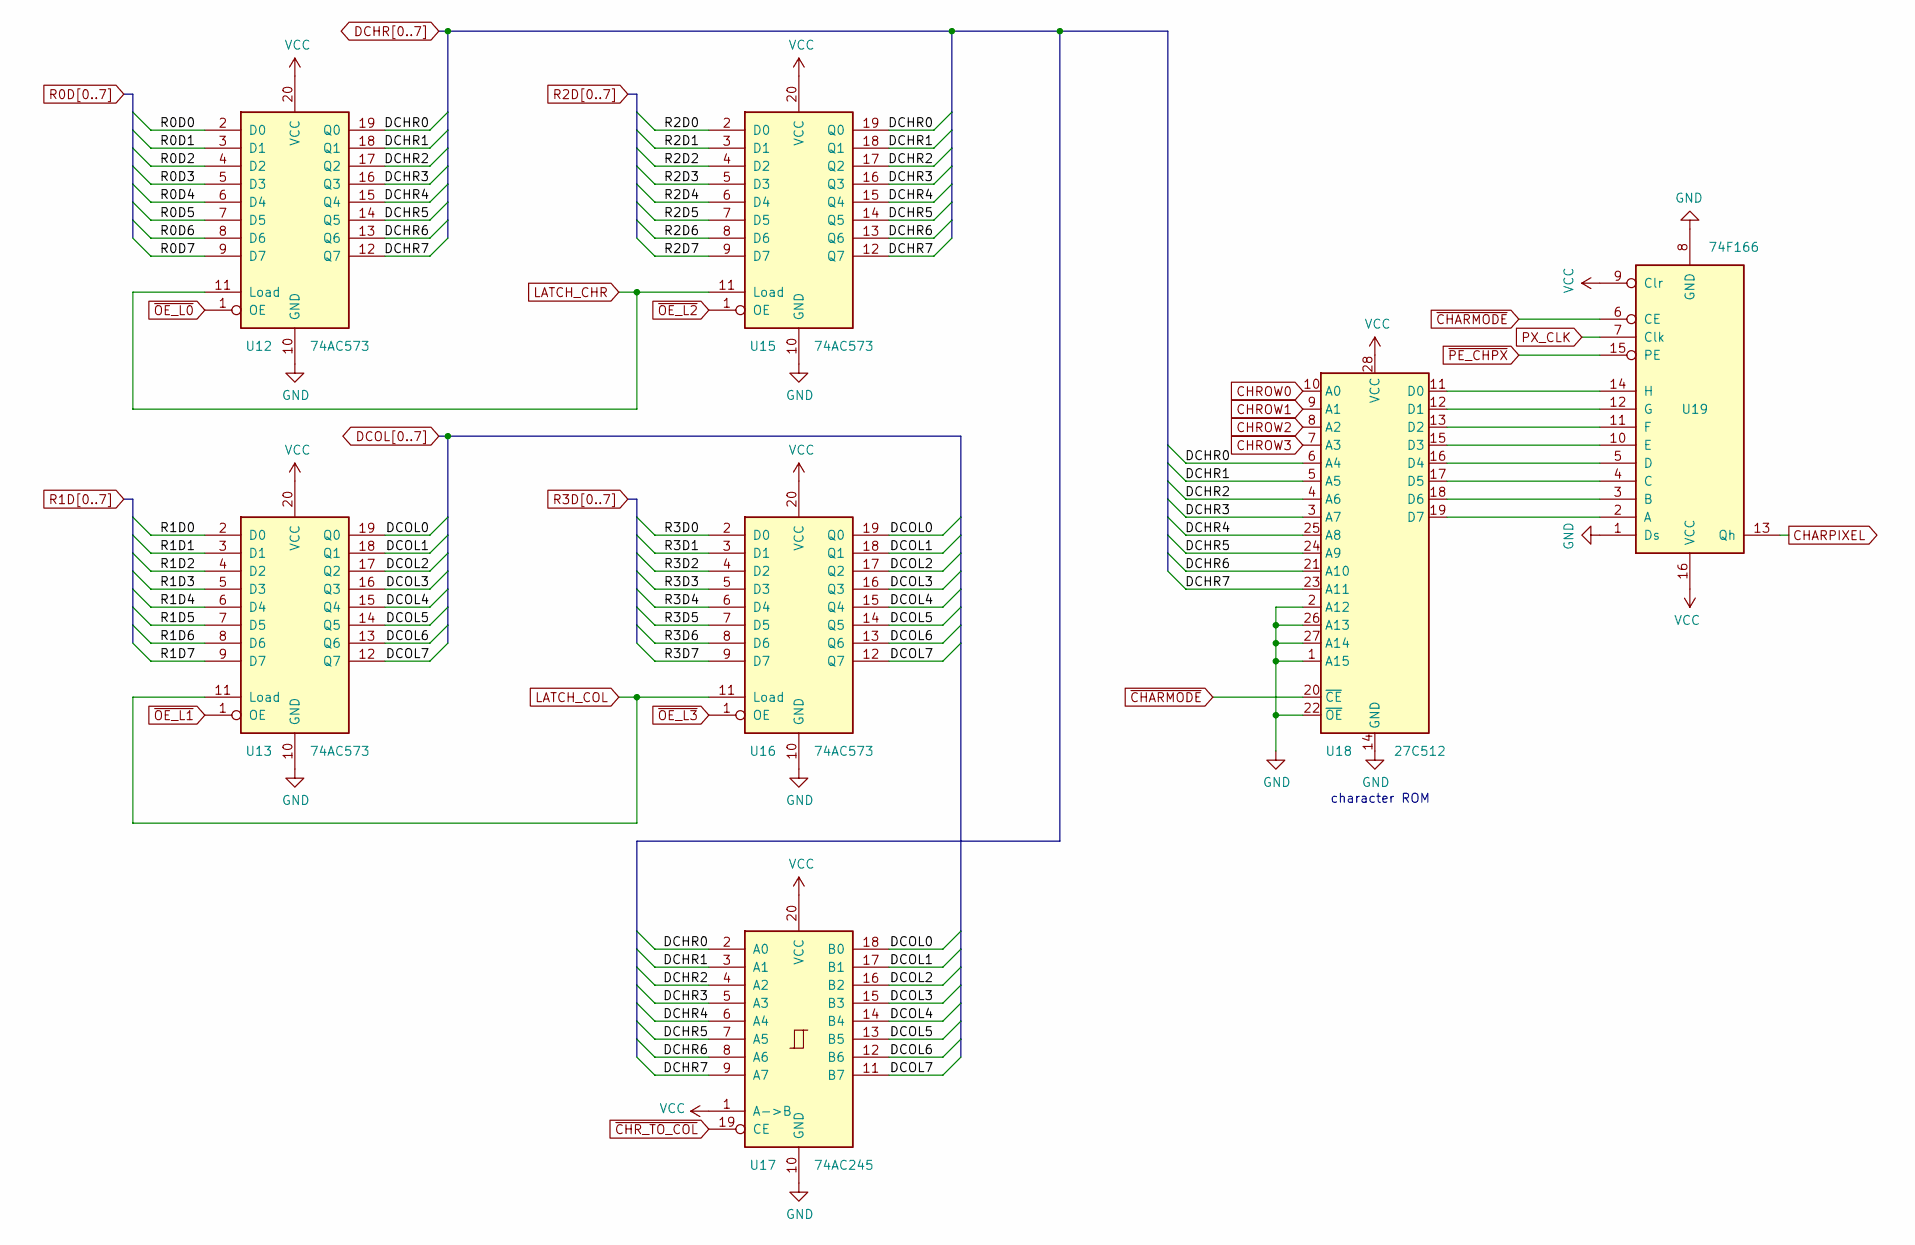
[picture p57: schematic latches.kicad_sch, Mini8086 VGA board]

Parts:
U12, U13, U15, U16: 74AC573; DIP-20_W7.62mm_LongPads
U17: 74AC245; DIP-20_W7.62mm_LongPads
U18: 27C512; DIP-28_W15.24mm_Socket_LongPads
U19: 74F166; DIP-16_W7.62mm_Socket_LongPads

Connections:
CHARPIXEL: U19.13 (Qh); also elsewhere on the board
CHROW0: U18.10 (A0); also elsewhere on the board
CHROW1: U18.9 (A1); also elsewhere on the board
CHROW2: U18.8 (A2); also elsewhere on the board
CHROW3: U18.7 (A3); also elsewhere on the board
DCHR0: U12.19 (Q0), U15.19 (Q0), U17.2 (A0), U18.6 (A4)
DCHR1: U12.18 (Q1), U15.18 (Q1), U17.3 (A1), U18.5 (A5)
DCHR2: U12.17 (Q2), U15.17 (Q2), U17.4 (A2), U18.4 (A6)
DCHR3: U12.16 (Q3), U15.16 (Q3), U17.5 (A3), U18.3 (A7)
DCHR4: U12.15 (Q4), U15.15 (Q4), U17.6 (A4), U18.25 (A8)
DCHR5: U12.14 (Q5), U15.14 (Q5), U17.7 (A5), U18.24 (A9)
DCHR6: U12.13 (Q6), U15.13 (Q6), U17.8 (A6), U18.21 (A10)
DCHR7: U12.12 (Q7), U15.12 (Q7), U17.9 (A7), U18.23 (A11)
DCOL0: U13.19 (Q0), U16.19 (Q0), U17.18 (B0); also elsewhere on the board
DCOL1: U13.18 (Q1), U16.18 (Q1), U17.17 (B1); also elsewhere on the board
DCOL2: U13.17 (Q2), U16.17 (Q2), U17.16 (B2); also elsewhere on the board
DCOL3: U13.16 (Q3), U16.16 (Q3), U17.15 (B3); also elsewhere on the board
DCOL4: U13.15 (Q4), U16.15 (Q4), U17.14 (B4); also elsewhere on the board
DCOL5: U13.14 (Q5), U16.14 (Q5), U17.13 (B5); also elsewhere on the board
DCOL6: U13.13 (Q6), U16.13 (Q6), U17.12 (B6); also elsewhere on the board
DCOL7: U13.12 (Q7), U16.12 (Q7), U17.11 (B7); also elsewhere on the board
GND: U12.10 (GND), U13.10 (GND), U15.10 (GND), U16.10 (GND), U17.10 (GND), U18.1 (A15), U18.2 (A12), U18.14 (GND), U18.22 (~OE), U18.26 (A13), U18.27 (A14), U19.1 (Ds), U19.8 (GND); also elsewhere on the board
LATCH_CHR: U12.11 (Load), U15.11 (Load); also elsewhere on the board
LATCH_COL: U13.11 (Load), U16.11 (Load); also elsewhere on the board
unnamed: U18.11 (D0), U19.14 (H)
unnamed: U18.12 (D1), U19.12 (G)
unnamed: U18.13 (D2), U19.11 (F)
unnamed: U18.15 (D3), U19.10 (E)
unnamed: U18.16 (D4), U19.5 (D)
unnamed: U18.17 (D5), U19.4 (C)
unnamed: U18.18 (D6), U19.3 (B)
unnamed: U18.19 (D7), U19.2 (A)
PX_CLK: U19.7 (Clk); also elsewhere on the board
R0D0: U12.2 (D0); also elsewhere on the board
R0D1: U12.3 (D1); also elsewhere on the board
R0D2: U12.4 (D2); also elsewhere on the board
R0D3: U12.5 (D3); also elsewhere on the board
R0D4: U12.6 (D4); also elsewhere on the board
R0D5: U12.7 (D5); also elsewhere on the board
R0D6: U12.8 (D6); also elsewhere on the board
R0D7: U12.9 (D7); also elsewhere on the board
R1D0: U13.2 (D0); also elsewhere on the board
R1D1: U13.3 (D1); also elsewhere on the board
R1D2: U13.4 (D2); also elsewhere on the board
R1D3: U13.5 (D3); also elsewhere on the board
R1D4: U13.6 (D4); also elsewhere on the board
R1D5: U13.7 (D5); also elsewhere on the board
R1D6: U13.8 (D6); also elsewhere on the board
R1D7: U13.9 (D7); also elsewhere on the board
R2D0: U15.2 (D0); also elsewhere on the board
R2D1: U15.3 (D1); also elsewhere on the board
R2D2: U15.4 (D2); also elsewhere on the board
R2D3: U15.5 (D3); also elsewhere on the board
R2D4: U15.6 (D4); also elsewhere on the board
R2D5: U15.7 (D5); also elsewhere on the board
R2D6: U15.8 (D6); also elsewhere on the board
R2D7: U15.9 (D7); also elsewhere on the board
R3D0: U16.2 (D0); also elsewhere on the board
R3D1: U16.3 (D1); also elsewhere on the board
R3D2: U16.4 (D2); also elsewhere on the board
R3D3: U16.5 (D3); also elsewhere on the board
R3D4: U16.6 (D4); also elsewhere on the board
R3D5: U16.7 (D5); also elsewhere on the board
R3D6: U16.8 (D6); also elsewhere on the board
R3D7: U16.9 (D7); also elsewhere on the board
VCC: U12.20 (VCC), U13.20 (VCC), U15.20 (VCC), U16.20 (VCC), U17.1 (A->B), U17.20 (VCC), U18.28 (VCC), U19.9 (Clr), U19.16 (VCC); also elsewhere on the board
~CHARMODE: U18.20 (~CE), U19.6 (CE); also elsewhere on the board
~CHR_TO_COL: U17.19 (CE); also elsewhere on the board
~OE_L0: U12.1 (OE); also elsewhere on the board
~OE_L1: U13.1 (OE); also elsewhere on the board
~OE_L2: U15.1 (OE); also elsewhere on the board
~OE_L3: U16.1 (OE); also elsewhere on the board
~PE_CHPX: U19.15 (PE); also elsewhere on the board

Notes on the sheet:
character ROM

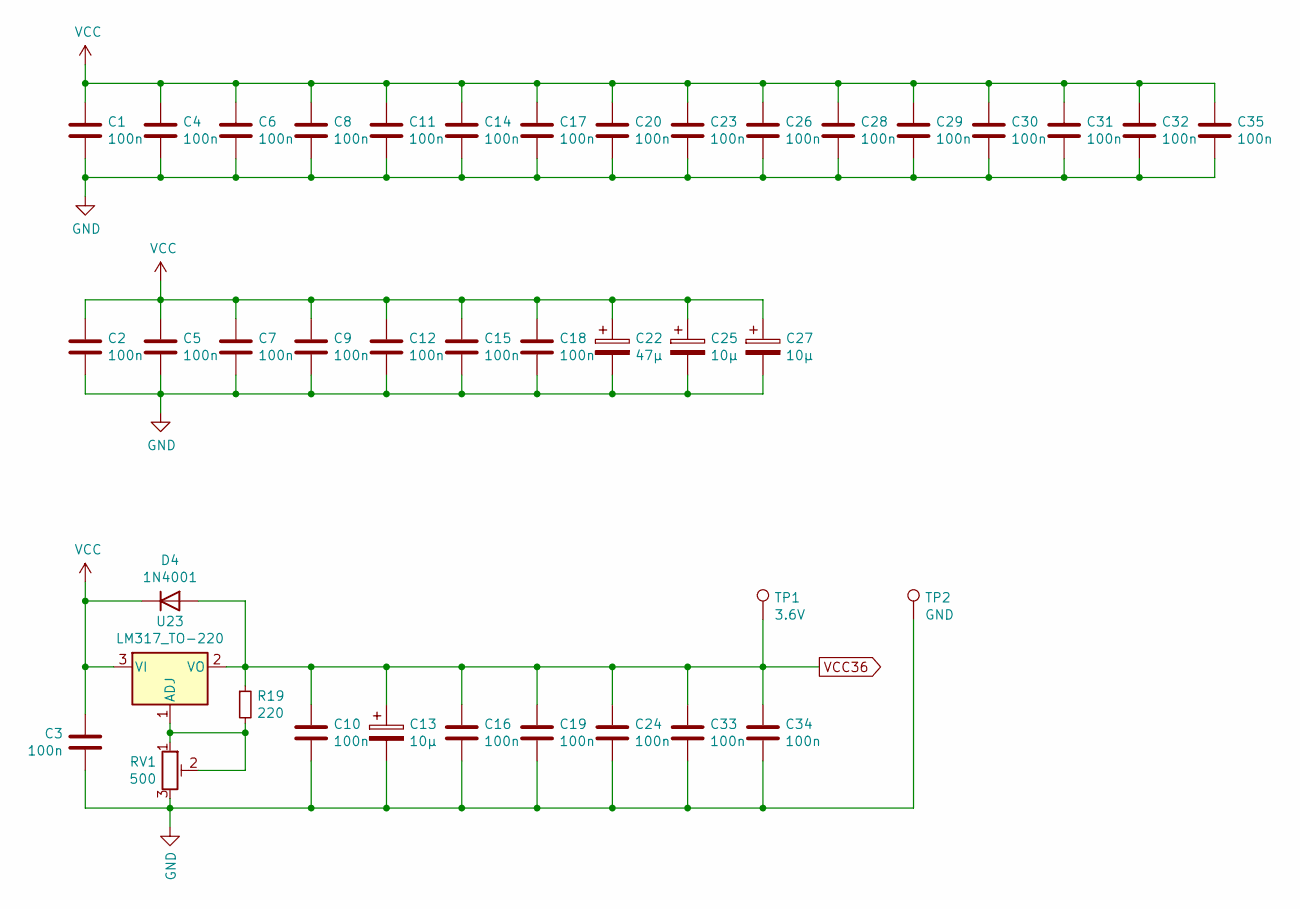
[picture p58: schematic misc.kicad_sch, Mini8086 VGA board]

Parts:
C1, C2, C3, C4, C6, C7, C8, C9, C10, C11, C14, C17, C23, C26, C29, C30, C31, C32: 100n; C_Disc_D4.3mm_W1.9mm_P5.00mm
C5, C12, C15, C16, C18, C19, C20, C24, C28, C33, C34, C35: 100n; C_1206_3216Metric
C13, C25, C27: 10µ; CP_Radial_D5.0mm_P2.50mm
C22: 47µ; CP_Radial_D5.0mm_P2.50mm
D4: 1N4001; D_DO-41_SOD81_P10.16mm_Horizontal
R19: 220; R_Axial_DIN0207_L6.3mm_D2.5mm_P2.54mm_Vertical
RV1: 500; Potentiometer_Runtron_RM-065_Vertical
TP1: 3.6V; TestPoint_Pad_D1.5mm
TP2: GND; TestPoint_Pad_D1.5mm
U23: LM317_TO-220; TO-220-3_Vertical

Connections:
GND: C1.2, C2.2, C3.2, C4.2, C5.2, C6.2, C7.2, C8.2, C9.2, C10.2, C11.2, C12.2, C13.2, C14.2, C15.2, C16.2, C17.2, C18.2, C19.2, C20.2, C22.2, C23.2, C24.2, C25.2, C26.2, C27.2, C28.2, C29.2, C30.2, C31.2, C32.2, C33.2, C34.2, C35.2, RV1.3, TP2.1; also elsewhere on the board
unnamed: R19.2, RV1.1, RV1.2, U23.1 (ADJ)
VCC: C1.1, C2.1, C3.1, C4.1, C5.1, C6.1, C7.1, C8.1, C9.1, C11.1, C12.1, C14.1, C15.1, C17.1, C18.1, C20.1, C22.1, C23.1, C25.1, C26.1, C27.1, C28.1, C29.1, C30.1, C31.1, C32.1, C35.1, D4.1 (K), U23.3 (VI); also elsewhere on the board
VCC36: C10.1, C13.1, C16.1, C19.1, C24.1, C33.1, C34.1, D4.2 (A), R19.1, TP1.1, U23.2 (VO); also elsewhere on the board

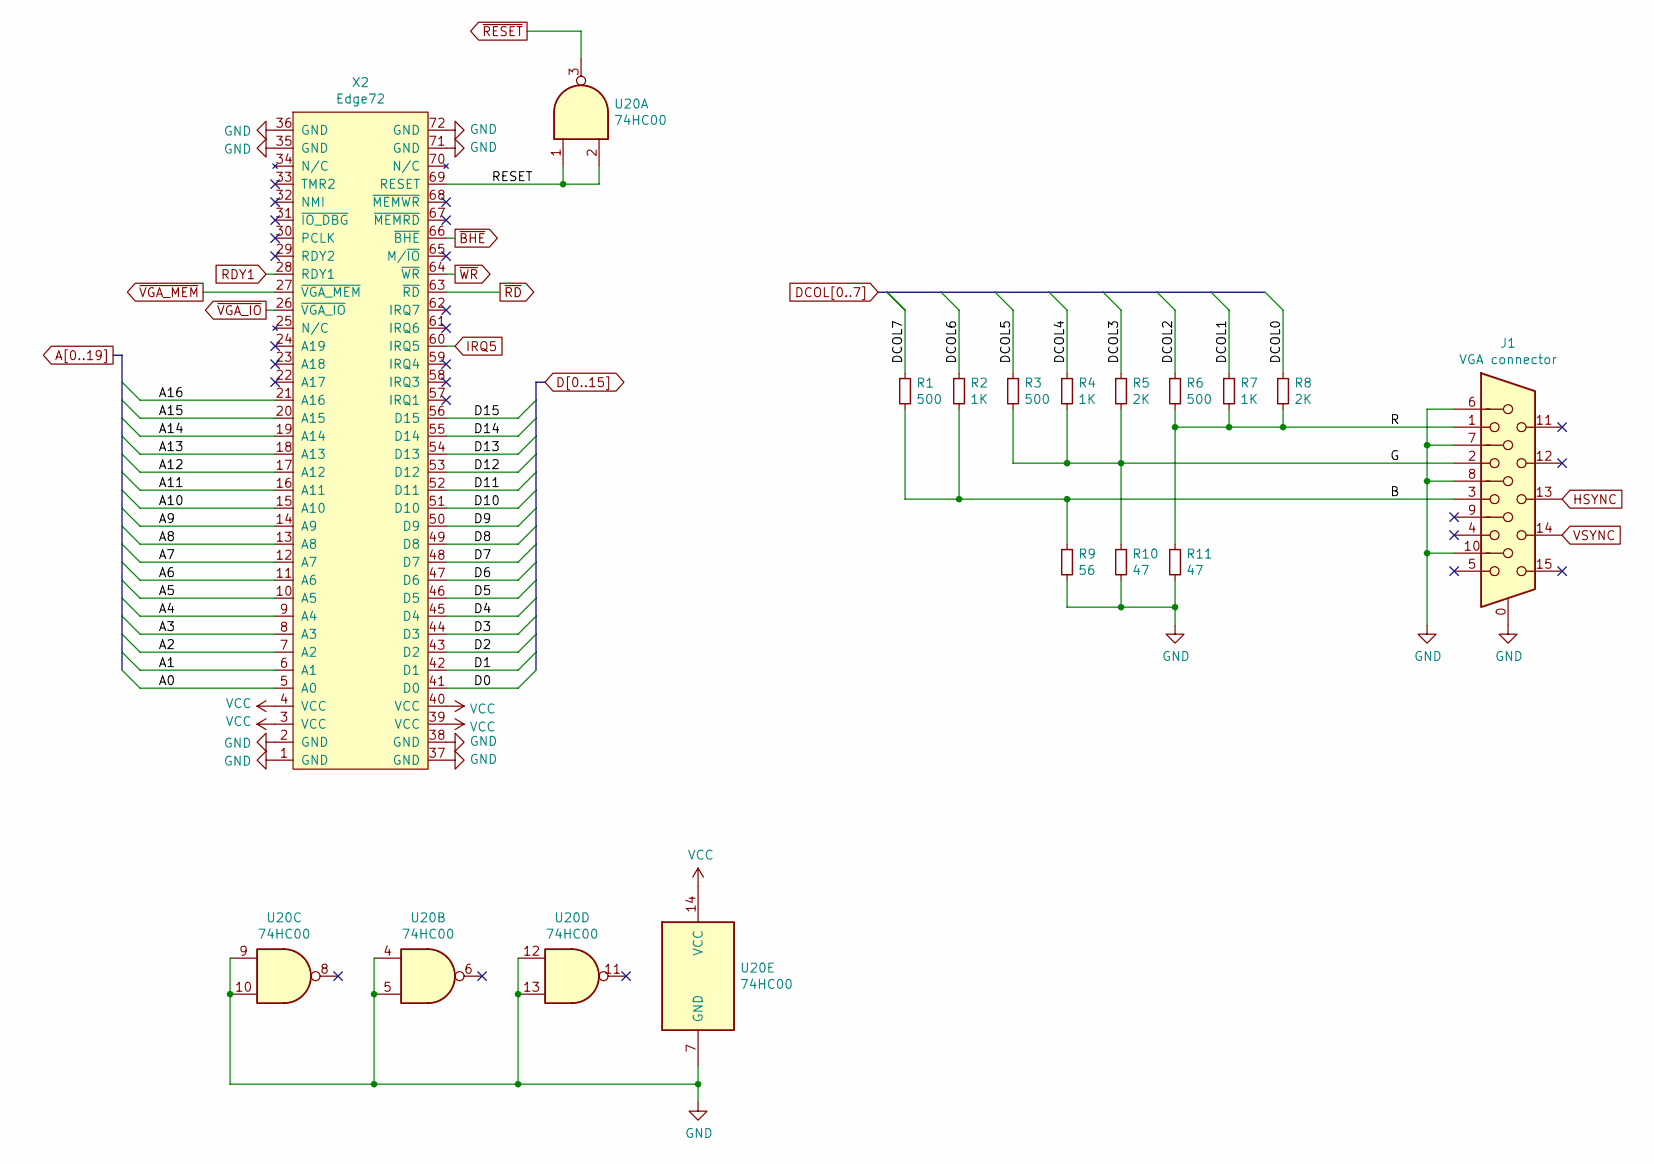
[picture p59: schematic connector.kicad_sch, Mini8086 VGA board]

Parts:
J1: VGA connector; DSUB-15-HD_Female_Horizontal_P2.29x1.98mm_EdgePinOffset3.03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
R1, R3, R6: 500; R_Axial_DIN0207_L6.3mm_D2.5mm_P7.62mm_Horizontal
R2, R4, R7: 1K; R_Axial_DIN0207_L6.3mm_D2.5mm_P7.62mm_Horizontal
R5, R8: 2K; R_Axial_DIN0207_L6.3mm_D2.5mm_P7.62mm_Horizontal
R9: 56; R_Axial_DIN0207_L6.3mm_D2.5mm_P7.62mm_Horizontal
R10, R11: 47; R_Axial_DIN0207_L6.3mm_D2.5mm_P7.62mm_Horizontal
U20: 74HC00; SOIC-14_3.9x8.7mm_P1.27mm
X2: Edge72; BUS_72

Connections:
/connector/B: J1.3, R1.2, R2.2, R9.1
/connector/G: J1.2, R3.2, R4.2, R5.2, R10.1
/connector/R: J1.1, R6.2, R7.2, R8.2, R11.1
/connector/RESET: U20.1, U20.2, X2.69 (RESET)
A0: X2.5 (A0); also elsewhere on the board
A1: X2.6 (A1); also elsewhere on the board
A2: X2.7 (A2); also elsewhere on the board
A3: X2.8 (A3); also elsewhere on the board
A4: X2.9 (A4); also elsewhere on the board
A5: X2.10 (A5); also elsewhere on the board
A6: X2.11 (A6); also elsewhere on the board
A7: X2.12 (A7); also elsewhere on the board
A8: X2.13 (A8); also elsewhere on the board
A9: X2.14 (A9); also elsewhere on the board
A10: X2.15 (A10); also elsewhere on the board
A11: X2.16 (A11); also elsewhere on the board
A12: X2.17 (A12); also elsewhere on the board
A13: X2.18 (A13); also elsewhere on the board
A14: X2.19 (A14); also elsewhere on the board
A15: X2.20 (A15); also elsewhere on the board
A16: X2.21 (A16); also elsewhere on the board
D0: X2.41 (D0); also elsewhere on the board
D1: X2.42 (D1); also elsewhere on the board
D2: X2.43 (D2); also elsewhere on the board
D3: X2.44 (D3); also elsewhere on the board
D4: X2.45 (D4); also elsewhere on the board
D5: X2.46 (D5); also elsewhere on the board
D6: X2.47 (D6); also elsewhere on the board
D7: X2.48 (D7); also elsewhere on the board
D8: X2.49 (D8); also elsewhere on the board
D9: X2.50 (D9); also elsewhere on the board
D10: X2.51 (D10); also elsewhere on the board
D11: X2.52 (D11); also elsewhere on the board
D12: X2.53 (D12); also elsewhere on the board
D13: X2.54 (D13); also elsewhere on the board
D14: X2.55 (D14); also elsewhere on the board
D15: X2.56 (D15); also elsewhere on the board
DCOL0: R8.1; also elsewhere on the board
DCOL1: R7.1; also elsewhere on the board
DCOL2: R6.1; also elsewhere on the board
DCOL3: R5.1; also elsewhere on the board
DCOL4: R4.1; also elsewhere on the board
DCOL5: R3.1; also elsewhere on the board
DCOL6: R2.1; also elsewhere on the board
DCOL7: R1.1; also elsewhere on the board
GND: J1.0, J1.6, J1.7, J1.8, J1.10, R9.2, R10.2, R11.2, U20.4, U20.5, U20.7 (GND), U20.9, U20.10, U20.12, U20.13, X2.1 (GND), X2.2 (GND), X2.35 (GND), X2.36 (GND), X2.37 (GND), X2.38 (GND), X2.71 (GND), X2.72 (GND); also elsewhere on the board
HSYNC: J1.13; also elsewhere on the board
IRQ5: X2.60 (IRQ5); also elsewhere on the board
RDY1: X2.28 (RDY1); also elsewhere on the board
VCC: U20.14 (VCC), X2.3 (VCC), X2.4 (VCC), X2.39 (VCC), X2.40 (VCC); also elsewhere on the board
VSYNC: J1.14; also elsewhere on the board
~BHE: X2.66 (~BHE); also elsewhere on the board
~RD: X2.63 (~RD); also elsewhere on the board
~RESET: U20.3; also elsewhere on the board
~VGA_IO: X2.26 (~VGA_IO); also elsewhere on the board
~VGA_MEM: X2.27 (~VGA_MEM); also elsewhere on the board
~WR: X2.64 (~WR); also elsewhere on the board

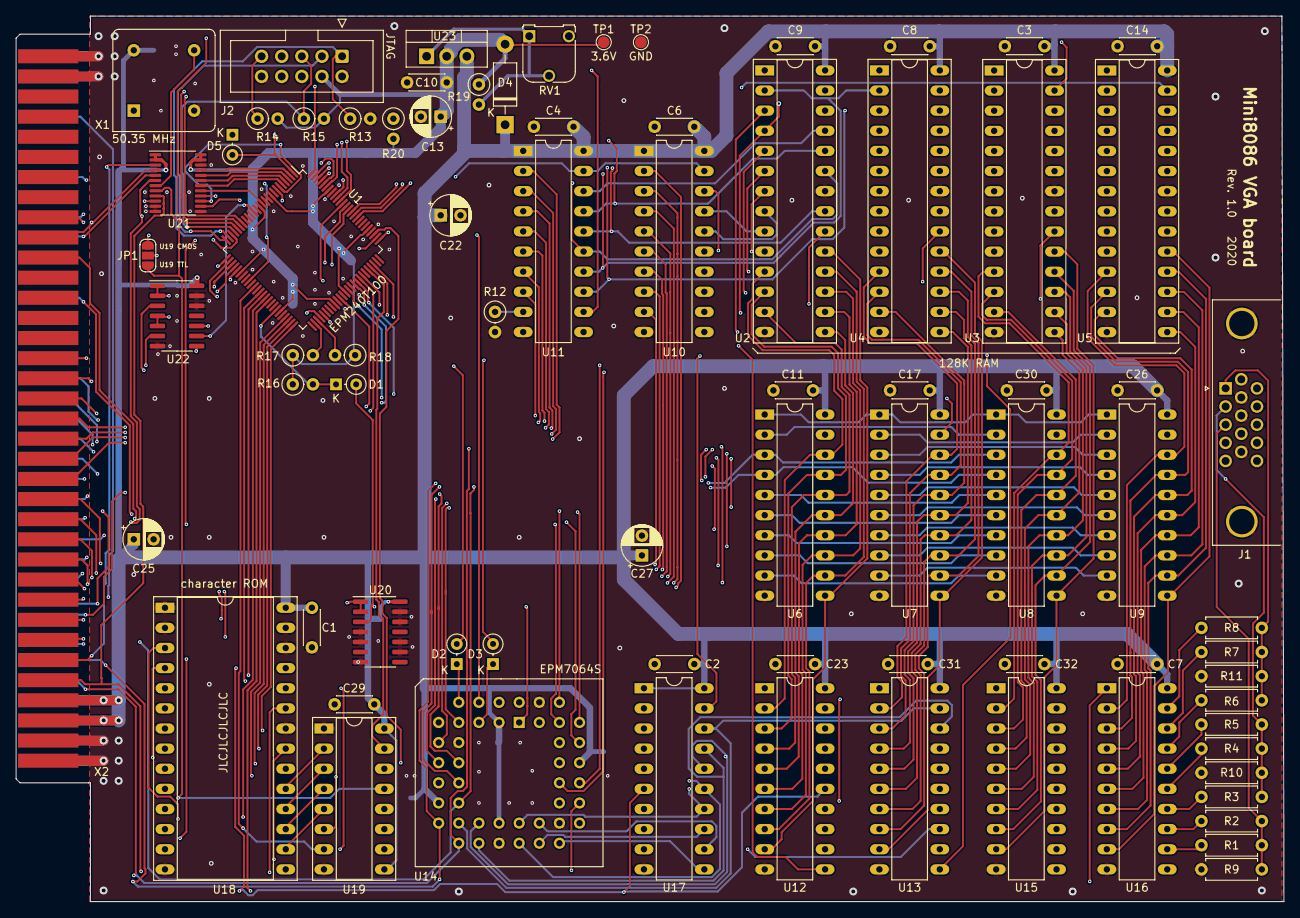
[picture p60: board vga.kicad_pcb from above]

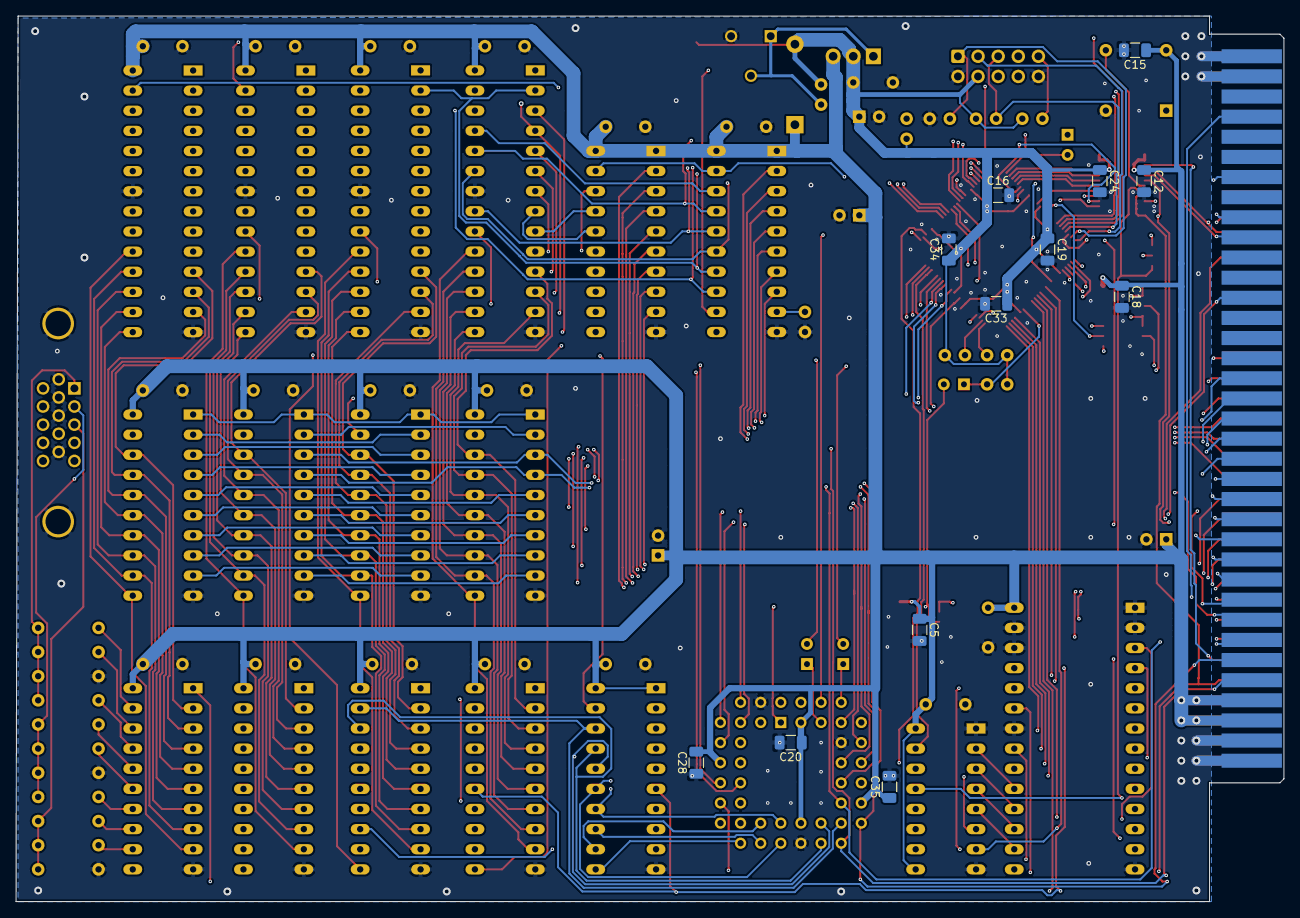
[picture p61: board vga.kicad_pcb from below]

Board: 4 copper layers, 160.0 x 111.8 mm, 90 parts (12 on the bottom side), 177 nets.
