svpetry/Mini8086/KiCad/main/main.kicad_pcb

## KiCad design KiCad/main/main.kicad_pcb (2021-03-30)

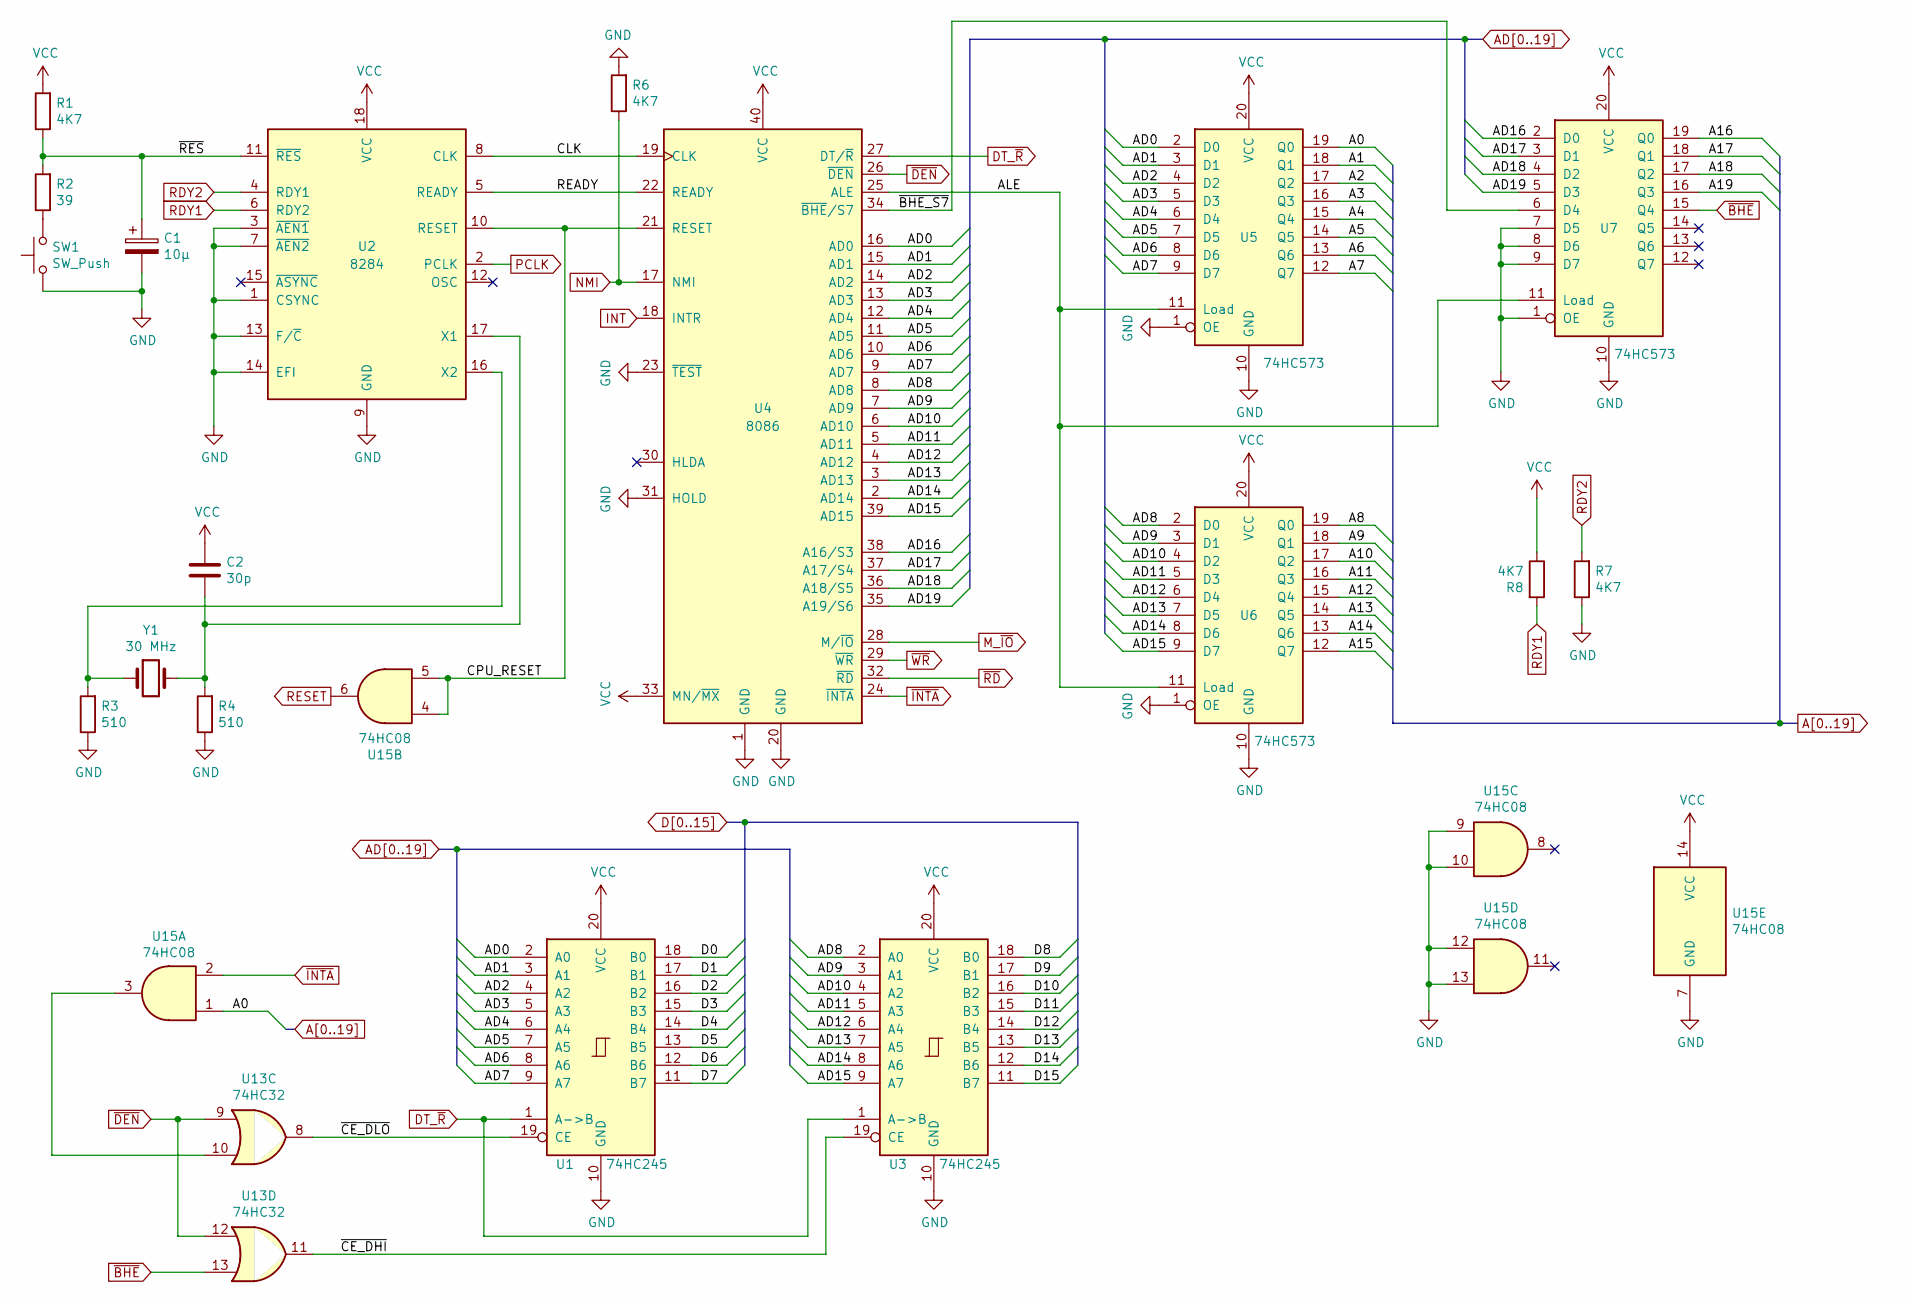
[picture p62: schematic cpu.kicad_sch, Mini8086 main system board]

Parts:
C1: 10µ; CP_Radial_D4.0mm_P2.00mm
C2: 30p; C_Disc_D3.0mm_W1.6mm_P2.50mm
R1, R6, R7, R8: 4K7; R_Axial_DIN0207_L6.3mm_D2.5mm_P7.62mm_Horizontal
R2: 39; R_Axial_DIN0207_L6.3mm_D2.5mm_P7.62mm_Horizontal
R3, R4: 510; R_Axial_DIN0207_L6.3mm_D2.5mm_P7.62mm_Horizontal
SW1: SW_Push; SW_PUSH_6mm
U1, U3: 74HC245; DIP-20_W7.62mm_LongPads
U2: 8284; DIP-18_W7.62mm_Socket_LongPads
U4: 8086; DIP-40_W15.24mm_Socket_LongPads
U5, U6, U7: 74HC573; DIP-20_W7.62mm_LongPads
U13: 74HC32; DIP-14_W7.62mm_LongPads
U15: 74HC08; DIP-14_W7.62mm_LongPads
Y1: 30 MHz; Crystal_HC18-U_Vertical

Connections:
/CPU/ALE: U4.25 (ALE), U5.11 (Load), U6.11 (Load), U7.11 (Load)
/CPU/CLK: U2.8 (CLK), U4.19 (CLK)
/CPU/CPU_RESET: U2.10 (RESET), U4.21 (RESET), U15.4, U15.5
/CPU/READY: U2.5 (READY), U4.22 (READY)
/CPU/~CE_DHI: U3.19 (CE), U13.11
/CPU/~CE_DLO: U1.19 (CE), U13.8
/CPU/~RES: C1.1, R1.1, R2.2, U2.11 (~RES)
A0: U5.19 (Q0), U15.1; also elsewhere on the board
A1: U5.18 (Q1); also elsewhere on the board
A2: U5.17 (Q2); also elsewhere on the board
A3: U5.16 (Q3); also elsewhere on the board
A4: U5.15 (Q4); also elsewhere on the board
A5: U5.14 (Q5); also elsewhere on the board
A6: U5.13 (Q6); also elsewhere on the board
A7: U5.12 (Q7); also elsewhere on the board
A8: U6.19 (Q0); also elsewhere on the board
A9: U6.18 (Q1); also elsewhere on the board
A10: U6.17 (Q2); also elsewhere on the board
A11: U6.16 (Q3); also elsewhere on the board
A12: U6.15 (Q4); also elsewhere on the board
A13: U6.14 (Q5); also elsewhere on the board
A14: U6.13 (Q6); also elsewhere on the board
A15: U6.12 (Q7); also elsewhere on the board
A16: U7.19 (Q0); also elsewhere on the board
A17: U7.18 (Q1); also elsewhere on the board
A18: U7.17 (Q2); also elsewhere on the board
A19: U7.16 (Q3); also elsewhere on the board
AD0: U1.2 (A0), U4.16 (AD0), U5.2 (D0)
AD1: U1.3 (A1), U4.15 (AD1), U5.3 (D1)
AD2: U1.4 (A2), U4.14 (AD2), U5.4 (D2)
AD3: U1.5 (A3), U4.13 (AD3), U5.5 (D3)
AD4: U1.6 (A4), U4.12 (AD4), U5.6 (D4)
AD5: U1.7 (A5), U4.11 (AD5), U5.7 (D5)
AD6: U1.8 (A6), U4.10 (AD6), U5.8 (D6)
AD7: U1.9 (A7), U4.9 (AD7), U5.9 (D7)
AD8: U3.2 (A0), U4.8 (AD8), U6.2 (D0)
AD9: U3.3 (A1), U4.7 (AD9), U6.3 (D1)
AD10: U3.4 (A2), U4.6 (AD10), U6.4 (D2)
AD11: U3.5 (A3), U4.5 (AD11), U6.5 (D3)
AD12: U3.6 (A4), U4.4 (AD12), U6.6 (D4)
AD13: U3.7 (A5), U4.3 (AD13), U6.7 (D5)
AD14: U3.8 (A6), U4.2 (AD14), U6.8 (D6)
AD15: U3.9 (A7), U4.39 (AD15), U6.9 (D7)
AD16: U4.38 (A16/S3), U7.2 (D0)
AD17: U4.37 (A17/S4), U7.3 (D1)
AD18: U4.36 (A18/S5), U7.4 (D2)
AD19: U4.35 (A19/S6), U7.5 (D3)
D0: U1.18 (B0); also elsewhere on the board
D1: U1.17 (B1); also elsewhere on the board
D2: U1.16 (B2); also elsewhere on the board
D3: U1.15 (B3); also elsewhere on the board
D4: U1.14 (B4); also elsewhere on the board
D5: U1.13 (B5); also elsewhere on the board
D6: U1.12 (B6); also elsewhere on the board
D7: U1.11 (B7); also elsewhere on the board
D8: U3.18 (B0); also elsewhere on the board
D9: U3.17 (B1); also elsewhere on the board
D10: U3.16 (B2); also elsewhere on the board
D11: U3.15 (B3); also elsewhere on the board
D12: U3.14 (B4); also elsewhere on the board
D13: U3.13 (B5); also elsewhere on the board
D14: U3.12 (B6); also elsewhere on the board
D15: U3.11 (B7); also elsewhere on the board
DT_~R: U1.1 (A->B), U3.1 (A->B), U4.27 (DT/~R)
GND: C1.2, R3.1, R4.1, R6.2, R7.1, SW1.1, U1.10 (GND), U2.1 (CSYNC), U2.3 (~AEN1), U2.7 (~AEN2), U2.9 (GND), U2.13 (F/~C), U2.14 (EFI), U3.10 (GND), U4.1 (GND), U4.20 (GND), U4.23 (~TEST), U4.31 (HOLD), U5.1 (OE), U5.10 (GND), U6.1 (OE), U6.10 (GND), U7.1 (OE), U7.7 (D5), U7.8 (D6), U7.9 (D7), U7.10 (GND), U15.7 (GND), U15.9, U15.10, U15.12, U15.13; also elsewhere on the board
INT: U4.18 (INTR); also elsewhere on the board
M_~IO: U4.28 (M/~IO); also elsewhere on the board
NMI: R6.1, U4.17 (NMI); also elsewhere on the board
unnamed: C2.1, R4.2, U2.17 (X1), Y1.2
unnamed: R2.1, SW1.2
unnamed: R3.2, U2.16 (X2), Y1.1
unnamed: U4.34 (~BHE/S7), U7.6 (D4)
unnamed: U13.10, U15.3
PCLK: U2.2 (PCLK); also elsewhere on the board
RDY1: R8.2, U2.6 (RDY2); also elsewhere on the board
RDY2: R7.2, U2.4 (RDY1); also elsewhere on the board
RESET: U15.6; also elsewhere on the board
VCC: C2.2, R1.2, R8.1, U1.20 (VCC), U2.18 (VCC), U3.20 (VCC), U4.33 (MN/~MX), U4.40 (VCC), U5.20 (VCC), U6.20 (VCC), U7.20 (VCC), U15.14 (VCC); also elsewhere on the board
~BHE: U7.15 (Q4), U13.13; also elsewhere on the board
~DEN: U4.26 (~DEN), U13.9, U13.12
~INTA: U4.24 (~INTA), U15.2; also elsewhere on the board
~RD: U4.32 (~RD); also elsewhere on the board
~WR: U4.29 (~WR); also elsewhere on the board
