svpetry/Mini8086/KiCad/main/main.kicad_pcb

## KiCad design KiCad/main/main.kicad_pcb (continued)

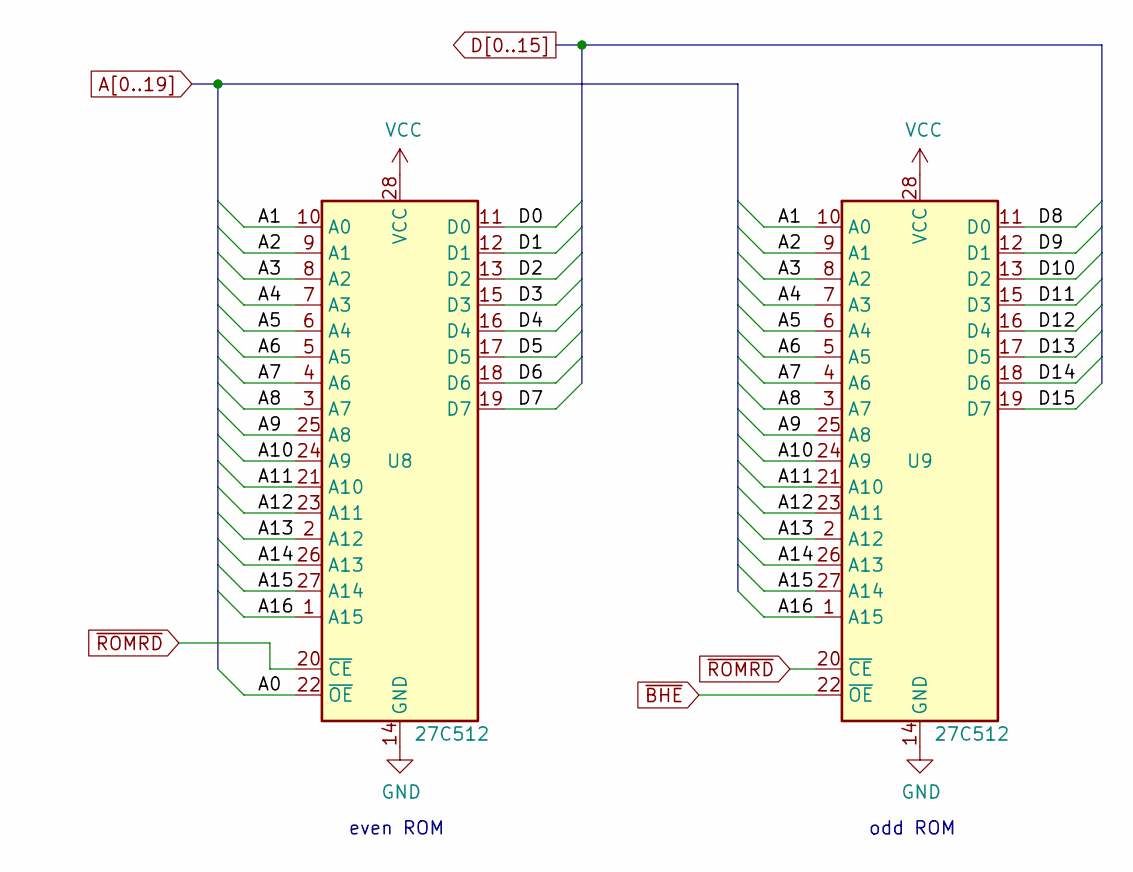
[picture p63: schematic rom.kicad_sch, Mini8086 main system board]

Parts:
U8, U9: 27C512; DIP_Socket-28_W11.9_W12.7_W15.24_W17.78_W18.5_3M_228-1277-0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

Connections:
A0: U8.22 (~OE); also elsewhere on the board
A1: U8.10 (A0), U9.10 (A0); also elsewhere on the board
A2: U8.9 (A1), U9.9 (A1); also elsewhere on the board
A3: U8.8 (A2), U9.8 (A2); also elsewhere on the board
A4: U8.7 (A3), U9.7 (A3); also elsewhere on the board
A5: U8.6 (A4), U9.6 (A4); also elsewhere on the board
A6: U8.5 (A5), U9.5 (A5); also elsewhere on the board
A7: U8.4 (A6), U9.4 (A6); also elsewhere on the board
A8: U8.3 (A7), U9.3 (A7); also elsewhere on the board
A9: U8.25 (A8), U9.25 (A8); also elsewhere on the board
A10: U8.24 (A9), U9.24 (A9); also elsewhere on the board
A11: U8.21 (A10), U9.21 (A10); also elsewhere on the board
A12: U8.23 (A11), U9.23 (A11); also elsewhere on the board
A13: U8.2 (A12), U9.2 (A12); also elsewhere on the board
A14: U8.26 (A13), U9.26 (A13); also elsewhere on the board
A15: U8.27 (A14), U9.27 (A14); also elsewhere on the board
A16: U8.1 (A15), U9.1 (A15); also elsewhere on the board
D0: U8.11 (D0); also elsewhere on the board
D1: U8.12 (D1); also elsewhere on the board
D2: U8.13 (D2); also elsewhere on the board
D3: U8.15 (D3); also elsewhere on the board
D4: U8.16 (D4); also elsewhere on the board
D5: U8.17 (D5); also elsewhere on the board
D6: U8.18 (D6); also elsewhere on the board
D7: U8.19 (D7); also elsewhere on the board
D8: U9.11 (D0); also elsewhere on the board
D9: U9.12 (D1); also elsewhere on the board
D10: U9.13 (D2); also elsewhere on the board
D11: U9.15 (D3); also elsewhere on the board
D12: U9.16 (D4); also elsewhere on the board
D13: U9.17 (D5); also elsewhere on the board
D14: U9.18 (D6); also elsewhere on the board
D15: U9.19 (D7); also elsewhere on the board
GND: U8.14 (GND), U9.14 (GND); also elsewhere on the board
VCC: U8.28 (VCC), U9.28 (VCC); also elsewhere on the board
~BHE: U9.22 (~OE); also elsewhere on the board
~ROMRD: U8.20 (~CE), U9.20 (~CE); also elsewhere on the board

Notes on the sheet:
even ROM
odd ROM

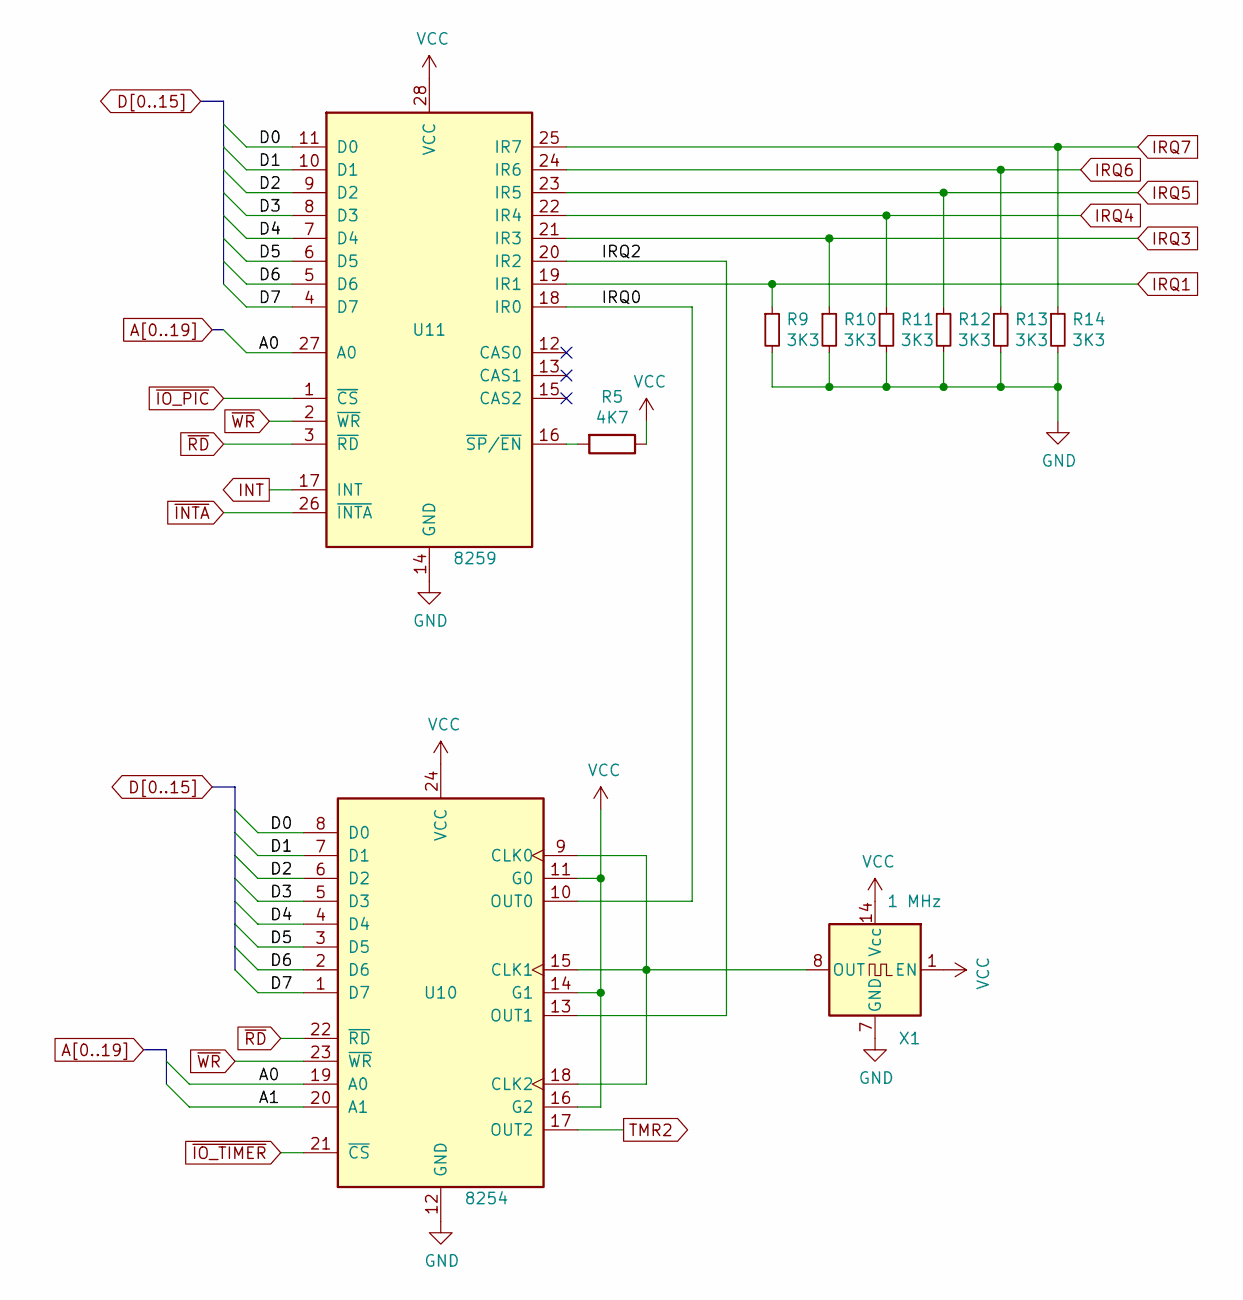
[picture p64: schematic pic_timer.kicad_sch, Mini8086 main system board]

Parts:
R5: 4K7; R_Axial_DIN0207_L6.3mm_D2.5mm_P7.62mm_Horizontal
R9, R10, R11, R12, R13, R14: 3K3; R_Axial_DIN0207_L6.3mm_D2.5mm_P2.54mm_Vertical
U10: 8254; DIP-24_W15.24mm_Socket_LongPads
U11: 8259; DIP-28_W15.24mm_Socket_LongPads
X1: 1 MHz; Oscillator_DIP-14

Connections:
/PIC TIMER/IRQ0: U10.10 (OUT0), U11.18 (IR0)
/PIC TIMER/IRQ2: U10.13 (OUT1), U11.20 (IR2)
A0: U10.19 (A0), U11.27 (A0); also elsewhere on the board
A1: U10.20 (A1); also elsewhere on the board
D0: U10.8 (D0), U11.11 (D0); also elsewhere on the board
D1: U10.7 (D1), U11.10 (D1); also elsewhere on the board
D2: U10.6 (D2), U11.9 (D2); also elsewhere on the board
D3: U10.5 (D3), U11.8 (D3); also elsewhere on the board
D4: U10.4 (D4), U11.7 (D4); also elsewhere on the board
D5: U10.3 (D5), U11.6 (D5); also elsewhere on the board
D6: U10.2 (D6), U11.5 (D6); also elsewhere on the board
D7: U10.1 (D7), U11.4 (D7); also elsewhere on the board
GND: R9.2, R10.2, R11.2, R12.2, R13.2, R14.2, U10.12 (GND), U11.14 (GND), X1.7 (GND); also elsewhere on the board
INT: U11.17 (INT); also elsewhere on the board
IRQ1: R9.1, U11.19 (IR1); also elsewhere on the board
IRQ3: R10.1, U11.21 (IR3); also elsewhere on the board
IRQ4: R11.1, U11.22 (IR4); also elsewhere on the board
IRQ5: R12.1, U11.23 (IR5); also elsewhere on the board
IRQ6: R13.1, U11.24 (IR6); also elsewhere on the board
IRQ7: R14.1, U11.25 (IR7); also elsewhere on the board
unnamed: R5.2, U11.16 (~SP/~EN)
unnamed: U10.9 (CLK0), U10.15 (CLK1), U10.18 (CLK2), X1.8 (OUT)
TMR2: U10.17 (OUT2); also elsewhere on the board
VCC: R5.1, U10.11 (G0), U10.14 (G1), U10.16 (G2), U10.24 (VCC), U11.28 (VCC), X1.1 (EN), X1.14 (Vcc); also elsewhere on the board
~INTA: U11.26 (~INTA); also elsewhere on the board
~IO_PIC: U11.1 (~CS); also elsewhere on the board
~IO_TIMER: U10.21 (~CS); also elsewhere on the board
~RD: U10.22 (~RD), U11.3 (~RD); also elsewhere on the board
~WR: U10.23 (~WR), U11.2 (~WR); also elsewhere on the board

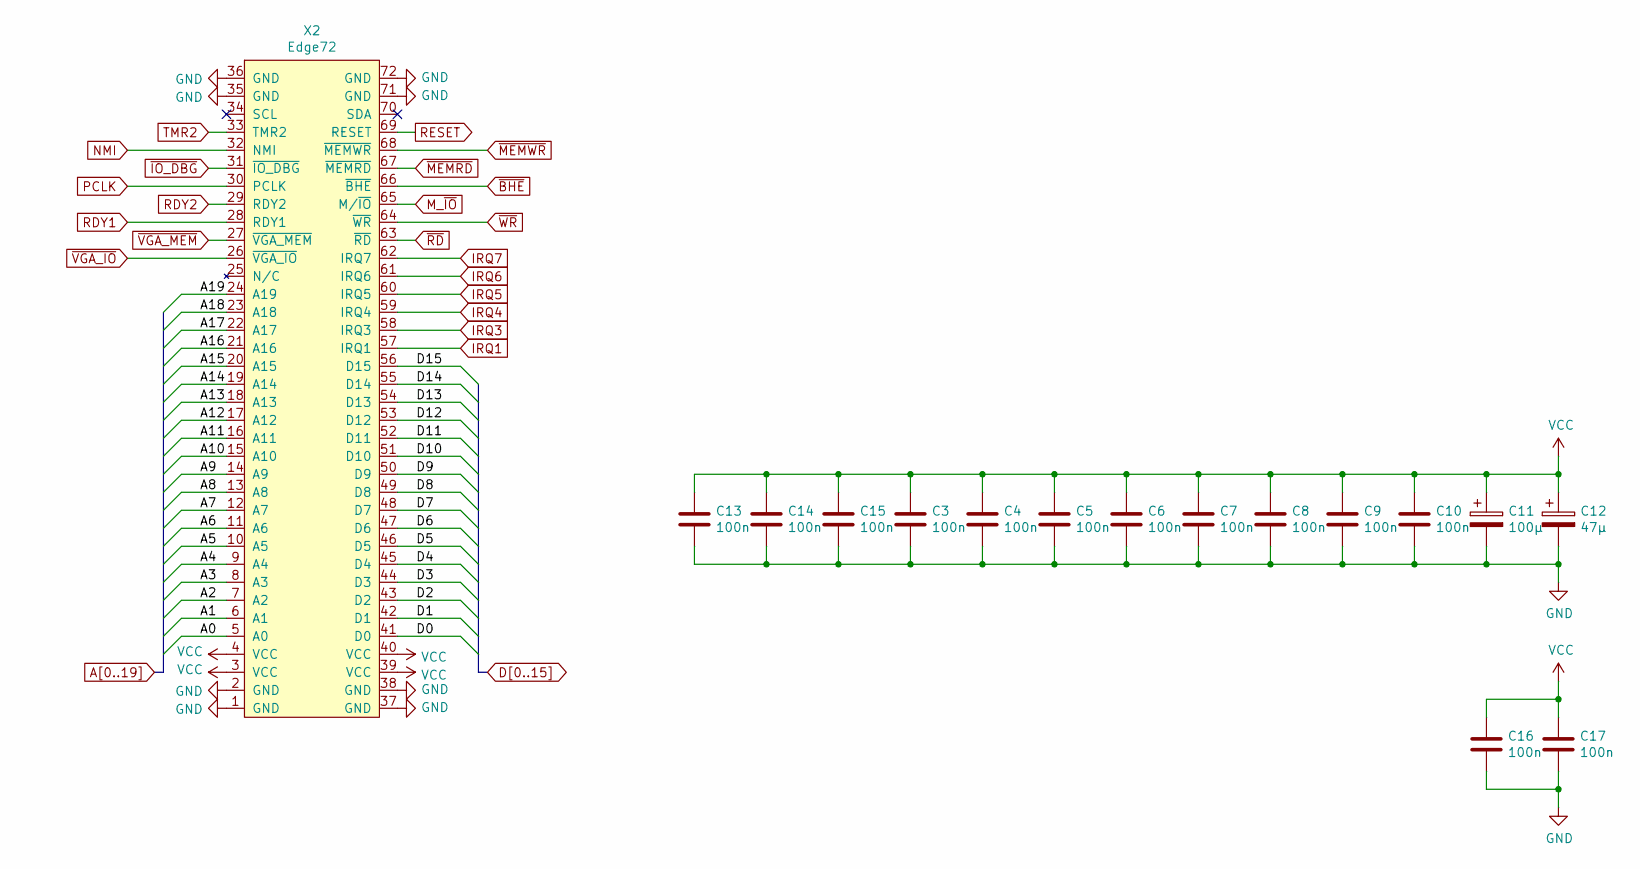
[picture p65: schematic connector.kicad_sch, Mini8086 main system board]

Parts:
C3, C4, C5, C6, C7, C8, C9, C10, C13, C14, C15, C16, C17: 100n; C_Disc_D4.3mm_W1.9mm_P5.00mm
C11: 100µ; CP_Radial_D8.0mm_P3.50mm
C12: 47µ; CP_Radial_D4.0mm_P2.00mm
X2: Edge72; BUS_72

Connections:
A0: X2.5 (A0); also elsewhere on the board
A1: X2.6 (A1); also elsewhere on the board
A2: X2.7 (A2); also elsewhere on the board
A3: X2.8 (A3); also elsewhere on the board
A4: X2.9 (A4); also elsewhere on the board
A5: X2.10 (A5); also elsewhere on the board
A6: X2.11 (A6); also elsewhere on the board
A7: X2.12 (A7); also elsewhere on the board
A8: X2.13 (A8); also elsewhere on the board
A9: X2.14 (A9); also elsewhere on the board
A10: X2.15 (A10); also elsewhere on the board
A11: X2.16 (A11); also elsewhere on the board
A12: X2.17 (A12); also elsewhere on the board
A13: X2.18 (A13); also elsewhere on the board
A14: X2.19 (A14); also elsewhere on the board
A15: X2.20 (A15); also elsewhere on the board
A16: X2.21 (A16); also elsewhere on the board
A17: X2.22 (A17); also elsewhere on the board
A18: X2.23 (A18); also elsewhere on the board
A19: X2.24 (A19); also elsewhere on the board
D0: X2.41 (D0); also elsewhere on the board
D1: X2.42 (D1); also elsewhere on the board
D2: X2.43 (D2); also elsewhere on the board
D3: X2.44 (D3); also elsewhere on the board
D4: X2.45 (D4); also elsewhere on the board
D5: X2.46 (D5); also elsewhere on the board
D6: X2.47 (D6); also elsewhere on the board
D7: X2.48 (D7); also elsewhere on the board
D8: X2.49 (D8); also elsewhere on the board
D9: X2.50 (D9); also elsewhere on the board
D10: X2.51 (D10); also elsewhere on the board
D11: X2.52 (D11); also elsewhere on the board
D12: X2.53 (D12); also elsewhere on the board
D13: X2.54 (D13); also elsewhere on the board
D14: X2.55 (D14); also elsewhere on the board
D15: X2.56 (D15); also elsewhere on the board
GND: C3.2, C4.2, C5.2, C6.2, C7.2, C8.2, C9.2, C10.2, C11.2, C12.2, C13.2, C14.2, C15.2, C16.2, C17.2, X2.1 (GND), X2.2 (GND), X2.35 (GND), X2.36 (GND), X2.37 (GND), X2.38 (GND), X2.71 (GND), X2.72 (GND); also elsewhere on the board
IRQ1: X2.57 (IRQ1); also elsewhere on the board
IRQ3: X2.58 (IRQ3); also elsewhere on the board
IRQ4: X2.59 (IRQ4); also elsewhere on the board
IRQ5: X2.60 (IRQ5); also elsewhere on the board
IRQ6: X2.61 (IRQ6); also elsewhere on the board
IRQ7: X2.62 (IRQ7); also elsewhere on the board
M_~IO: X2.65 (M/~IO); also elsewhere on the board
NMI: X2.32 (NMI); also elsewhere on the board
PCLK: X2.30 (PCLK); also elsewhere on the board
RDY1: X2.28 (RDY1); also elsewhere on the board
RDY2: X2.29 (RDY2); also elsewhere on the board
RESET: X2.69 (RESET); also elsewhere on the board
TMR2: X2.33 (TMR2); also elsewhere on the board
VCC: C3.1, C4.1, C5.1, C6.1, C7.1, C8.1, C9.1, C10.1, C11.1, C12.1, C13.1, C14.1, C15.1, C16.1, C17.1, X2.3 (VCC), X2.4 (VCC), X2.39 (VCC), X2.40 (VCC); also elsewhere on the board
~BHE: X2.66 (~BHE); also elsewhere on the board
~IO_DBG: X2.31 (~IO_DBG); also elsewhere on the board
~MEMRD: X2.67 (~MEMRD); also elsewhere on the board
~MEMWR: X2.68 (~MEMWR); also elsewhere on the board
~RD: X2.63 (~RD); also elsewhere on the board
~VGA_IO: X2.26 (~VGA_IO); also elsewhere on the board
~VGA_MEM: X2.27 (~VGA_MEM); also elsewhere on the board
~WR: X2.64 (~WR); also elsewhere on the board

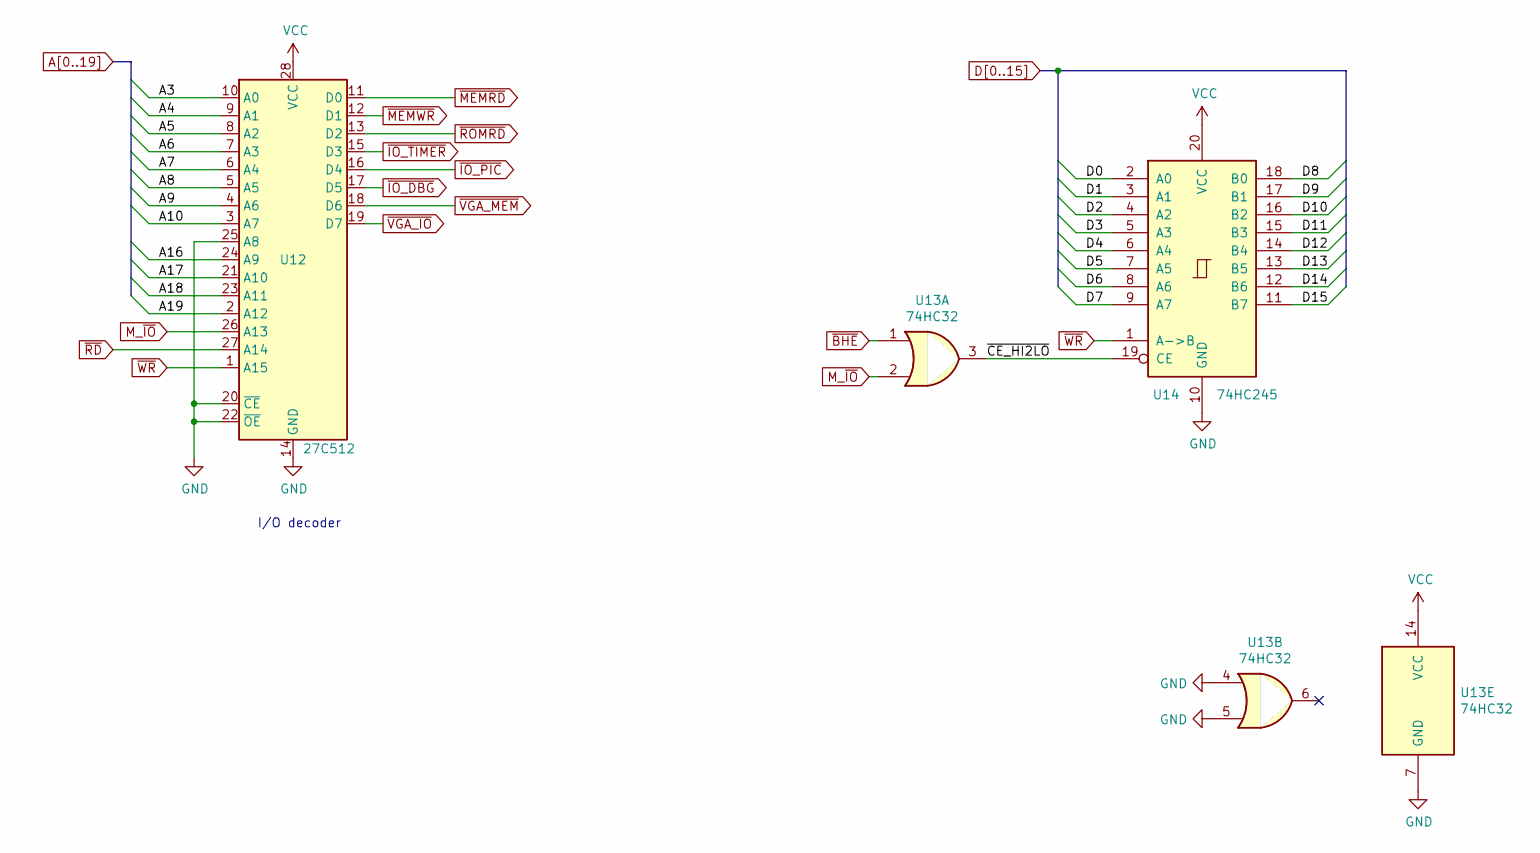
[picture p66: schematic misc.kicad_sch, Mini8086 main system board]

Parts:
U12: 27C512; DIP-28_W15.24mm_Socket_LongPads
U13: 74HC32; DIP-14_W7.62mm_LongPads
U14: 74HC245; SO-20_12.8x7.5mm_P1.27mm

Connections:
/glue logic/~CE_HI2LO: U13.3, U14.19 (CE)
A3: U12.10 (A0); also elsewhere on the board
A4: U12.9 (A1); also elsewhere on the board
A5: U12.8 (A2); also elsewhere on the board
A6: U12.7 (A3); also elsewhere on the board
A7: U12.6 (A4); also elsewhere on the board
A8: U12.5 (A5); also elsewhere on the board
A9: U12.4 (A6); also elsewhere on the board
A10: U12.3 (A7); also elsewhere on the board
A16: U12.24 (A9); also elsewhere on the board
A17: U12.21 (A10); also elsewhere on the board
A18: U12.23 (A11); also elsewhere on the board
A19: U12.2 (A12); also elsewhere on the board
D0: U14.2 (A0); also elsewhere on the board
D1: U14.3 (A1); also elsewhere on the board
D2: U14.4 (A2); also elsewhere on the board
D3: U14.5 (A3); also elsewhere on the board
D4: U14.6 (A4); also elsewhere on the board
D5: U14.7 (A5); also elsewhere on the board
D6: U14.8 (A6); also elsewhere on the board
D7: U14.9 (A7); also elsewhere on the board
D8: U14.18 (B0); also elsewhere on the board
D9: U14.17 (B1); also elsewhere on the board
D10: U14.16 (B2); also elsewhere on the board
D11: U14.15 (B3); also elsewhere on the board
D12: U14.14 (B4); also elsewhere on the board
D13: U14.13 (B5); also elsewhere on the board
D14: U14.12 (B6); also elsewhere on the board
D15: U14.11 (B7); also elsewhere on the board
GND: U12.14 (GND), U12.20 (~CE), U12.22 (~OE), U12.25 (A8), U13.4, U13.5, U13.7 (GND), U14.10 (GND); also elsewhere on the board
M_~IO: U12.26 (A13), U13.2; also elsewhere on the board
VCC: U12.28 (VCC), U13.14 (VCC), U14.20 (VCC); also elsewhere on the board
~BHE: U13.1; also elsewhere on the board
~IO_DBG: U12.17 (D5); also elsewhere on the board
~IO_PIC: U12.16 (D4); also elsewhere on the board
~IO_TIMER: U12.15 (D3); also elsewhere on the board
~MEMRD: U12.11 (D0); also elsewhere on the board
~MEMWR: U12.12 (D1); also elsewhere on the board
~RD: U12.27 (A14); also elsewhere on the board
~ROMRD: U12.13 (D2); also elsewhere on the board
~VGA_IO: U12.19 (D7); also elsewhere on the board
~VGA_MEM: U12.18 (D6); also elsewhere on the board
~WR: U12.1 (A15), U14.1 (A->B); also elsewhere on the board

Notes on the sheet:
I/O decoder

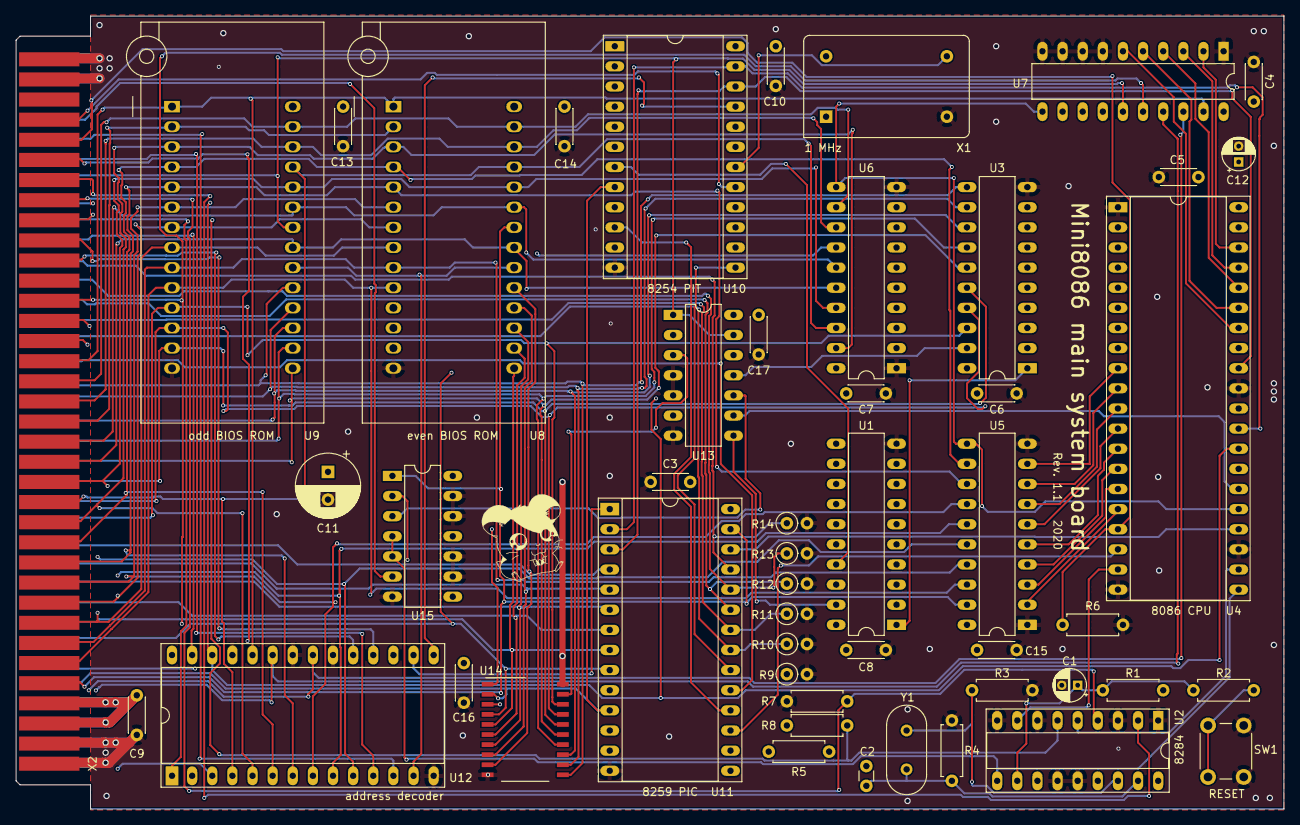
[picture p67: board KiCad/main/main.kicad_pcb from above]

Board: 4 copper layers, 160.0 x 100.1 mm, 50 parts (0 on the bottom side), 103 nets.
