svpetry/Mini8086/KiCad/main_v2/main.kicad_pcb

## KiCad design KiCad/main_v2/main.kicad_pcb (2021-03-30)

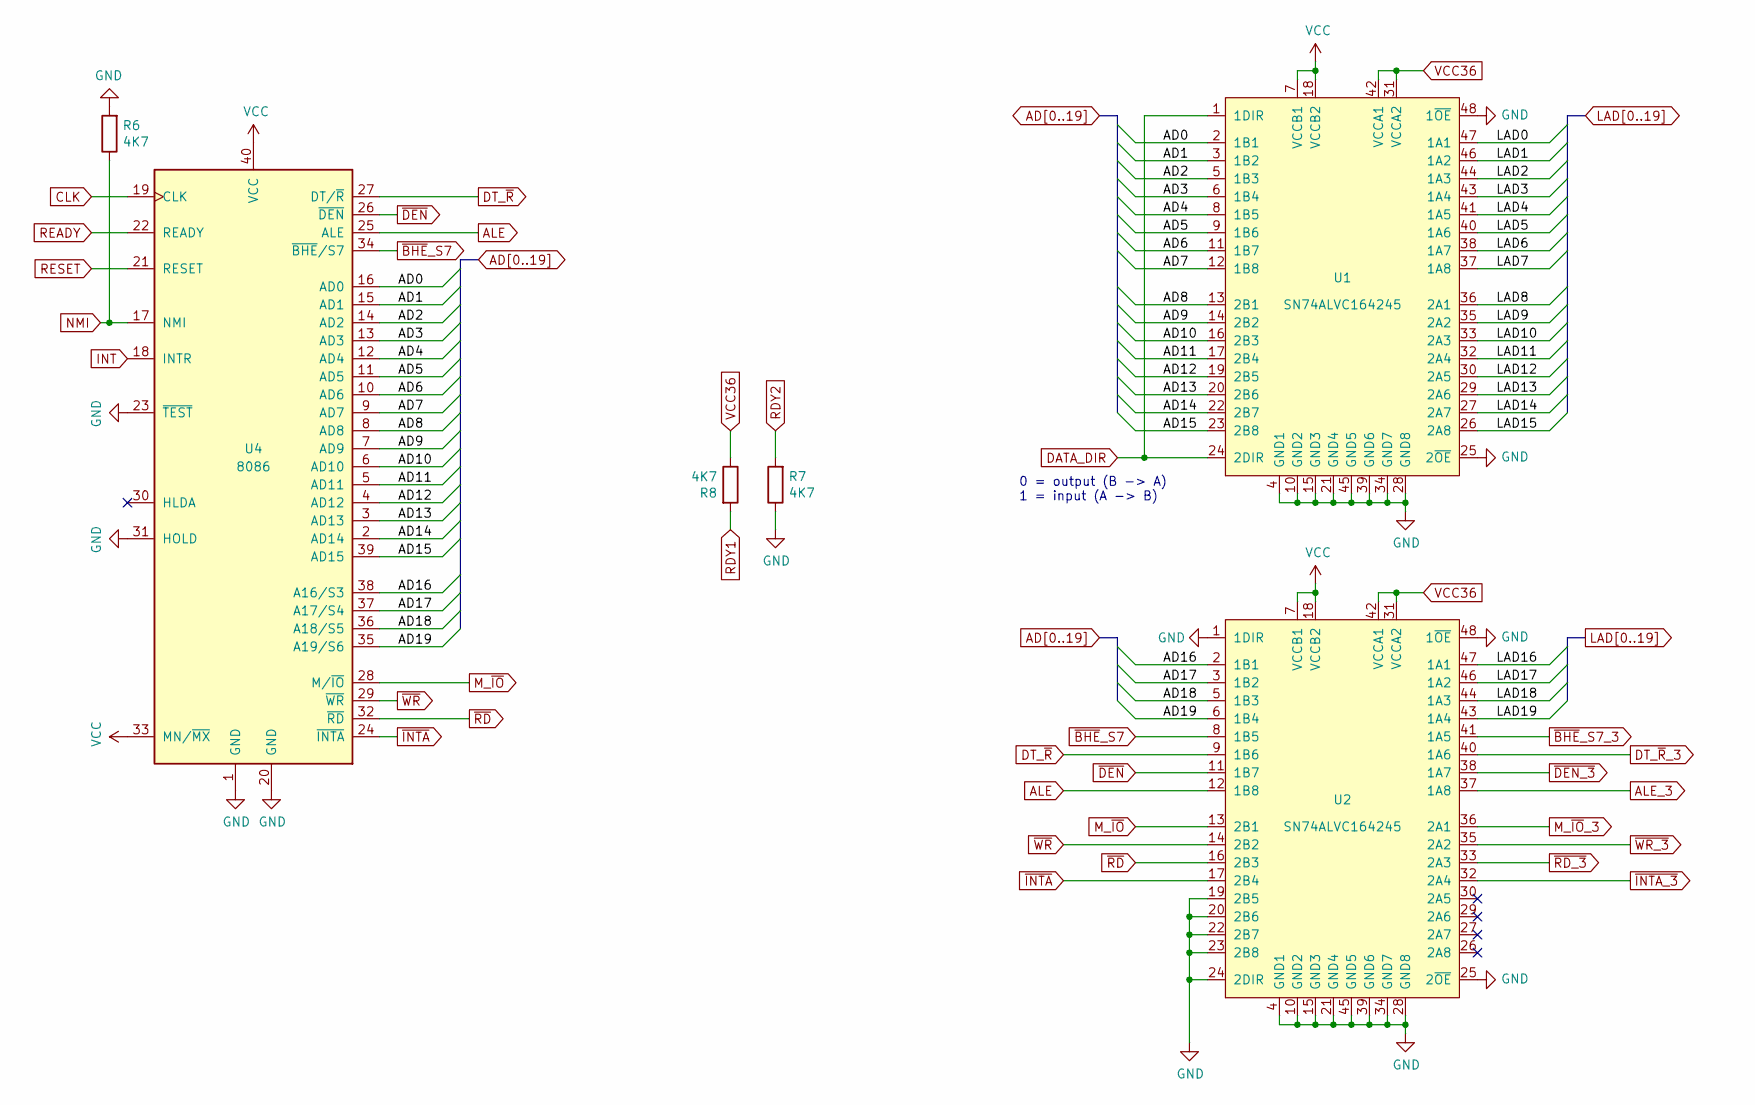
[picture p68: schematic cpu.kicad_sch, Mini8086 main system board]

Parts:
R6, R7, R8: 4K7; R_1206_3216Metric
U1, U2: SN74ALVC164245; SSOP-48_7.5x15.9mm_P0.635mm
U4: 8086; DIP-40_W15.24mm_Socket_LongPads

Connections:
AD0: U1.2 (1B1), U4.16 (AD0)
AD1: U1.3 (1B2), U4.15 (AD1)
AD2: U1.5 (1B3), U4.14 (AD2)
AD3: U1.6 (1B4), U4.13 (AD3)
AD4: U1.8 (1B5), U4.12 (AD4)
AD5: U1.9 (1B6), U4.11 (AD5)
AD6: U1.11 (1B7), U4.10 (AD6)
AD7: U1.12 (1B8), U4.9 (AD7)
AD8: U1.13 (2B1), U4.8 (AD8)
AD9: U1.14 (2B2), U4.7 (AD9)
AD10: U1.16 (2B3), U4.6 (AD10)
AD11: U1.17 (2B4), U4.5 (AD11)
AD12: U1.19 (2B5), U4.4 (AD12)
AD13: U1.20 (2B6), U4.3 (AD13)
AD14: U1.22 (2B7), U4.2 (AD14)
AD15: U1.23 (2B8), U4.39 (AD15)
AD16: U2.2 (1B1), U4.38 (A16/S3)
AD17: U2.3 (1B2), U4.37 (A17/S4)
AD18: U2.5 (1B3), U4.36 (A18/S5)
AD19: U2.6 (1B4), U4.35 (A19/S6)
ALE: U2.12 (1B8), U4.25 (ALE)
ALE_3: U2.37 (1A8); also elsewhere on the board
CLK: U4.19 (CLK); also elsewhere on the board
DATA_DIR: U1.1 (1DIR), U1.24 (2DIR); also elsewhere on the board
DT_~R: U2.9 (1B6), U4.27 (DT/~R)
DT_~R~_3: U2.40 (1A6); also elsewhere on the board
GND: R6.2, R7.1, U1.4 (GND1), U1.10 (GND2), U1.15 (GND3), U1.21 (GND4), U1.25 (2~OE), U1.28 (GND8), U1.34 (GND7), U1.39 (GND6), U1.45 (GND5), U1.48 (1~OE), U2.1 (1DIR), U2.4 (GND1), U2.10 (GND2), U2.15 (GND3), U2.19 (2B5), U2.20 (2B6), U2.21 (GND4), U2.22 (2B7), U2.23 (2B8), U2.24 (2DIR), U2.25 (2~OE), U2.28 (GND8), U2.34 (GND7), U2.39 (GND6), U2.45 (GND5), U2.48 (1~OE), U4.1 (GND), U4.20 (GND), U4.23 (~TEST), U4.31 (HOLD); also elsewhere on the board
INT: U4.18 (INTR); also elsewhere on the board
LAD0: U1.47 (1A1); also elsewhere on the board
LAD1: U1.46 (1A2); also elsewhere on the board
LAD2: U1.44 (1A3); also elsewhere on the board
LAD3: U1.43 (1A4); also elsewhere on the board
LAD4: U1.41 (1A5); also elsewhere on the board
LAD5: U1.40 (1A6); also elsewhere on the board
LAD6: U1.38 (1A7); also elsewhere on the board
LAD7: U1.37 (1A8); also elsewhere on the board
LAD8: U1.36 (2A1); also elsewhere on the board
LAD9: U1.35 (2A2); also elsewhere on the board
LAD10: U1.33 (2A3); also elsewhere on the board
LAD11: U1.32 (2A4); also elsewhere on the board
LAD12: U1.30 (2A5); also elsewhere on the board
LAD13: U1.29 (2A6); also elsewhere on the board
LAD14: U1.27 (2A7); also elsewhere on the board
LAD15: U1.26 (2A8); also elsewhere on the board
LAD16: U2.47 (1A1); also elsewhere on the board
LAD17: U2.46 (1A2); also elsewhere on the board
LAD18: U2.44 (1A3); also elsewhere on the board
LAD19: U2.43 (1A4); also elsewhere on the board
M_~IO: U2.13 (2B1), U4.28 (M/~IO); also elsewhere on the board
M_~IO~_3: U2.36 (2A1); also elsewhere on the board
NMI: R6.1, U4.17 (NMI); also elsewhere on the board
RDY1: R8.2; also elsewhere on the board
RDY2: R7.2; also elsewhere on the board
READY: U4.22 (READY); also elsewhere on the board
RESET: U4.21 (RESET); also elsewhere on the board
VCC: U1.7 (VCCB1), U1.18 (VCCB2), U2.7 (VCCB1), U2.18 (VCCB2), U4.33 (MN/~MX), U4.40 (VCC); also elsewhere on the board
VCC36: R8.1, U1.31 (VCCA2), U1.42 (VCCA1), U2.31 (VCCA2), U2.42 (VCCA1); also elsewhere on the board
~BHE~_S7: U2.8 (1B5), U4.34 (~BHE/S7)
~BHE~_S7_3: U2.41 (1A5); also elsewhere on the board
~DEN: U2.11 (1B7), U4.26 (~DEN)
~DEN_3: U2.38 (1A7); also elsewhere on the board
~INTA: U2.17 (2B4), U4.24 (~INTA); also elsewhere on the board
~INTA_3: U2.32 (2A4); also elsewhere on the board
~RD: U2.16 (2B3), U4.32 (~RD); also elsewhere on the board
~RD_3: U2.33 (2A3); also elsewhere on the board
~WR: U2.14 (2B2), U4.29 (~WR); also elsewhere on the board
~WR_3: U2.35 (2A2); also elsewhere on the board

Notes on the sheet:
0 = output (B -> A) 1 = input (A -> B)


Parts:
U8, U9: 27C512; DIP-28_W15.24mm_Socket_LongPads

Connections:
A0: U8.22 (~OE); also elsewhere on the board
A1: U8.10 (A0), U9.10 (A0); also elsewhere on the board
A2: U8.9 (A1), U9.9 (A1); also elsewhere on the board
A3: U8.8 (A2), U9.8 (A2); also elsewhere on the board
A4: U8.7 (A3), U9.7 (A3); also elsewhere on the board
A5: U8.6 (A4), U9.6 (A4); also elsewhere on the board
A6: U8.5 (A5), U9.5 (A5); also elsewhere on the board
A7: U8.4 (A6), U9.4 (A6); also elsewhere on the board
A8: U8.3 (A7), U9.3 (A7); also elsewhere on the board
A9: U8.25 (A8), U9.25 (A8); also elsewhere on the board
A10: U8.24 (A9), U9.24 (A9); also elsewhere on the board
A11: U8.21 (A10), U9.21 (A10); also elsewhere on the board
A12: U8.23 (A11), U9.23 (A11); also elsewhere on the board
A13: U8.2 (A12), U9.2 (A12); also elsewhere on the board
A14: U8.26 (A13), U9.26 (A13); also elsewhere on the board
A15: U8.27 (A14), U9.27 (A14); also elsewhere on the board
A16: U8.1 (A15), U9.1 (A15); also elsewhere on the board
D0: U8.11 (D0); also elsewhere on the board
D1: U8.12 (D1); also elsewhere on the board
D2: U8.13 (D2); also elsewhere on the board
D3: U8.15 (D3); also elsewhere on the board
D4: U8.16 (D4); also elsewhere on the board
D5: U8.17 (D5); also elsewhere on the board
D6: U8.18 (D6); also elsewhere on the board
D7: U8.19 (D7); also elsewhere on the board
D8: U9.11 (D0); also elsewhere on the board
D9: U9.12 (D1); also elsewhere on the board
D10: U9.13 (D2); also elsewhere on the board
D11: U9.15 (D3); also elsewhere on the board
D12: U9.16 (D4); also elsewhere on the board
D13: U9.17 (D5); also elsewhere on the board
D14: U9.18 (D6); also elsewhere on the board
D15: U9.19 (D7); also elsewhere on the board
GND: U8.14 (GND), U9.14 (GND); also elsewhere on the board
VCC: U8.28 (VCC), U9.28 (VCC); also elsewhere on the board
~BHE: U9.22 (~OE); also elsewhere on the board
~ROMRD: U8.20 (~CE), U9.20 (~CE); also elsewhere on the board

Notes on the sheet:
odd ROM
even ROM

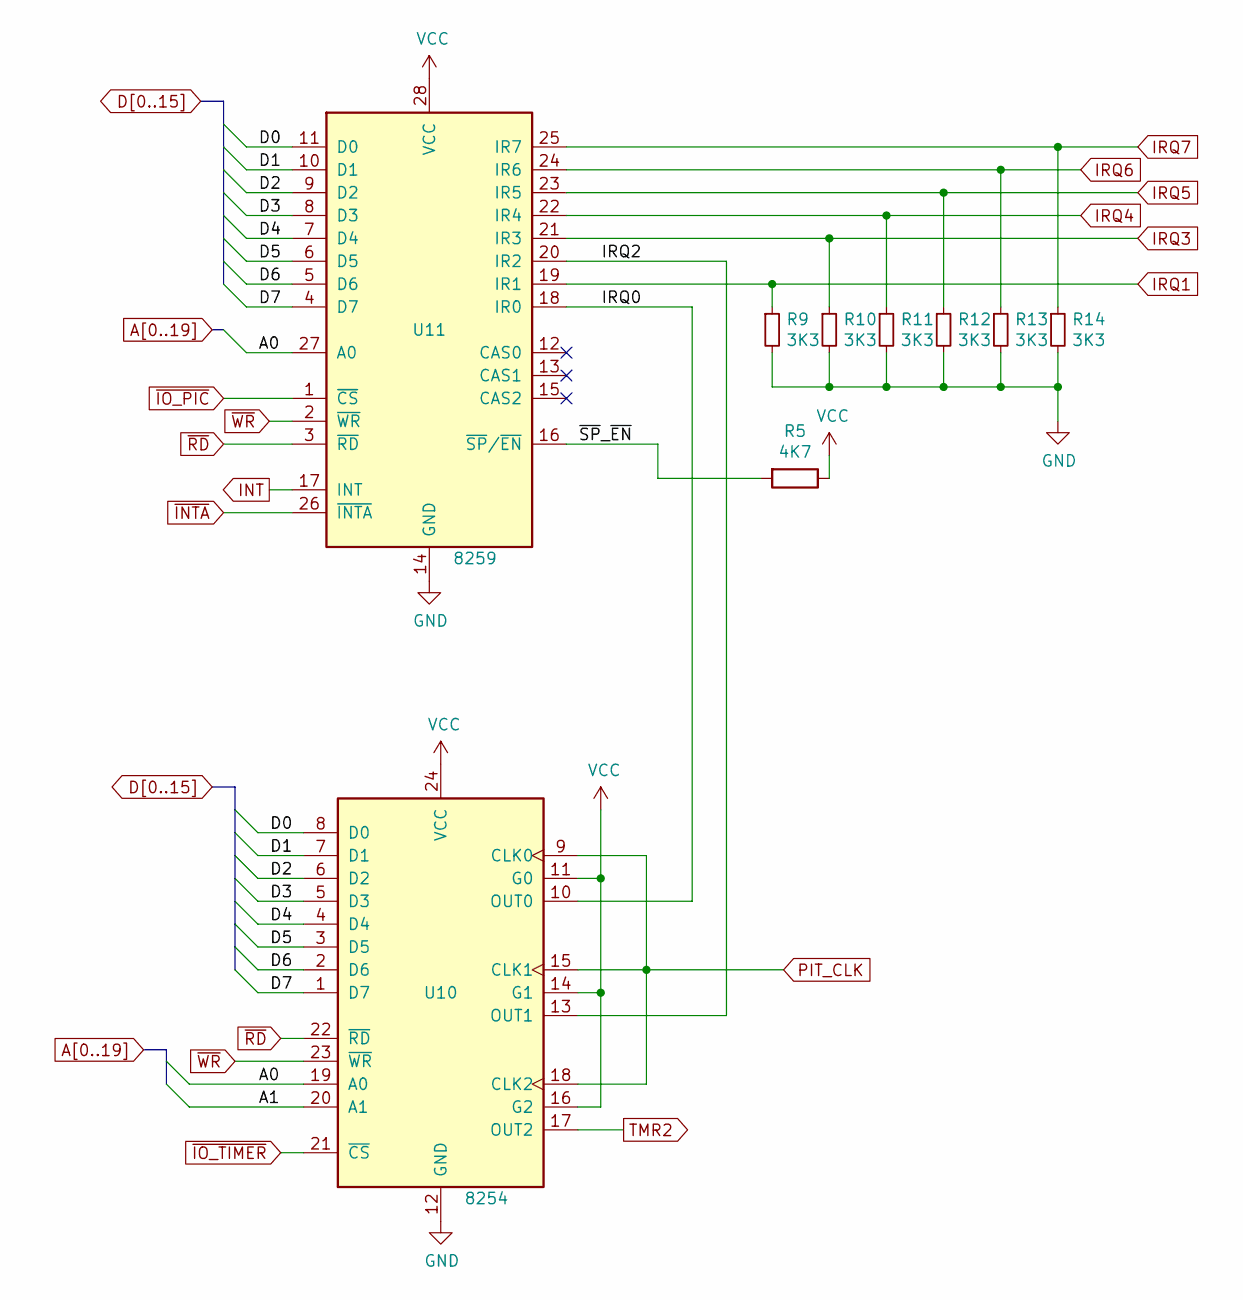
[picture p69: schematic pic_timer.kicad_sch, Mini8086 main system board]

Parts:
R5: 4K7; R_1206_3216Metric
R9, R10, R11, R12, R13, R14: 3K3; R_1206_3216Metric
U10: 8254; DIP-24_W15.24mm_Socket_LongPads
U11: 8259; DIP-28_W15.24mm_Socket_LongPads

Connections:
/PIC TIMER/IRQ0: U10.10 (OUT0), U11.18 (IR0)
/PIC TIMER/IRQ2: U10.13 (OUT1), U11.20 (IR2)
/PIC TIMER/~SP~_~EN: R5.2, U11.16 (~SP/~EN)
A0: U10.19 (A0), U11.27 (A0); also elsewhere on the board
A1: U10.20 (A1); also elsewhere on the board
D0: U10.8 (D0), U11.11 (D0); also elsewhere on the board
D1: U10.7 (D1), U11.10 (D1); also elsewhere on the board
D2: U10.6 (D2), U11.9 (D2); also elsewhere on the board
D3: U10.5 (D3), U11.8 (D3); also elsewhere on the board
D4: U10.4 (D4), U11.7 (D4); also elsewhere on the board
D5: U10.3 (D5), U11.6 (D5); also elsewhere on the board
D6: U10.2 (D6), U11.5 (D6); also elsewhere on the board
D7: U10.1 (D7), U11.4 (D7); also elsewhere on the board
GND: R9.2, R10.2, R11.2, R12.2, R13.2, R14.2, U10.12 (GND), U11.14 (GND); also elsewhere on the board
INT: U11.17 (INT); also elsewhere on the board
IRQ1: R9.1, U11.19 (IR1); also elsewhere on the board
IRQ3: R10.1, U11.21 (IR3); also elsewhere on the board
IRQ4: R11.1, U11.22 (IR4); also elsewhere on the board
IRQ5: R12.1, U11.23 (IR5); also elsewhere on the board
IRQ6: R13.1, U11.24 (IR6); also elsewhere on the board
IRQ7: R14.1, U11.25 (IR7); also elsewhere on the board
PIT_CLK: U10.9 (CLK0), U10.15 (CLK1), U10.18 (CLK2); also elsewhere on the board
TMR2: U10.17 (OUT2); also elsewhere on the board
VCC: R5.1, U10.11 (G0), U10.14 (G1), U10.16 (G2), U10.24 (VCC), U11.28 (VCC); also elsewhere on the board
~INTA: U11.26 (~INTA); also elsewhere on the board
~IO_PIC: U11.1 (~CS); also elsewhere on the board
~IO_TIMER: U10.21 (~CS); also elsewhere on the board
~RD: U10.22 (~RD), U11.3 (~RD); also elsewhere on the board
~WR: U10.23 (~WR), U11.2 (~WR); also elsewhere on the board
