svpetry/Mini8086/KiCad/main_v2/main.kicad_pcb

## KiCad design KiCad/main_v2/main.kicad_pcb (continued)

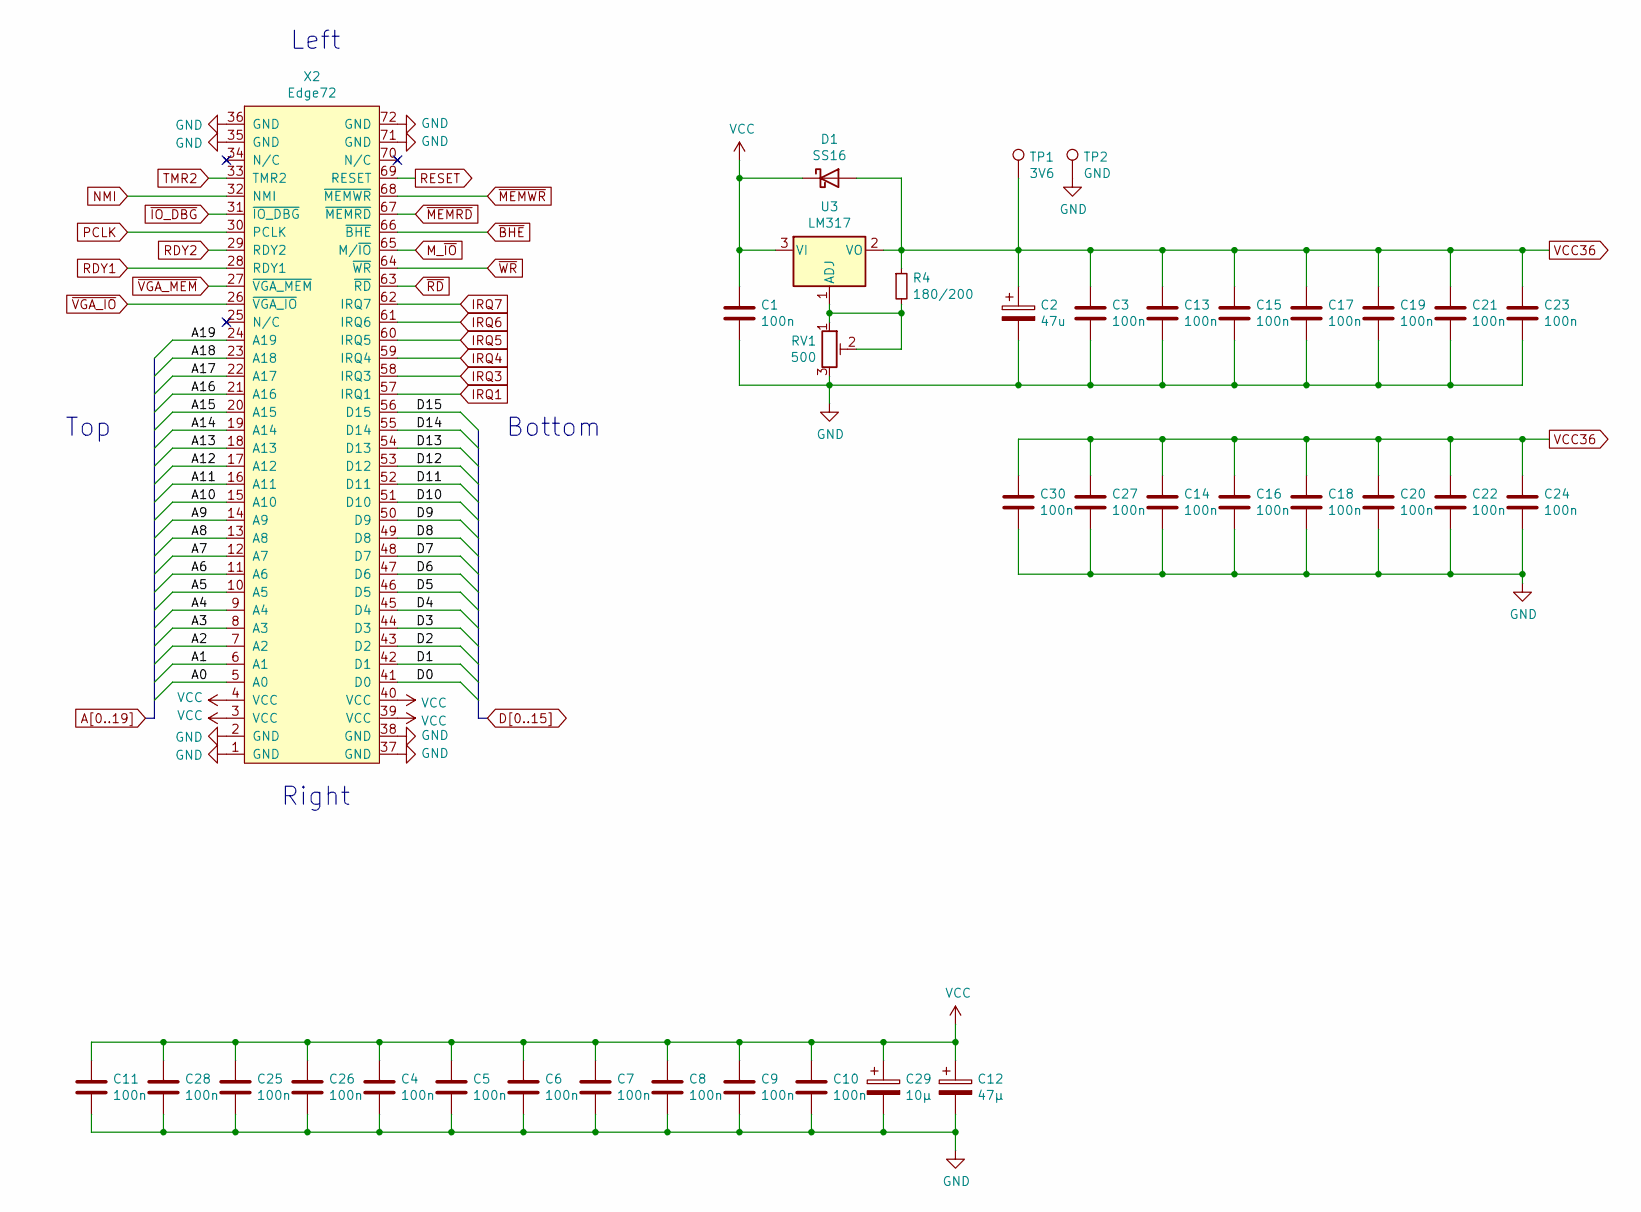
[picture p70: schematic connector.kicad_sch, Mini8086 main system board]

Parts:
C1, C3, C4, C5, C6, C7, C8, C9, C10, C11, C13, C14, C15, C16, C17, C18, C19, C20, C21, C22, C23, C24, C25, C26, C27, C28, C30: 100n; C_1206_3216Metric
C2: 47u; CP_Radial_D4.0mm_P2.00mm
C12: 47µ; CP_Radial_D4.0mm_P2.00mm
C29: 10µ; CP_Radial_D4.0mm_P2.00mm
D1: SS16; D_SMA
R4: 180/200; R_1206_3216Metric
RV1: 500; Potentiometer_Runtron_RM-065_Vertical
TP1: 3V6; TestPoint_Pad_D1.5mm
TP2: GND; TestPoint_Pad_D1.5mm
U3: LM317; TO-252-2
X2: Edge72; BUS_72

Connections:
A0: X2.5 (A0); also elsewhere on the board
A1: X2.6 (A1); also elsewhere on the board
A2: X2.7 (A2); also elsewhere on the board
A3: X2.8 (A3); also elsewhere on the board
A4: X2.9 (A4); also elsewhere on the board
A5: X2.10 (A5); also elsewhere on the board
A6: X2.11 (A6); also elsewhere on the board
A7: X2.12 (A7); also elsewhere on the board
A8: X2.13 (A8); also elsewhere on the board
A9: X2.14 (A9); also elsewhere on the board
A10: X2.15 (A10); also elsewhere on the board
A11: X2.16 (A11); also elsewhere on the board
A12: X2.17 (A12); also elsewhere on the board
A13: X2.18 (A13); also elsewhere on the board
A14: X2.19 (A14); also elsewhere on the board
A15: X2.20 (A15); also elsewhere on the board
A16: X2.21 (A16); also elsewhere on the board
A17: X2.22 (A17); also elsewhere on the board
A18: X2.23 (A18); also elsewhere on the board
A19: X2.24 (A19); also elsewhere on the board
D0: X2.41 (D0); also elsewhere on the board
D1: X2.42 (D1); also elsewhere on the board
D2: X2.43 (D2); also elsewhere on the board
D3: X2.44 (D3); also elsewhere on the board
D4: X2.45 (D4); also elsewhere on the board
D5: X2.46 (D5); also elsewhere on the board
D6: X2.47 (D6); also elsewhere on the board
D7: X2.48 (D7); also elsewhere on the board
D8: X2.49 (D8); also elsewhere on the board
D9: X2.50 (D9); also elsewhere on the board
D10: X2.51 (D10); also elsewhere on the board
D11: X2.52 (D11); also elsewhere on the board
D12: X2.53 (D12); also elsewhere on the board
D13: X2.54 (D13); also elsewhere on the board
D14: X2.55 (D14); also elsewhere on the board
D15: X2.56 (D15); also elsewhere on the board
GND: C1.2, C2.2, C3.2, C4.2, C5.2, C6.2, C7.2, C8.2, C9.2, C10.2, C11.2, C12.2, C13.2, C14.2, C15.2, C16.2, C17.2, C18.2, C19.2, C20.2, C21.2, C22.2, C23.2, C24.2, C25.2, C26.2, C27.2, C28.2, C29.2, C30.2, RV1.3, TP2.1, X2.1 (GND), X2.2 (GND), X2.35 (GND), X2.36 (GND), X2.37 (GND), X2.38 (GND), X2.71 (GND), X2.72 (GND); also elsewhere on the board
IRQ1: X2.57 (IRQ1); also elsewhere on the board
IRQ3: X2.58 (IRQ3); also elsewhere on the board
IRQ4: X2.59 (IRQ4); also elsewhere on the board
IRQ5: X2.60 (IRQ5); also elsewhere on the board
IRQ6: X2.61 (IRQ6); also elsewhere on the board
IRQ7: X2.62 (IRQ7); also elsewhere on the board
M_~IO: X2.65 (M/~IO); also elsewhere on the board
NMI: X2.32 (NMI); also elsewhere on the board
unnamed: R4.2, RV1.1, RV1.2, U3.1 (ADJ)
PCLK: X2.30 (PCLK); also elsewhere on the board
RDY1: X2.28 (RDY1); also elsewhere on the board
RDY2: X2.29 (RDY2); also elsewhere on the board
RESET: X2.69 (RESET); also elsewhere on the board
TMR2: X2.33 (TMR2); also elsewhere on the board
VCC: C1.1, C4.1, C5.1, C6.1, C7.1, C8.1, C9.1, C10.1, C11.1, C12.1, C25.1, C26.1, C28.1, C29.1, D1.1 (K), U3.3 (VI), X2.3 (VCC), X2.4 (VCC), X2.39 (VCC), X2.40 (VCC); also elsewhere on the board
VCC36: C2.1, C3.1, C13.1, C14.1, C15.1, C16.1, C17.1, C18.1, C19.1, C20.1, C21.1, C22.1, C23.1, C24.1, C27.1, C30.1, D1.2 (A), R4.1, TP1.1, U3.2 (VO); also elsewhere on the board
~BHE: X2.66 (~BHE); also elsewhere on the board
~IO_DBG: X2.31 (~IO_DBG); also elsewhere on the board
~MEMRD: X2.67 (~MEMRD); also elsewhere on the board
~MEMWR: X2.68 (~MEMWR); also elsewhere on the board
~RD: X2.63 (~RD); also elsewhere on the board
~VGA_IO: X2.26 (~VGA_IO); also elsewhere on the board
~VGA_MEM: X2.27 (~VGA_MEM); also elsewhere on the board
~WR: X2.64 (~WR); also elsewhere on the board

Notes on the sheet:
Top
Right
Left
Bottom

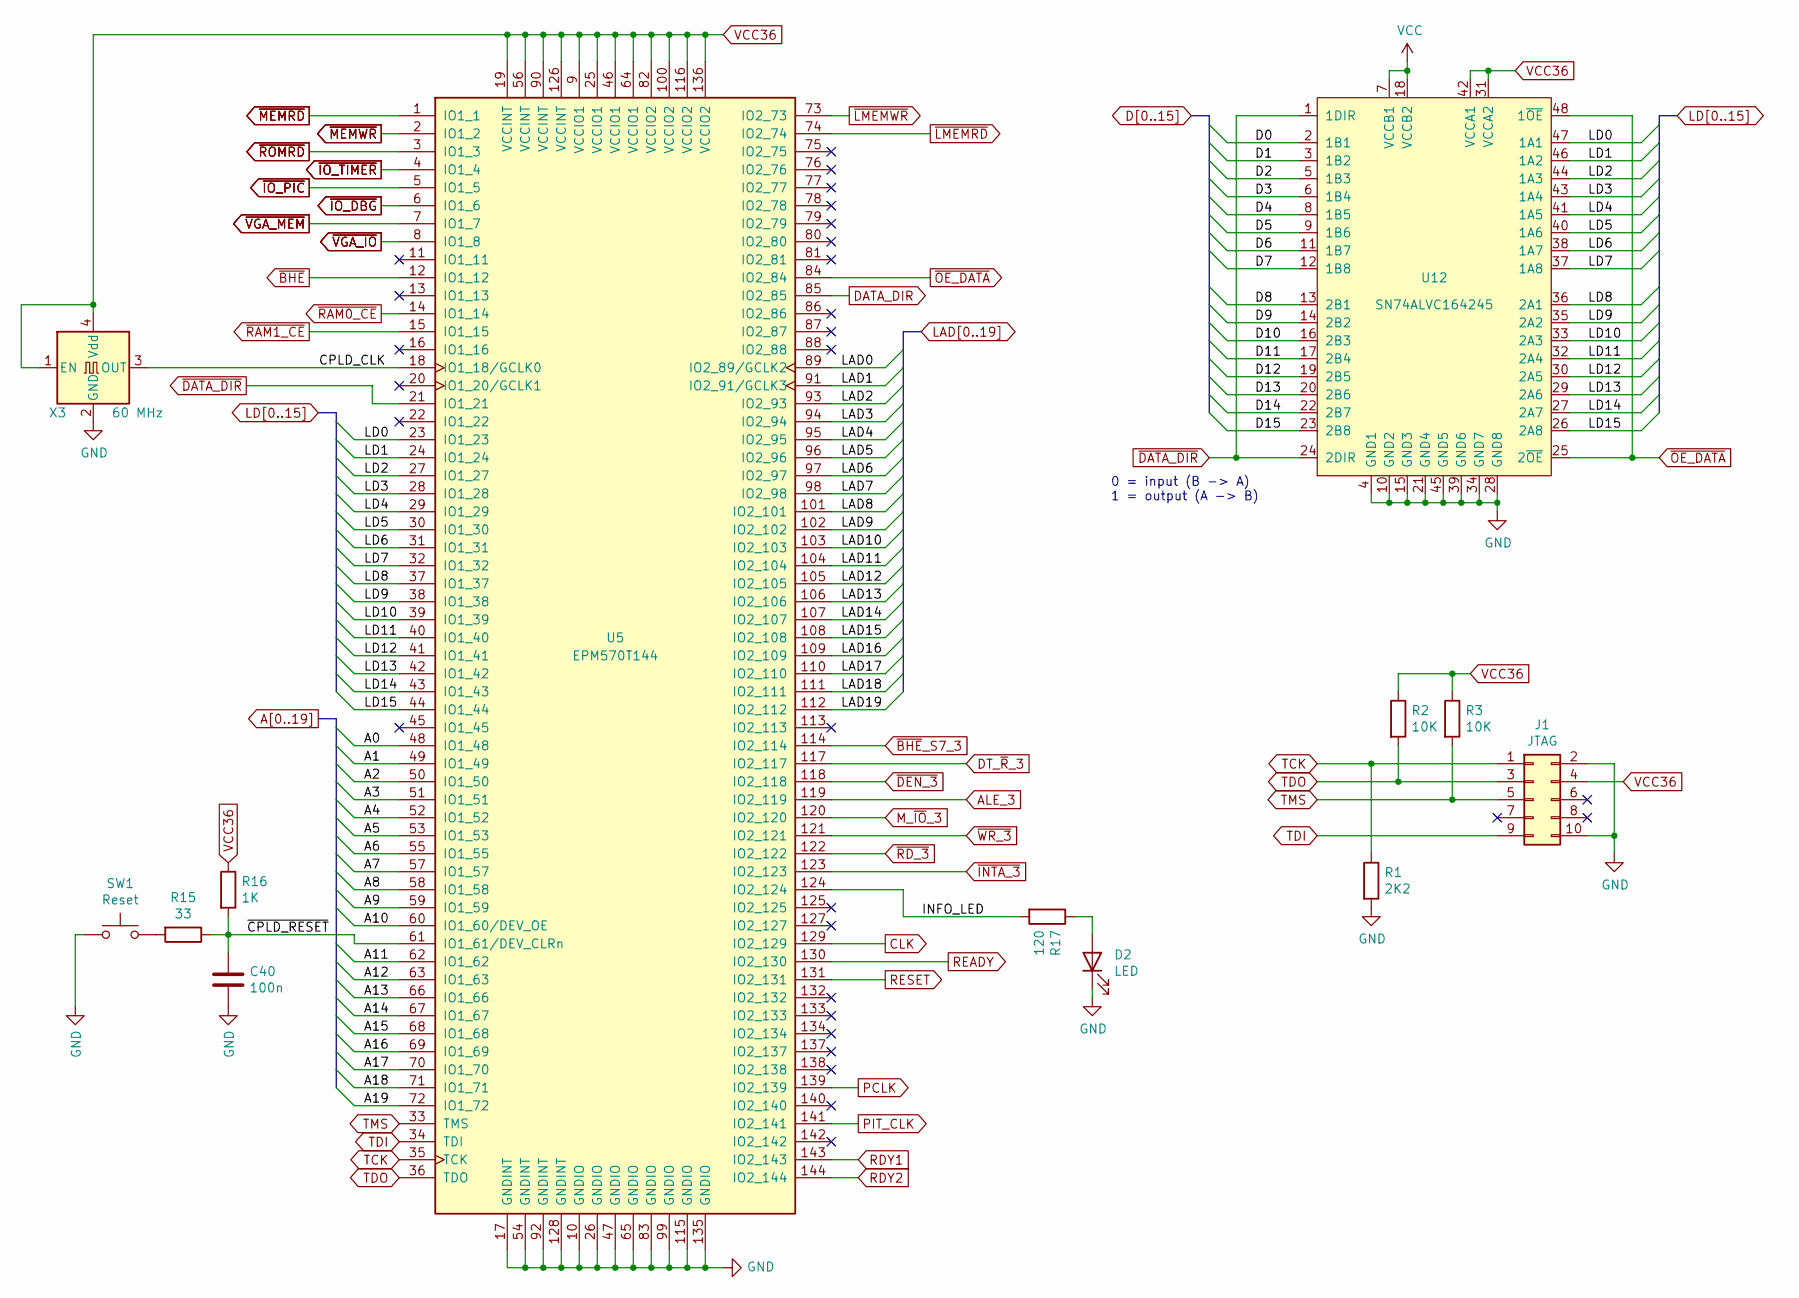
[picture p71: schematic CPLD.kicad_sch, Mini8086 main system board]

Parts:
C40: 100n; C_1206_3216Metric
D2: LED; LED_0805_2012Metric_Castellated
J1: JTAG; IDC-Header_2x05_P2.54mm_Vertical
R1: 2K2; R_1206_3216Metric
R2, R3: 10K; R_1206_3216Metric
R15: 33; R_1206_3216Metric
R16: 1K; R_1206_3216Metric
R17: 120; R_0805_2012Metric
SW1: Reset; SW_SPST_CK_RS282G05A3
U5: EPM570T144; LQFP-144_20x20mm_P0.5mm
U12: SN74ALVC164245; SSOP-48_7.5x15.9mm_P0.635mm
X3: 60 MHz; Oscillator_SMD_Abracon_ASV-4Pin_7.0x5.1mm

Connections:
/CPLD/CPLD_CLK: U5.18 (IO1_18/GCLK0), X3.3 (OUT)
/CPLD/INFO_LED: R17.2, U5.124 (IO2_124)
/CPLD/~CPLD_RESET: C40.1, R15.1, R16.2, U5.61 (IO1_61/DEV_CLRn)
A0: U5.48 (IO1_48); also elsewhere on the board
A1: U5.49 (IO1_49); also elsewhere on the board
A2: U5.50 (IO1_50); also elsewhere on the board
A3: U5.51 (IO1_51); also elsewhere on the board
A4: U5.52 (IO1_52); also elsewhere on the board
A5: U5.53 (IO1_53); also elsewhere on the board
A6: U5.55 (IO1_55); also elsewhere on the board
A7: U5.57 (IO1_57); also elsewhere on the board
A8: U5.58 (IO1_58); also elsewhere on the board
A9: U5.59 (IO1_59); also elsewhere on the board
A10: U5.60 (IO1_60/DEV_OE); also elsewhere on the board
A11: U5.62 (IO1_62); also elsewhere on the board
A12: U5.63 (IO1_63); also elsewhere on the board
A13: U5.66 (IO1_66); also elsewhere on the board
A14: U5.67 (IO1_67); also elsewhere on the board
A15: U5.68 (IO1_68); also elsewhere on the board
A16: U5.69 (IO1_69); also elsewhere on the board
A17: U5.70 (IO1_70); also elsewhere on the board
A18: U5.71 (IO1_71); also elsewhere on the board
A19: U5.72 (IO1_72); also elsewhere on the board
ALE_3: U5.119 (IO2_119); also elsewhere on the board
CLK: U5.129 (IO2_129); also elsewhere on the board
D0: U12.2 (1B1); also elsewhere on the board
D1: U12.3 (1B2); also elsewhere on the board
D2: U12.5 (1B3); also elsewhere on the board
D3: U12.6 (1B4); also elsewhere on the board
D4: U12.8 (1B5); also elsewhere on the board
D5: U12.9 (1B6); also elsewhere on the board
D6: U12.11 (1B7); also elsewhere on the board
D7: U12.12 (1B8); also elsewhere on the board
D8: U12.13 (2B1); also elsewhere on the board
D9: U12.14 (2B2); also elsewhere on the board
D10: U12.16 (2B3); also elsewhere on the board
D11: U12.17 (2B4); also elsewhere on the board
D12: U12.19 (2B5); also elsewhere on the board
D13: U12.20 (2B6); also elsewhere on the board
D14: U12.22 (2B7); also elsewhere on the board
D15: U12.23 (2B8); also elsewhere on the board
DATA_DIR: U5.85 (IO2_85); also elsewhere on the board
DT_~R~_3: U5.117 (IO2_117); also elsewhere on the board
GND: C40.2, D2.1 (K), J1.2, J1.10, R1.2, SW1.1, U5.10 (GNDIO), U5.17 (GNDINT), U5.26 (GNDIO), U5.47 (GNDIO), U5.54 (GNDINT), U5.65 (GNDIO), U5.83 (GNDIO), U5.92 (GNDINT), U5.99 (GNDIO), U5.115 (GNDIO), U5.128 (GNDINT), U5.135 (GNDIO), U12.4 (GND1), U12.10 (GND2), U12.15 (GND3), U12.21 (GND4), U12.28 (GND8), U12.34 (GND7), U12.39 (GND6), U12.45 (GND5), X3.2 (GND); also elsewhere on the board
LAD0: U5.89 (IO2_89/GCLK2); also elsewhere on the board
LAD1: U5.91 (IO2_91/GCLK3); also elsewhere on the board
LAD2: U5.93 (IO2_93); also elsewhere on the board
LAD3: U5.94 (IO2_94); also elsewhere on the board
LAD4: U5.95 (IO2_95); also elsewhere on the board
LAD5: U5.96 (IO2_96); also elsewhere on the board
LAD6: U5.97 (IO2_97); also elsewhere on the board
LAD7: U5.98 (IO2_98); also elsewhere on the board
LAD8: U5.101 (IO2_101); also elsewhere on the board
LAD9: U5.102 (IO2_102); also elsewhere on the board
LAD10: U5.103 (IO2_103); also elsewhere on the board
LAD11: U5.104 (IO2_104); also elsewhere on the board
LAD12: U5.105 (IO2_105); also elsewhere on the board
LAD13: U5.106 (IO2_106); also elsewhere on the board
LAD14: U5.107 (IO2_107); also elsewhere on the board
LAD15: U5.108 (IO2_108); also elsewhere on the board
LAD16: U5.109 (IO2_109); also elsewhere on the board
LAD17: U5.110 (IO2_110); also elsewhere on the board
LAD18: U5.111 (IO2_111); also elsewhere on the board
LAD19: U5.112 (IO2_112); also elsewhere on the board
LD0: U5.23 (IO1_23), U12.47 (1A1); also elsewhere on the board
LD1: U5.24 (IO1_24), U12.46 (1A2); also elsewhere on the board
LD2: U5.27 (IO1_27), U12.44 (1A3); also elsewhere on the board
LD3: U5.28 (IO1_28), U12.43 (1A4); also elsewhere on the board
LD4: U5.29 (IO1_29), U12.41 (1A5); also elsewhere on the board
LD5: U5.30 (IO1_30), U12.40 (1A6); also elsewhere on the board
LD6: U5.31 (IO1_31), U12.38 (1A7); also elsewhere on the board
LD7: U5.32 (IO1_32), U12.37 (1A8); also elsewhere on the board
LD8: U5.37 (IO1_37), U12.36 (2A1); also elsewhere on the board
LD9: U5.38 (IO1_38), U12.35 (2A2); also elsewhere on the board
LD10: U5.39 (IO1_39), U12.33 (2A3); also elsewhere on the board
LD11: U5.40 (IO1_40), U12.32 (2A4); also elsewhere on the board
LD12: U5.41 (IO1_41), U12.30 (2A5); also elsewhere on the board
LD13: U5.42 (IO1_42), U12.29 (2A6); also elsewhere on the board
LD14: U5.43 (IO1_43), U12.27 (2A7); also elsewhere on the board
LD15: U5.44 (IO1_44), U12.26 (2A8); also elsewhere on the board
M_~IO~_3: U5.120 (IO2_120); also elsewhere on the board
unnamed: D2.2 (A), R17.1
unnamed: R15.2, SW1.2
PCLK: U5.139 (IO2_139); also elsewhere on the board
PIT_CLK: U5.141 (IO2_141); also elsewhere on the board
RDY1: U5.143 (IO2_143); also elsewhere on the board
RDY2: U5.144 (IO2_144); also elsewhere on the board
READY: U5.130 (IO2_130); also elsewhere on the board
RESET: U5.131 (IO2_131); also elsewhere on the board
TCK: J1.1, R1.1, U5.35 (TCK)
TDI: J1.9, U5.34 (TDI)
TDO: J1.3, R2.2, U5.36 (TDO)
TMS: J1.5, R3.2, U5.33 (TMS)
VCC: U12.7 (VCCB1), U12.18 (VCCB2); also elsewhere on the board
VCC36: J1.4, R2.1, R3.1, R16.1, U5.9 (VCCIO1), U5.19 (VCCINT), U5.25 (VCCIO1), U5.46 (VCCIO1), U5.56 (VCCINT), U5.64 (VCCIO1), U5.82 (VCCIO2), U5.90 (VCCINT), U5.100 (VCCIO2), U5.116 (VCCIO2), U5.126 (VCCINT), U5.136 (VCCIO2), U12.31 (VCCA2), U12.42 (VCCA1), X3.1 (EN), X3.4 (Vdd); also elsewhere on the board
~BHE: U5.12 (IO1_12); also elsewhere on the board
~BHE~_S7_3: U5.114 (IO2_114); also elsewhere on the board
~DATA_DIR: U5.21 (IO1_21), U12.1 (1DIR), U12.24 (2DIR)
~DEN_3: U5.118 (IO2_118); also elsewhere on the board
~INTA_3: U5.123 (IO2_123); also elsewhere on the board
~IO_DBG: U5.6 (IO1_6); also elsewhere on the board
~IO_PIC: U5.5 (IO1_5); also elsewhere on the board
~IO_TIMER: U5.4 (IO1_4); also elsewhere on the board
~LMEMRD: U5.74 (IO2_74); also elsewhere on the board
~LMEMWR: U5.73 (IO2_73); also elsewhere on the board
~MEMRD: U5.1 (IO1_1); also elsewhere on the board
~MEMWR: U5.2 (IO1_2); also elsewhere on the board
~OE_DATA: U5.84 (IO2_84), U12.25 (2~OE), U12.48 (1~OE)
~RAM0_CE: U5.14 (IO1_14); also elsewhere on the board
~RAM1_CE: U5.15 (IO1_15); also elsewhere on the board
~RD_3: U5.122 (IO2_122); also elsewhere on the board
~ROMRD: U5.3 (IO1_3); also elsewhere on the board
~VGA_IO: U5.8 (IO1_8); also elsewhere on the board
~VGA_MEM: U5.7 (IO1_7); also elsewhere on the board
~WR_3: U5.121 (IO2_121); also elsewhere on the board

Notes on the sheet:
0 = input (B -> A) 1 = output (A -> B)

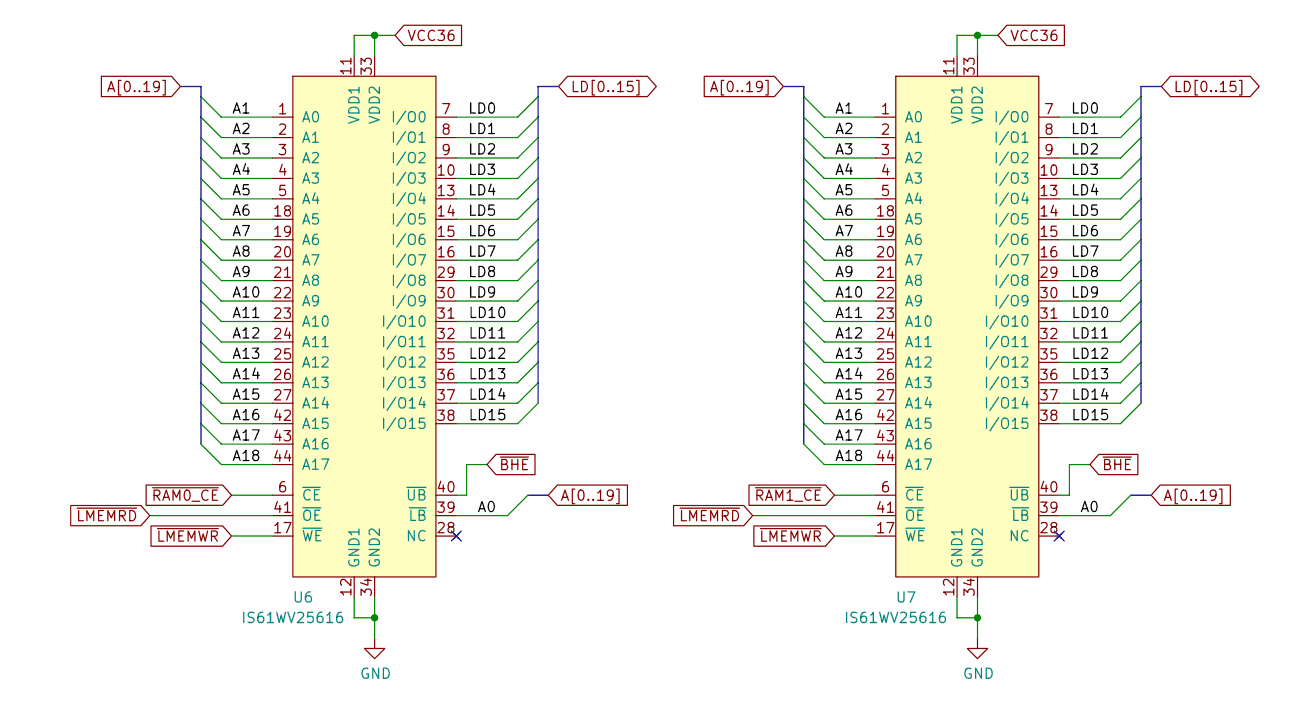
[picture p72: schematic RAM.kicad_sch, Mini8086 main system board]

Parts:
U6, U7: IS61WV25616; TSOP-II-44_10.16x18.41mm_P0.8mm

Connections:
A0: U6.39 (~LB), U7.39 (~LB); also elsewhere on the board
A1: U6.1 (A0), U7.1 (A0); also elsewhere on the board
A2: U6.2 (A1), U7.2 (A1); also elsewhere on the board
A3: U6.3 (A2), U7.3 (A2); also elsewhere on the board
A4: U6.4 (A3), U7.4 (A3); also elsewhere on the board
A5: U6.5 (A4), U7.5 (A4); also elsewhere on the board
A6: U6.18 (A5), U7.18 (A5); also elsewhere on the board
A7: U6.19 (A6), U7.19 (A6); also elsewhere on the board
A8: U6.20 (A7), U7.20 (A7); also elsewhere on the board
A9: U6.21 (A8), U7.21 (A8); also elsewhere on the board
A10: U6.22 (A9), U7.22 (A9); also elsewhere on the board
A11: U6.23 (A10), U7.23 (A10); also elsewhere on the board
A12: U6.24 (A11), U7.24 (A11); also elsewhere on the board
A13: U6.25 (A12), U7.25 (A12); also elsewhere on the board
A14: U6.26 (A13), U7.26 (A13); also elsewhere on the board
A15: U6.27 (A14), U7.27 (A14); also elsewhere on the board
A16: U6.42 (A15), U7.42 (A15); also elsewhere on the board
A17: U6.43 (A16), U7.43 (A16); also elsewhere on the board
A18: U6.44 (A17), U7.44 (A17); also elsewhere on the board
GND: U6.12 (GND1), U6.34 (GND2), U7.12 (GND1), U7.34 (GND2); also elsewhere on the board
LD0: U6.7 (I/O0), U7.7 (I/O0); also elsewhere on the board
LD1: U6.8 (I/O1), U7.8 (I/O1); also elsewhere on the board
LD2: U6.9 (I/O2), U7.9 (I/O2); also elsewhere on the board
LD3: U6.10 (I/O3), U7.10 (I/O3); also elsewhere on the board
LD4: U6.13 (I/O4), U7.13 (I/O4); also elsewhere on the board
LD5: U6.14 (I/O5), U7.14 (I/O5); also elsewhere on the board
LD6: U6.15 (I/O6), U7.15 (I/O6); also elsewhere on the board
LD7: U6.16 (I/O7), U7.16 (I/O7); also elsewhere on the board
LD8: U6.29 (I/O8), U7.29 (I/O8); also elsewhere on the board
LD9: U6.30 (I/O9), U7.30 (I/O9); also elsewhere on the board
LD10: U6.31 (I/O10), U7.31 (I/O10); also elsewhere on the board
LD11: U6.32 (I/O11), U7.32 (I/O11); also elsewhere on the board
LD12: U6.35 (I/O12), U7.35 (I/O12); also elsewhere on the board
LD13: U6.36 (I/O13), U7.36 (I/O13); also elsewhere on the board
LD14: U6.37 (I/O14), U7.37 (I/O14); also elsewhere on the board
LD15: U6.38 (I/O15), U7.38 (I/O15); also elsewhere on the board
VCC36: U6.11 (VDD1), U6.33 (VDD2), U7.11 (VDD1), U7.33 (VDD2); also elsewhere on the board
~BHE: U6.40 (~UB), U7.40 (~UB); also elsewhere on the board
~LMEMRD: U6.41 (~OE), U7.41 (~OE); also elsewhere on the board
~LMEMWR: U6.17 (~WE), U7.17 (~WE); also elsewhere on the board
~RAM0_CE: U6.6 (~CE); also elsewhere on the board
~RAM1_CE: U7.6 (~CE); also elsewhere on the board

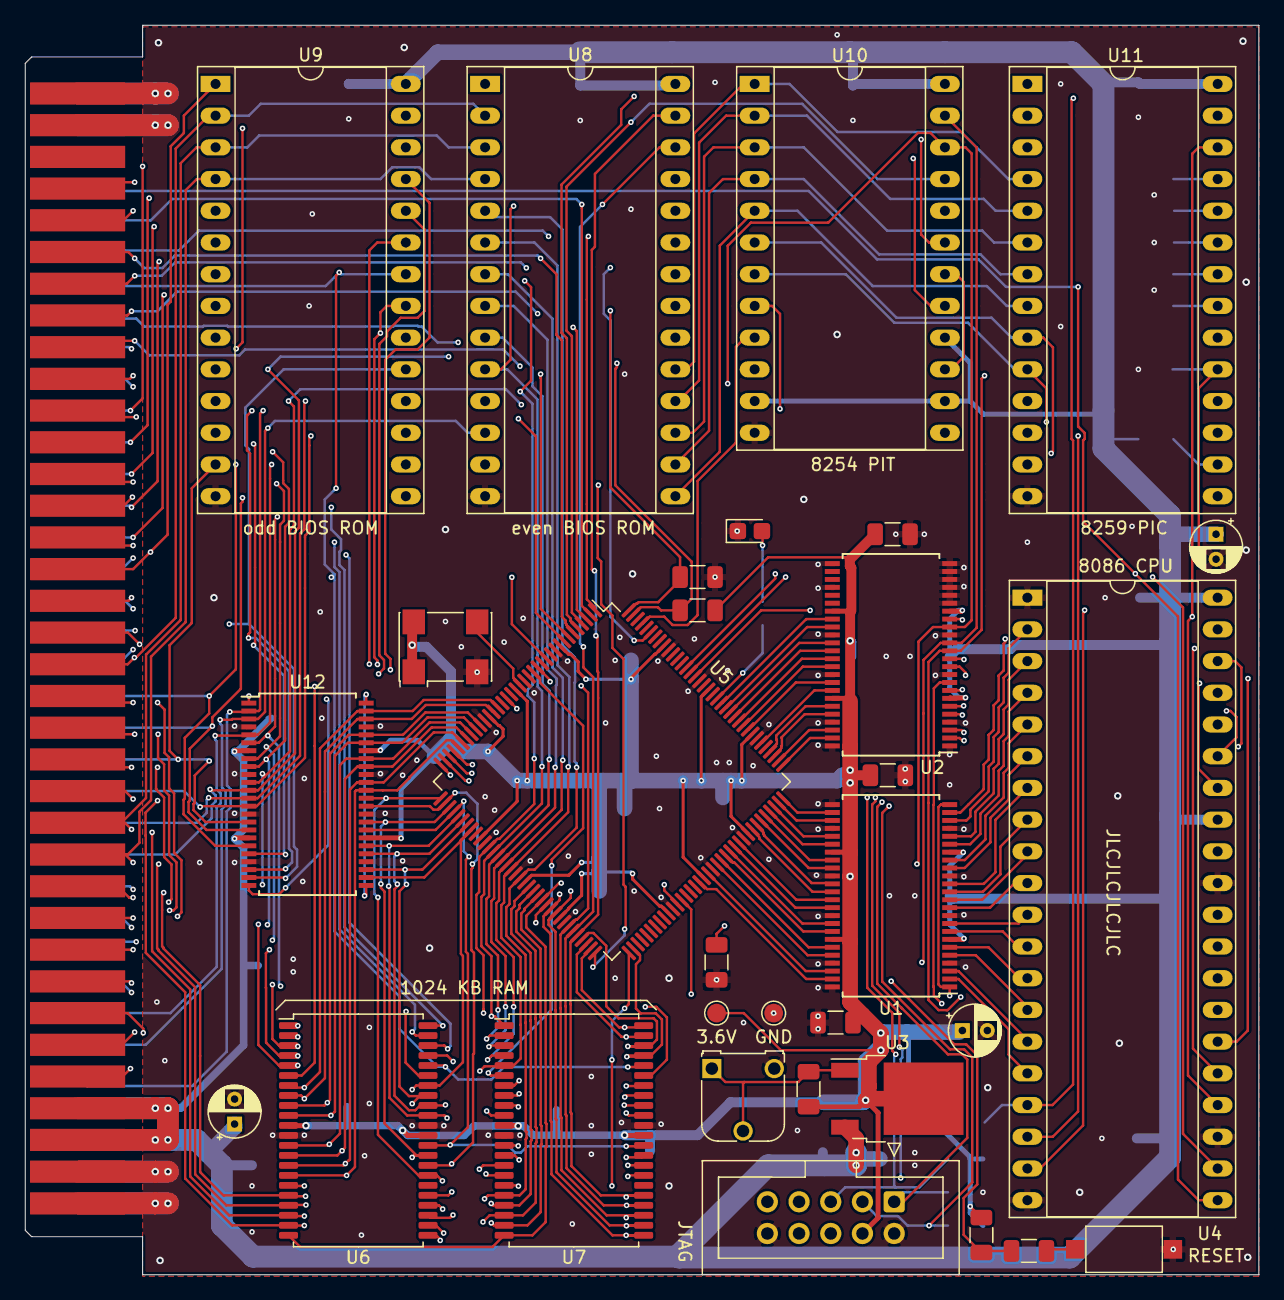
[picture p73: board KiCad/main_v2/main.kicad_pcb from above]

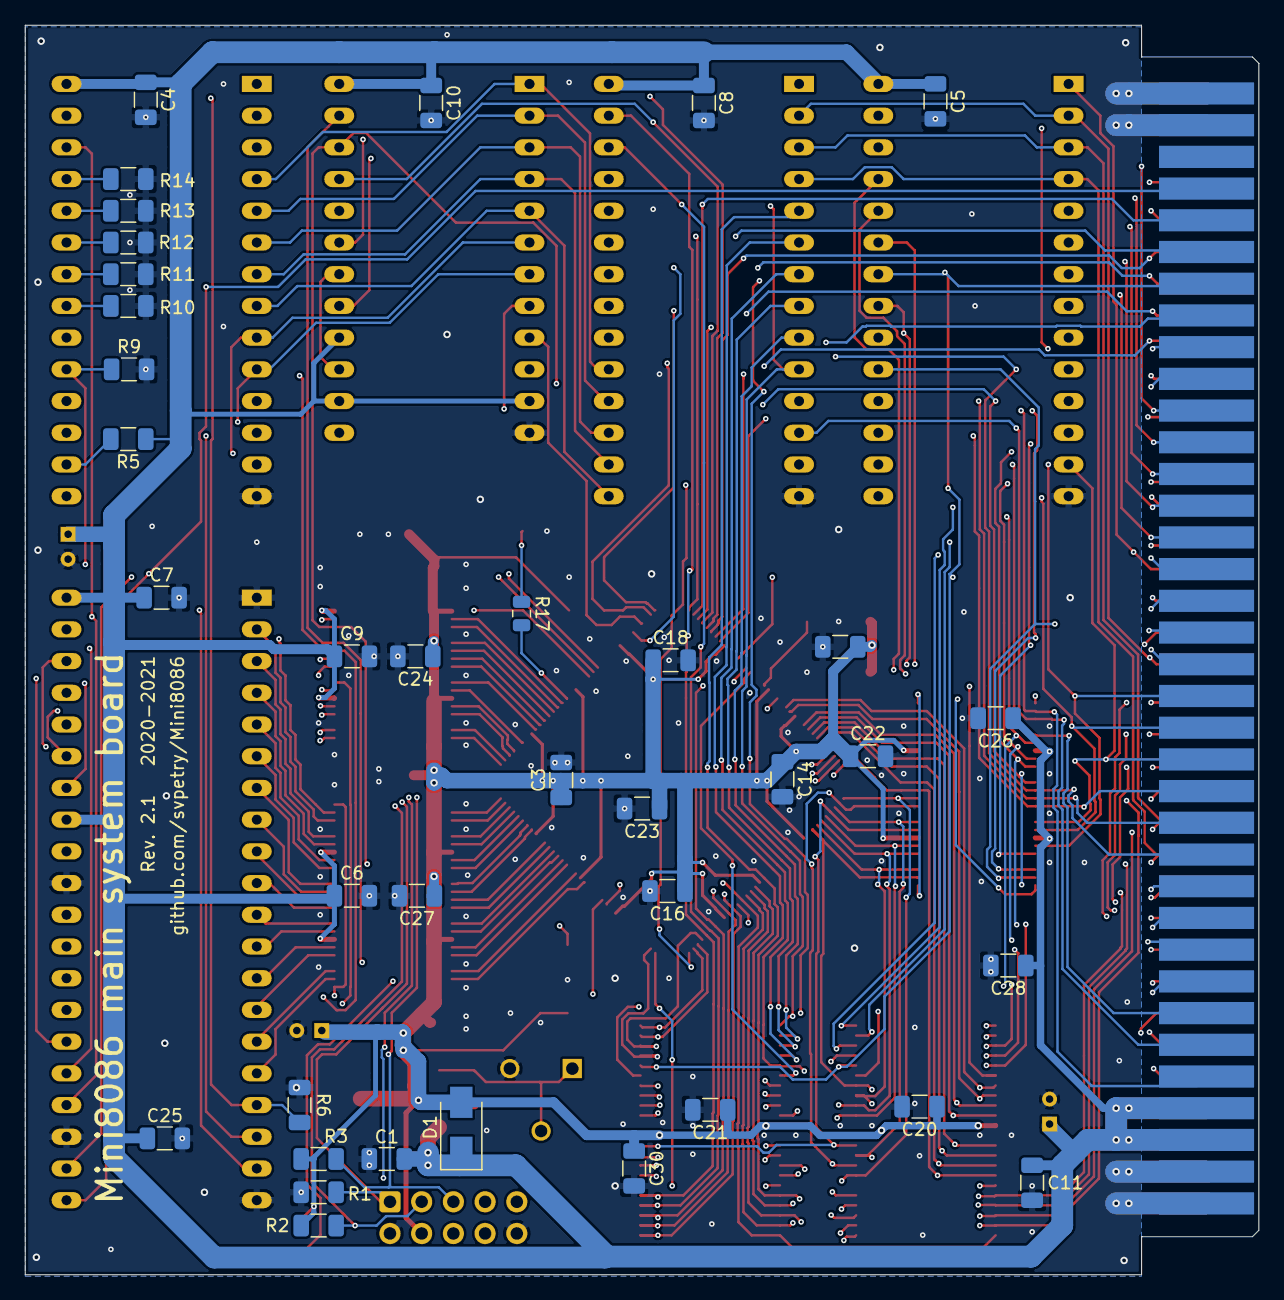
[picture p74: board KiCad/main_v2/main.kicad_pcb from below]

Board: 4 copper layers, 98.8 x 100.1 mm, 69 parts (37 on the bottom side), 156 nets.
