svpetry/Mini8086/Apps/BIOS/src/start.c

#include "start.h"
#include "../../Lib/screen.h"
#include "../../Lib/lcd.h"
#include "../../Lib/strutils.h"
#include "../../Lib/types.h"
#include "../../Lib/lowlevel.h"
#include "../../Lib/i2c.h"
#include "../../Lib/eeprom.h"
#include "../../Lib/bmp280.h"
#include "../../Lib/ds1307.h"
#include "defs.h"
#include "build.h"
#include "sd.h"

#define RESULT_COL 20

extern volatile byte ticks;

byte cfg_sddrive;
byte cfg_rs232;
byte cfg_i2c;
byte cfg_eeprom;
byte cfg_bmp280;
byte cfg_rtc;
int cfg_mem_kb;

char freq_str[5];
volatile byte __far (*memptr);
 
static void error() {
    puts(" ERROR!");
    while (1) ;
}

static void check_cpu(int row) {
    setcursor(4, row);
    puts("CPU");

    setcursor(RESULT_COL, row);
    puts("--.- MHz");
    puts(", Intel 8086 or compatible");
}

static void check_memory(int row) {
    unsigned long count;
    char s[12];

    setcursor(4, row);
    puts("RAM");

    // test first 64 KB
    setcursor(RESULT_COL, row);
    puts("64 KB");
    memptr = (unsigned char __far *)0x00005000;
    count = 0;
    while (count < 0xB000) {
        *memptr = 0xAA;
        if (*memptr != 0xAA) error();
        *memptr = 0x55;
        if (*memptr != 0x55) error();
        if (count < 0x400) {
            memptr++;
            count++;
        } else {
            memptr += 0x10;
            count += 0x10;
        }
    }

    // test rest of memory
    unsigned long memstart = 0x10000000;
    while (memstart < 0xC0000000) {
        memptr = (byte __far *)memstart;

        // check if memory block present
        *memptr = 0x0F;
        if (*memptr != 0x0F) break;

        setcursor(RESULT_COL, row);
        cfg_mem_kb = ((memstart >> 28) + 1) * 64;
        itoa(cfg_mem_kb, s);
        puts(s);
        puts(" KB");

        count = 0;
        while (count < 0x10000) {
            *memptr = 0xAA;
            if (*memptr != 0xAA) error();
            *memptr = 0x55;
            if (*memptr != 0x55) error();
            if (count < 0x400) {
                memptr++;
                count++;
            } else {
                memptr += 0x10;
                count += 0x10;
            }
        }

        memstart += 0x10000000;
    }

    puts(" OK");
}

static void check_timer(int row) {
    setcursor(4, row);
    puts("Timer");

    int i;
    word count = 20000;
    byte t = ticks;
    while (t == ticks && count > 0) {
        for (i = 0; i < 10; i++) {
            asm volatile("nop");
        }
        count--;
    }
    if (count == 0) {
        error();
        return;
    }

    // measure CPU frequency
    count = 0;
    for (i = 0; i < 4; i++) {
        t = ticks;
        while (t == ticks)
            count++;
    }
    
    // count /= 320; // -Os
    count /= 584; // -O2
    i = count / 100;
    if (i == 0)
        freq_str[0] = ' ';
    else
        freq_str[0] = '0' + i;
    count -= i * 100;
    i = count / 10;
    freq_str[1] = '0' + i;
    freq_str[2] = '.';
    count -= i * 10;
    freq_str[3] = '0' + count;
    freq_str[4] = 0;

    setcursor(RESULT_COL, 2);
    puts(freq_str);
  
    setcursor(RESULT_COL, row);
    puts("OK");
}

static void kb_delay_short() {
    int i;
    for (i = 0; i < 4000; i++) asm volatile("nop");
}

static void check_keyboard(int row) {
    int i, j;
    byte data, status;

    setcursor(4, row);
    puts("Keyboard");
    setcursor(RESULT_COL, row);

    // flush output buffer
    while ((inp(0x64) & 1) > 0)
        data = inp(0x60);

    // test controller
    outp(0x64, 0xAA);
    data = 0;
    for (j = 0; j < 20 && data != 0x55; j++) {
        kb_delay_short();
        data = inp(0x60);
    }
    if (data != 0x55) {
        puts("N/A");
        return;
    }

    // test PS/2 port
    outp(0x64, 0xAB); // perform controller self test
    status = 0;
    for (j = 0; j < 20 && (status & 1) == 0; j++) {
        kb_delay_short();
        status = inp(0x64);
    }
    data = inp(0x60);
    switch (data) {
        case 0x00:
            outp(0x64, 0x60); // write controller configuration byte
            while ((inp(0x64) & 0b00000010) > 1) kb_delay_short(); // wait for empty input buffer

            outp(0x60, 0b00000001); // enable first PS/2 port interrupt
            while ((inp(0x64) & 0b00000010) > 1) kb_delay_short(); // wait for empty input buffer

            outp(0x64, 0xAE); // enable keyboard interface
            puts("OK");
            return;
        case 0x01:
            puts("ERROR: clock line is stuck low");
            return;
        case 0x02:
            puts("ERROR: clock line is stuck high");
            return;
        case 0x03:
            puts("ERROR: data line is stuck low");
            return;
        case 0x04:
            puts("ERROR: data line is stuck high");
            return;
    }
}

static void check_serial(int row) {
    setcursor(4, row);
    puts("Serial ports");
    setcursor(RESULT_COL, row);

    puts("N/A");
}

static void check_sd_drive(int row) {
    setcursor(4, row);
    puts("SD drive");
    setcursor(RESULT_COL, row);

    if (sd_reset()) {
        puts("OK");
        cfg_sddrive = 1;        
    } else {
        puts("N/A");
        cfg_sddrive = 0;
    }
}

static void check_sound(int row) {
    setcursor(4, row);
    puts("Sound");
    setcursor(RESULT_COL, row);

    puts("N/A");
}

static void check_i2c(int row) {
    setcursor(4, row);
    puts("I2C controller");
    setcursor(RESULT_COL, row);

    if (!i2c_init(I2CF_88)) {
        puts("OK");
        cfg_i2c = 1;        
    } else {
        puts("N/A");
        cfg_i2c = 0;
    }
}

static void check_rtc(int row) {
    setcursor(5, row);
    putchar(28);
    puts(" RTC");
    setcursor(RESULT_COL, row);

    if (cfg_i2c && !ds1307_init()) {
        puts("OK");
        cfg_rtc = 1;        
    } else {
        puts("N/A");
        cfg_rtc = 0;
    }
}

static void check_eeprom(int row) {
    setcursor(5, row);
    putchar(28);
    puts(" EEPROM");
    setcursor(RESULT_COL, row);

    byte data;
    if (cfg_i2c && !eeprom_read_buf(0x00, &data, 1)) {
        puts("OK");
        cfg_eeprom = 1;        
    } else {
        puts("N/A");
        cfg_eeprom = 0;
    }
}

static void check_bmp280(int row) {
    setcursor(5, row);
    putchar(28);
    puts(" Sensor");
    setcursor(RESULT_COL, row);

    if (cfg_i2c && !bmp280_init()) {
        puts("OK");
        cfg_bmp280 = 1;        
    } else {
        puts("N/A");
        cfg_bmp280 = 0;
    }
}

void startup() {
    int i;
    for (i = 0; i < 80; i++) {
        setchar(i, 0, ' ' + 128);
        setchar(i, 24, ' ' + 128);
    }
    setcursor(1, 0);
    puts_inv("Mini8086 BIOS 0.1");
    setcursor(64, 0);
    puts_inv(BUILD);

    i = 2;
    check_cpu(i++);
    check_memory(i++);
    check_timer(i++);
    check_keyboard(i++);
    check_serial(i++);
    check_sd_drive(i++);
    check_sound(i++);
    check_i2c(i++);
    check_rtc(i++);
    check_eeprom(i++);
    check_bmp280(i++);

#if LCD == 1602
    lcd_puts(0, 0, "Mini8086     0.1");
#endif
#if LCD == 2004
    lcd_puts(0, 0, "Mini8086 BIOS    0.1");
#endif
#if LCD != 0
    char s[6];
    lcd_puts(0, 1, freq_str);
    lcd_puts(5, 1, "MHz");
    itoa(cfg_mem_kb, s);
    lcd_puts(10, 1, s);
    lcd_puts(14, 1, "KB");
#endif
}
