svpetry/Mini8086/Apps/BIOS/src/bios_setup.c

#include "bios_setup.h"
#include "../../Lib/types.h"
#include "../../Lib/keys.h"
#include "../../Lib/screen.h"
#include "keyboard.h"
#include "bios.h"
#include "../../Lib/strutils.h"
#include "../../Lib/ds1307.h"
#include "../../Lib/lowlevel.h"
#include "start.h"

#define BS_COLUMN 20
#define BS_ROW 6
#define BS_COLUMN2 42

static void waitforchar(byte time50ms) {
    byte t = ticks;
    while (ticks == t && !haschar()) asm volatile("nop");
    while (time50ms > 0 && !haschar()) {
        t = ticks;
        while (ticks == t && !(haschar())) asm volatile("nop");
        time50ms--;
    }
}

static void putnum_2(int num) {
    if (num < 10)
        putchar('0');
    else
        putchar('0' + num / 10);
    putchar('0' + num % 10);    
}

static void update_values() {
    // time
    setcursor(BS_COLUMN2, BS_ROW);
    putnum_2(t_hours);
    putchar(':');
    putnum_2(t_minutes);
    putchar(':');
    putnum_2(t_seconds);

    // date
    setcursor(BS_COLUMN2, BS_ROW + 1);
    if (cfg_rtc) {
        byte day, month, year;
        ds1307_getdate(&day, &month, &year);
        putnum_2(day);
        putchar('-');
        putnum_2(month);
        puts("-20");
        putnum_2(year);
    } else {
        puts("(RTC not available)");
    }

    // keyboard layout
    setcursor(BS_COLUMN2, BS_ROW + 2);
    puts("DE");
}

static int input_number(byte col, byte row, byte digits, byte *abort) {
    int num = 0;
    int i;
    char orig_char = getscreenchar(col, row);
    while (digits > 0) {
        byte wait = 1;
        do {
            // TODO use cursor
            setchar(col, row, orig_char + 128);
            waitforchar(5);
            if (!haschar()) {
                setchar(col, row, orig_char);
                waitforchar(5);
            }
            char c = getchar_nowait();
            if (c == KEY_ESCAPE) {
                *abort = 1;
                return 0;
            }
            if (c >= '0' && c <= '9') {
                setchar(col, row, c);
                num = num * 10 + c - '0';
                wait = 0;
            }
        } while (wait);
        col++;
        digits--;
    }
    return num;
}

static void input_time() {
    byte abort = 0;
    byte hours = input_number(BS_COLUMN2, BS_ROW, 2, &abort);
    if (abort) return;
    byte minutes = input_number(BS_COLUMN2 + 3, BS_ROW, 2, &abort);
    if (abort) return;
    byte seconds = input_number(BS_COLUMN2 + 6, BS_ROW, 2, &abort);
    if (abort) return;

    if (hours > 23) hours = 23;
    if (minutes > 59) minutes = 59;
    if (seconds > 59) seconds = 59;
    asm volatile ("CLI");
    t_hours = hours;
    t_minutes = minutes;
    t_seconds = seconds;
    asm volatile ("STI");
    if (cfg_rtc) ds1307_settime(hours, minutes, seconds);
}

static void input_date() {
    byte abort = 0;
    byte day = input_number(BS_COLUMN2, BS_ROW + 1, 2, &abort);
    if (abort) return;
    byte month = input_number(BS_COLUMN2 + 3, BS_ROW + 1, 2, &abort);
    if (abort) return;
    byte year = input_number(BS_COLUMN2 + 8, BS_ROW + 1, 2, &abort);
    if (abort) return;

    if (day > 31) day = 31;
    if (month > 12) month = 12;
    ds1307_setdate(day, month, year);
}

static void input_keylayout() {

}

void bios_setup() {
    int i;

    for (i = 1; i < 23; i++)
        clrrow(i);
    for (i = 0; i < 80; i++)
        setchar(i, 24, ' ' + 128);

    byte exit = 0;
    do {
        setcursor(BS_COLUMN, BS_ROW);
        puts("[1] Time");
        setcursor(BS_COLUMN, BS_ROW + 1);
        puts("[2] Date");
        setcursor(BS_COLUMN, BS_ROW + 2);
        puts("[3] Keyboard layout");

        i = 0;
        while (!haschar()) {
            if (++i == 2000) {
                i = 0;
                update_values();
            }
        }

        char c = getchar_nowait();
        switch (c) {
            case '1':
                input_time();
                break;
            case '2':
                input_date();
                break;
            case '3':
            input_keylayout();
                break;
            case KEY_ESCAPE:
                exit = 1;
                break;
        }

    } while (!exit);

    reboot();
}
