svpetry/Mini8086/Apps/BIOS/src/bios_api.h

#ifndef BIOS_API_H
#define BIOS_API_H

#include "../../Lib/types.h"

extern volatile word int_ax;
extern volatile word int_bx;
extern volatile word int_cx;
extern volatile word int_dx;
extern volatile word int_si;
extern volatile word int_di;

void int_bios();

#endif
