svpetry/Mini8086/Apps/BIOS/src/defs.h

#ifndef DEFS_H
#define DEFS_H

/*
    connected LC display
    0: none
    1602: LCD 16x2
    2004: LCD 20x4
*/
#define LCD 0

// SD debug mode
#define SD_DEBUG 0

// keyboard debug mode
#define KEYB_DEBUG 0

#endif
