svpetry/Mini8086/(commit log)

2020-09-02 Added eagle schematics and layout
    [main.brd, main.sch]
2020-10-03 Updated eagle files
    [backplane.brd, backplane.sch, io.brd, io.sch, main.brd, main.sch, ram.brd, ram.sch]
2020-10-03 Added KiCad files and updated gitignore
    [connector.sch, cpu.sch, glue logic.sch, latches.sch, main.kicad_pcb, main.sch, pic_timer.sch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]
2020-10-03 Added gerber files for backplane and ram card
2020-10-07 Updated graphics adapter and main schematics + board.
    [connector.sch, cpu.sch, glue logic.sch, latches.sch, main.kicad_pcb, pic_timer.sch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]
2020-10-07 Added kicad custom library
2020-10-14 Added KiCad files for IO board.
    [PS2.sch, SD drive.sch, connector.sch, io_board.kicad_pcb, io_board.sch, serial.sch]
2020-10-14 Update KiCad library
2020-10-14 Updated KiCad VGA board and main board.
    [connector.sch, cpu.sch, glue logic.sch, main.kicad_pcb, pic_timer.sch, rom.sch, vga.kicad_pcb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]
2020-10-31 Updated IO ports, interrupts and address space.
2020-10-31 Updated KiCad library.
2020-10-31 Updated IO board schematics and board.
    [PS2.sch, SD drive.sch, SD misc.sch, connector.sch, io_board.kicad_pcb, io_board_0.sch, misc.sch, serial.sch]
2020-10-31 Updated main system board schematics and board.
    [connector.sch, cpu.sch, main.kicad_pcb, main.sch, pic_timer.sch, rom.sch]
2020-10-31 Added info board.
    [LCD.sch, LEDs 1.sch, LEDs 2.sch, info_board.kicad_pcb, info_board.sch]
2020-10-31 Updated graphics adapter
    [connector.sch, glue logic.sch, latches.sch, ram.sch, vga.kicad_pcb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]
2020-10-31 Updated KiCad custom library
2020-11-02 Removed unneeded Eagle files.
    [io.brd, io.sch, main.brd, main.sch, vga.brd, vga.sch, vga_smd.brd, vga_smd.sch]
2020-11-07 Fixed main and info_board bugs.
    [cpu.sch, glue logic.sch, info_board.kicad_pcb, main.kicad_pcb, pic_timer.sch]
2020-11-07 Fixed BIOS bugs, added more debugging code.
    [bios.c, start.c]
2020-11-07 Worked on I/O board.
    [PS2.sch, SD drive.sch, SD misc.sch, connector.sch, io_board.kicad_pcb, io_board.sch, misc.sch, serial.sch]
2020-11-21 Added ST16C550CJ44 to KiCad library.
2020-11-21 Working on IO board
    [PS2.sch, SD drive.sch, SD misc.sch, connector.sch, io_board.kicad_pcb, io_board.sch, misc.sch, serial.sch]
2020-11-21 Added I2C to IO board.
    [I2C.sch]
2020-11-21 Replaced MAX7000 CPLD with MAX II in graphics adapter. PCB redesign with smaller size.
    [clock.sch, connector.sch, glue logic.sch, latches.sch, main.kicad_pcb, misc.sch, ram.sch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]
2020-12-05 Finished VGA adapter Rev. 1.0
    [connector.sch, glue logic.sch, latches.sch, misc.sch, vga.kicad_pcb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]
2020-12-05 Fixed CPU board bugs.
    [cpu.sch, main.kicad_pcb]
2020-12-05 Added VGA Rev. 1.0 gerber files
2020-12-09 Continued work on I/O board.
    [I2C.sch, PS2.sch, SD drive.sch, SD misc.sch, io_board.kicad_pcb, misc.sch, serial.sch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]
2020-12-13 Added LED info board.
    [address LEDs.sch, control LEDs.sch, data LEDs.sch, led_board.kicad_pcb, led_board.sch]
2020-12-13 Updated I/O board.
    [PS2.sch, SD drive.sch, io_board.kicad_pcb]
2020-12-13 Update VGA board.
    [vga.kicad_pcb]
2020-12-15 Updated boards (VGA, main, I/O)
    [io_board.kicad_pcb, main.kicad_pcb, vga.kicad_pcb]
2020-12-21 Updated I/O board
    [I2C.sch, PS2.sch, SD drive.sch, io_board.kicad_pcb, misc.sch, serial.sch]
2021-01-25 Fixed BIOS bugs, implemented keyboard check.
    [bios.c, bios.h, start.c]
2021-01-25 Added components to KiCad lib.
2021-01-25 Updated VGA verilog code. Fixed bugs.
    [VGA.v, VGAreg.v]
2021-01-25 Added CPU board Rev. 2 KiCad project
    [RAM.sch, connector.sch, cpu.sch, glue logic.sch, main.kicad_pcb, main.sch, pic_timer.sch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]
2021-01-25 Updated KiCad library
2021-01-25 Updated CPU board
    [cpu.sch, main.kicad_pcb]
2021-01-25 Updated LED board
    [led_board.kicad_pcb]
2021-01-25 Updated VGA board.
    [vga.kicad_pcb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]
2021-01-25 Added verilog project for Altera CPLD on CPU board Rev 2
2021-01-25 Added KiCad project for backplane Rev. 2
    [backplane.kicad_pcb, backplane.sch, slots.sch, slots2.sch]
2021-02-02 Changed USB C receptable
    [backplane.kicad_pcb, backplane.sch]
2021-02-02 Fixed data bus bugs.
    [Main.v]
2021-02-13 Fixed mainV2 CPLD bugs.
    [Main.v]
2021-02-13 Fixed backplaneV2 bugs
    [backplane.kicad_pcb, backplane.sch]
2021-02-21 Fixed VGA verilog bug.
    [VGA.v]
2021-02-21 Fixed PCB bugs in main V2
    [connector.sch, cpu.sch, main.kicad_pcb]
2021-02-21 Added I/O board Rev. 2
    [I2C.sch, PS2.sch, SD drive.sch, SD misc.sch, connector.sch, io_board.kicad_pcb, io_board.sch, io_board_0.sch]
2021-02-21 Added some kicad libs
2021-02-22 Updated KiCad versioning information in schematics. Fixed button wrong pinout in backplane. Added missing files to git.
    [I2C.sch, PS2.sch, RAM.sch, SD drive.sch, SD misc.sch, address LEDs.sch, backplane.kicad_pcb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]
2021-02-28 Fixed wrong Mini-DIN 6 footprint.
    [I2C.sch, PS2.sch, SD drive.sch, SD misc.sch, connector.sch, io_board.kicad_pcb, io_board.sch, misc.sch]
2021-03-04 Worked on SD library, fixed wrong segment size in linker file. Fixed overwritten stack by memory test.
    [bios.c, sd.c, start.c]
2021-03-04 Added symbol for MT8809 to KiCad library.
2021-03-04 Fixed I/O board issues.
    [SD drive.sch, SD misc.sch, io_board.kicad_pcb]
2021-03-30 Updated gitignore. Changed demo picture. Removed unneeded file. Fixed address in disasm.bat
    [SPI_master.v]
2021-03-30 Prepared CPU board v2 verilog code for different clock frequencies
2021-03-30 Minor changes on CPU boards
    [main.kicad_pcb, main.sch, misc.sch]
2021-03-30 Minor changes at I/O board, LED board and VGA
    [io_board.kicad_pcb, led_board.kicad_pcb, vga.kicad_pcb]
2021-04-04 Fixed SD library. Used far pointers for data transfers.
    [ff.c, sd.c]
2021-04-04 Fixed wrong CPU speed measurement.
    [start.c]
2021-04-06 Fixed wrong I2C documentation
2021-04-07 Added I2C and EEPROM libraries
2021-04-08 Added library for BMP280 sensor.
2021-04-17 Fixed BIOS keyboard support.
    [biosfunc.c, boot.c, keyboard.c, start.c]
2021-04-30 Added reboot function. Renamed boot.bin to kernel.bin
    [biossetup.c, boot.c]
2021-05-26 Emulator: Added debug break in assembly code.
2021-05-26 Fixed assembly problems
2021-05-26 Fixes assembly problems.
2021-05-26 Resized BIOS memory area. Fixed interrupt routine bugs. Fixed FS API bugs.
    [bios_fsapi.c, boot.c, start.c]
2021-05-27 Added function to get current tick counter to BIOS API.
2021-06-10 Fixed bug in putchar.
    [bios_api.c]
2021-06-25 Added documentation.
    [connector.sch]
2021-06-28 Corrected wrong CPU frequency calculation.
    [start.c]
2021-10-08 Fixed interrupt bug.
2021-10-08 Fixed interrupt handling bug in BIOS.
2021-10-09 Fixed BIOS memory check
    [start.c]
2021-10-10 Removed unneccessary pushf and popf in interrupt handler.
2021-10-18 Fixed wrong symbol, added comment.
    [PS2.sch]
2021-10-21 Fixed interrupt handling.
2021-10-22 Fixes bugs in keyboard input handling and scheduler.
    [keyboard.c]
2021-11-01 Add filter for DIR command. Decrease memory size for COMMAND to 12k
2021-11-03 Fix process termination. Fix bugs with interrupt handling.
    [boot.c]
2021-11-13 Improve cursor behaviour. Fixes interrupt handling problems. Fix scroll routines.
    [bios.c, bios_api.c]
2021-11-20 Fix filesystem api bug.
    [bios_fsapi.c]
2021-11-21 Adds documentation. Adds 80386 SX KiCad model.
2021-11-22 Fixes getchar() behaviour. Adds getchar_nowait()
    [bios.c, bios_api.c, bios_setup.c, keyboard.c, keyboard.h]
2021-11-30 Adds fix for VT82C42 keyboard controller.
    [PS2.sch]
2023-02-26 Migration from KiCad 5 to KiCad 7
    [I2C.kicad_sch, I2C.sch, LCD.kicad_sch, LCD.sch, LEDs 1.sch, LEDs 2.sch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]
2023-03-11 Set global label margin to 37.5%
    [I2C.kicad_sch, LCD.kicad_sch, PS2.kicad_sch, RAM.kicad_sch, SD drive.kicad_sch, SD misc.kicad_sch, backplane.kicad_sch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]
